osrf/sandia-hand/docs/attachments/SandiaHand(2f)FAQ(2f)PalmTroubleshooting/palm_led.jpg

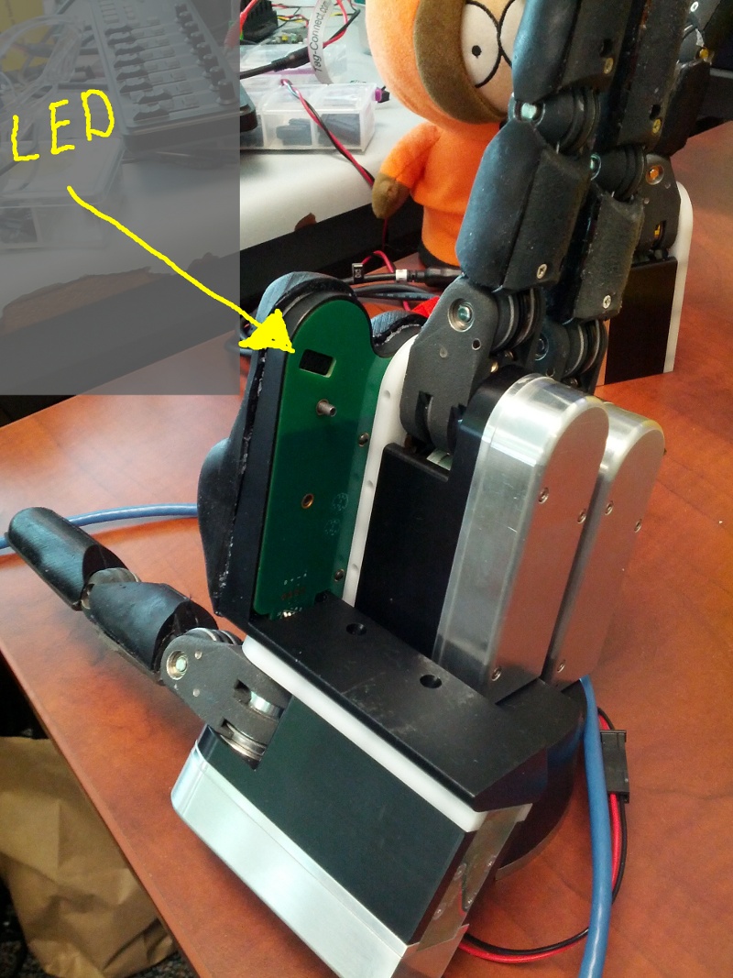
docs/attachments/SandiaHand(2f)FAQ(2f)PalmTroubleshooting/palm_led.jpg
