osrf/sandia-hand/docs/attachments/SandiaHand(2f)HardwareBringup(2f)Homing/SandiaHandsHome.jpg

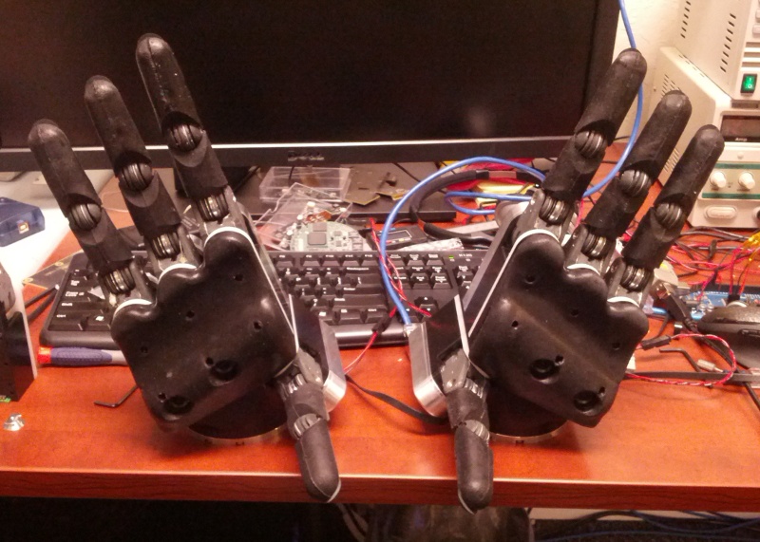
docs/attachments/SandiaHand(2f)HardwareBringup(2f)Homing/SandiaHandsHome.jpg
