osrf/sandia-hand/README.md

# Sandia Hand

Documentation is hosted from the `docs` directory of this repo via GitHub Pages and can be reached here:
[Sandia Hand Documentation and User's Manual](https://osrf.github.io/sandia-hand/)
