osrf/sandia-hand/docs/attachments/SandiaHand(2f)Overview(2f)Electrical/rpalm_tactile_array.png

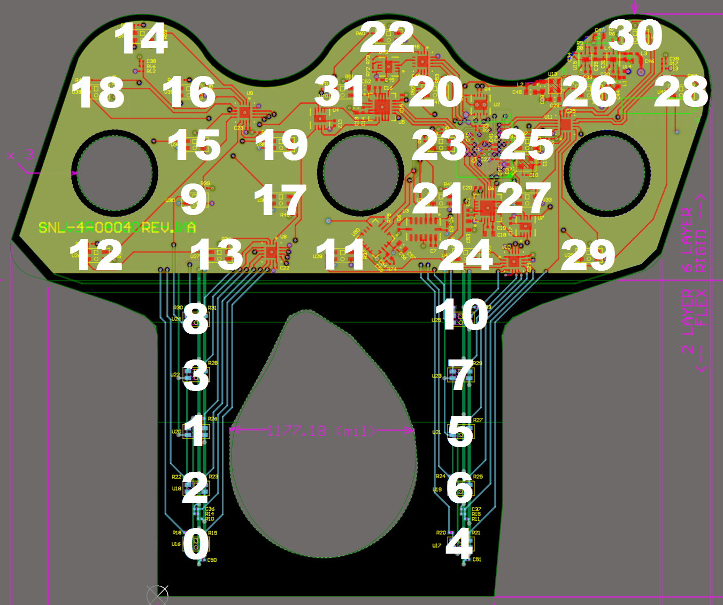
docs/attachments/SandiaHand(2f)Overview(2f)Electrical/rpalm_tactile_array.png
