osrf/sandia-hand/ros/sandia_hand_description/meshes/f1.stl

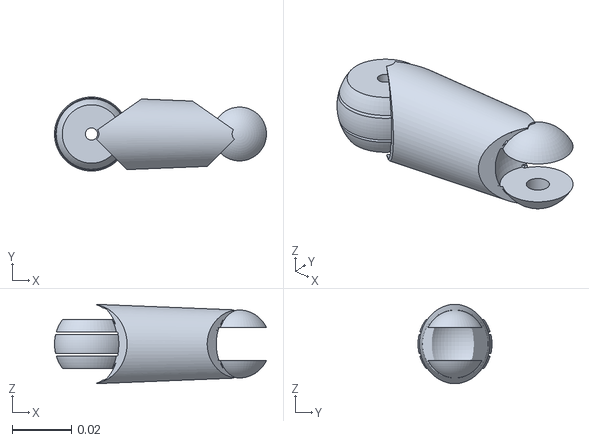
[picture p4: CAD file, 2012-12-11]
ros/sandia_hand_description/meshes/f1.stl
0.0716 x 0.025 x 0.0267
