osrf/sandia-hand/ros/sandia_hand_description/meshes/f0.stl

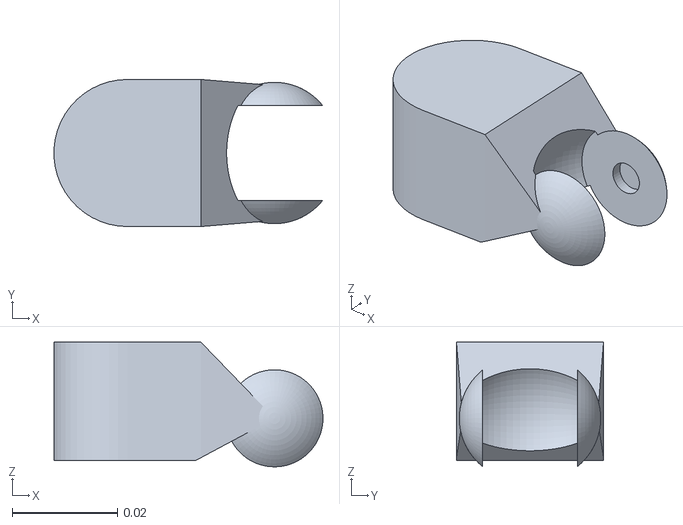
[picture p5: CAD file, 2012-12-11]
ros/sandia_hand_description/meshes/f0.stl
0.0512 x 0.028 x 0.0237
