osrf/sandia-hand/ros/sandia_hand_description/meshes/palm.stl

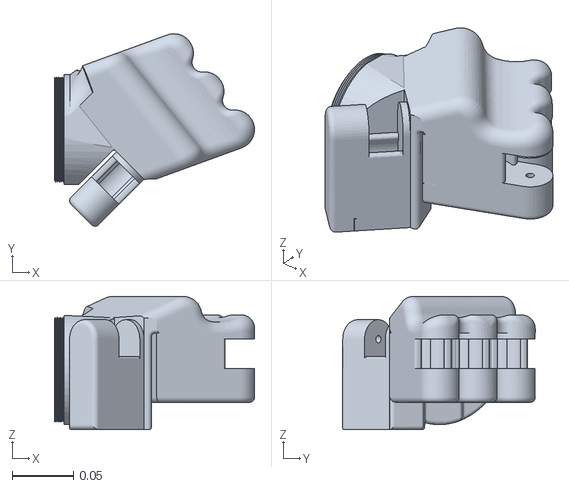
[picture p6: CAD file, 2012-12-11]
ros/sandia_hand_description/meshes/palm.stl
0.164 x 0.158 x 0.109
