osrf/sandia-hand/ros/sandia_hand_description/meshes/f2.stl

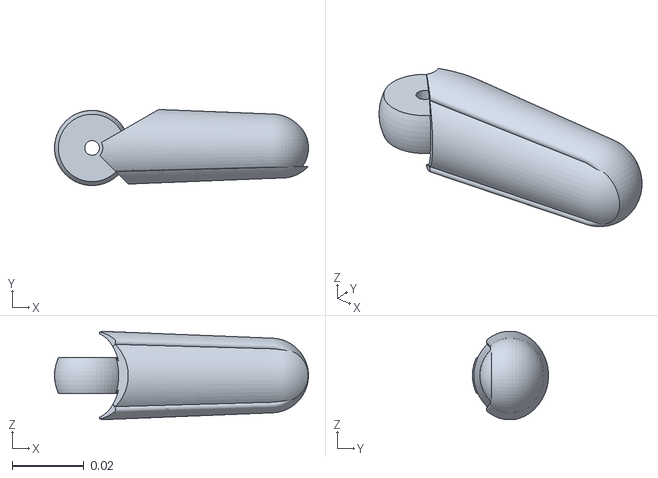
[picture p7: CAD file, 2012-12-11]
ros/sandia_hand_description/meshes/f2.stl
0.0709 x 0.0213 x 0.0247
