osrf/sandia-hand/docs/attachments/SandiaHand(2f)HardwareBringup(2f)Fuse/fuse_installation.png

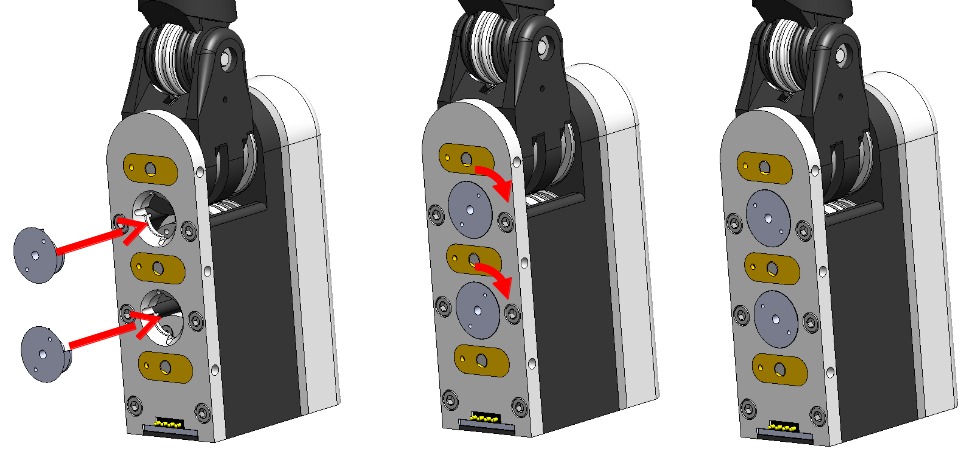
docs/attachments/SandiaHand(2f)HardwareBringup(2f)Fuse/fuse_installation.png
