osrf/sandia-hand/docs/attachments/SandiaHand(2f)HardwareBringup(2f)CableTensioning/tensioning.png

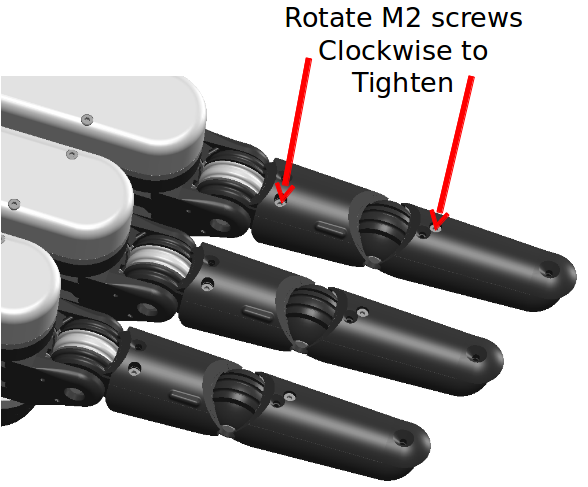
docs/attachments/SandiaHand(2f)HardwareBringup(2f)CableTensioning/tensioning.png
