osrf/sandia-hand/docs/attachments/SandiaHand(2f)HardwareBringup(2f)FingerAttachment/finger_attachment.png

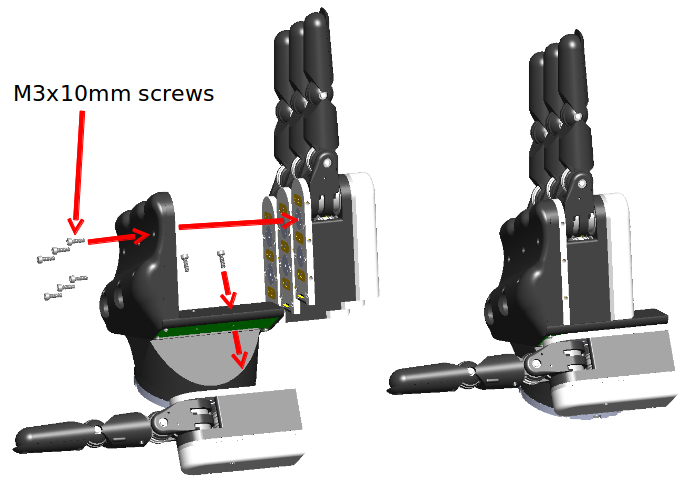
docs/attachments/SandiaHand(2f)HardwareBringup(2f)FingerAttachment/finger_attachment.png
