osrf/sandia-hand/ros/sandia_hand_description/urdf/sandia_hand.urdf.xacro

<?xml version="1.0"?>

<robot name="sandia_hand" xmlns:xacro="http://www.ros.org/wiki/xacro">

  <xacro:include filename="$(find sandia_hand_description)/urdf/sandia_hand.gazebo.xacro" />
  <xacro:include filename="$(find sandia_hand_description)/urdf/sandia_hand.transmission.xacro" />

  <xacro:property name="M_pi" value="3.1415926535897931" />
  <xacro:property name="damping_coefficient_j0" value="1.0" />
  <xacro:property name="damping_coefficient_j1" value="1.0" />
  <xacro:property name="damping_coefficient_j2" value="1.0" />
  <xacro:property name="velocity_limit" value="-1" />

  <xacro:macro name="finger" params="idx x y z r p yaw side reflect joint_type">
    <link name="${side}_f${idx}_base">
      <origin xyz="0 0 0" rpy="0 0 0"/>
      <inertial>
        <!-- total mass is 2.303 kg, palm is about 1.303 kg, distribute the rest into _base -->
        <mass value="0.250"/> <!-- (2.303 - 1.303) / 4 -->
        <origin xyz="0 0 0"/>
        <!-- model as sphere with radius of 1cm -->
        <inertia ixx="0.00001" ixy="0" ixz="0" iyy="0.00001" iyz="0" izz="0.00001"/>
      </inertial>
    </link>
    <link name="${side}_f${idx}_fixed_accel">
      <origin xyz="0 0 0" rpy="0 0 0"/>
      <inertial>
        <mass value="0.01"/>
        <origin xyz="0 0 0"/>
        <inertia ixx="0.000001" ixy="0" ixz="0" iyy="0.000001" iyz="0" izz="0.000001"/>
      </inertial>
    </link>
    <link name="${side}_f${idx}_0">
      <origin xyz="0 0 0" rpy="0 0 0"/>
      <inertial>
        <mass value="0.106"/> <!-- F1 -->
        <origin xyz="0 0 0"/>
        <!-- solid cylinder -->
        <inertia ixx="0.000011925" ixy="0" ixz="0" iyy="0.00011505" iyz="0" izz="0.00011505"/>
      </inertial>
      <collision>
        <origin xyz="0 0 0" rpy="0 0 0"/>
        <geometry>
          <mesh filename="package://sandia_hand_description/meshes/f0.stl"/>
        </geometry>
      </collision>
      <visual>
        <origin xyz="0 0 0" rpy="0 0 0"/>
        <geometry>
          <mesh filename="package://sandia_hand_description/meshes/f0.stl"/>
        </geometry>
        <material name="${side}_sandia_hand_skin_suntan">
          <color rgba="0.7 0.4 0.2 1.0"/>
        </material>
      </visual>
    </link>
    <link name="${side}_f${idx}_1">
      <origin xyz="0 0 0" rpy="0 0 0"/>
      <inertial>
        <mass value="0.033"/> <!-- F2 -->
        <origin xyz="0 0 0"/>
        <!-- solid cylinder -->
        <inertia ixx="0.00000165" ixy="0" ixz="0" iyy="0.00001316975" iyz="0" izz="0.00001316975"/>
      </inertial>
      <collision>
        <origin xyz="0 0 0" rpy="0 0 0"/>
        <geometry>
          <mesh filename="package://sandia_hand_description/meshes/f1.stl"/>
        </geometry>
      </collision>
      <visual>
        <origin xyz="0 0 0" rpy="0 0 0"/>
        <geometry>
          <mesh filename="package://sandia_hand_description/meshes/f1.stl"/>
        </geometry>
        <material name="${side}_sandia_hand_skin">
          <color rgba="0.835 0.655 0.345 1.0"/>
        </material>
      </visual>
    </link>
    <link name="${side}_f${idx}_1_accel">
      <origin xyz="0 0 0" rpy="0 0 0"/>
      <inertial>
        <mass value="0.01"/>
        <origin xyz="0 0 0"/>
        <inertia ixx="0.000001" ixy="0" ixz="0" iyy="0.000001" iyz="0" izz="0.000001"/>
      </inertial>
    </link>
    <link name="${side}_f${idx}_2">
      <origin xyz="0 0 0" rpy="0 0 0"/>
      <inertial>
        <mass value="0.033"/>  <!-- F3 -->
        <origin xyz="0 0 0"/>
        <!-- solid cylinder -->
        <inertia ixx="0.0000013365" ixy="0" ixz="0" iyy="0.000009603" iyz="0" izz="0.000009603"/>
      </inertial>
      <collision>
        <origin xyz="0 0 0" rpy="0 0 0"/>
        <geometry>
          <mesh filename="package://sandia_hand_description/meshes/f2.stl"/>
        </geometry>
      </collision>
      <visual>
        <origin xyz="0 0 0" rpy="0 0 0"/>
        <geometry>
          <mesh filename="package://sandia_hand_description/meshes/f2.stl"/>
        </geometry>
        <material name="${side}_sandia_hand_skin_suntan">
          <color rgba="0.8 0.6 0.3 1.0"/>
        </material>
      </visual>
    </link>
    <link name="${side}_f${idx}_2_accel">
      <origin xyz="0 0 0" rpy="0 0 0"/>
      <inertial>
        <mass value="0.01"/>
        <origin xyz="0 0 0"/>
        <inertia ixx="0.000001" ixy="0" ixz="0" iyy="0.000001" iyz="0" izz="0.000001"/>
      </inertial>
    </link>

    <joint name="${side}_f${idx}_base" type="fixed">
      <parent link="${side}_palm"/>
      <child link="${side}_f${idx}_base"/>
      <origin xyz="${x} ${y} ${z}" rpy="${r} ${p} ${yaw}"/>
    </joint>
    <joint name="${side}_f${idx}_j0" type="${joint_type}">
      <axis xyz="0 0 ${reflect}"/>
      <parent link="${side}_f${idx}_base"/>
      <child link="${side}_f${idx}_0"/>
      <limit lower="-${M_pi/2}" upper="${M_pi/2}" effort="11" velocity="${velocity_limit}"/>
      <safety_controller soft_lower_limit="${-1.57079-10.0}" soft_upper_limit="${1.57079+10.0}" k_position="1000.0" k_velocity="1000.0"/>
      <dynamics damping="${damping_coefficient_j0}"/>
      <origin xyz="0 0 0" rpy="0 0 0"/>
    </joint>
    <joint name="${side}_f${idx}_j1" type="${joint_type}">
      <axis xyz="0 0 1"/>
      <parent link="${side}_f${idx}_0"/>
      <child link="${side}_f${idx}_1"/>
      <limit lower="-${M_pi/2}" upper="${M_pi/2}" effort="28" velocity="${velocity_limit}"/>
      <safety_controller soft_lower_limit="${-1.57079-10.0}" soft_upper_limit="${1.57079+10.0}" k_position="1000.0" k_velocity="1000.0"/>
      <dynamics damping="${damping_coefficient_j1}"/>
      <origin xyz="0.028 0 0" rpy="${M_pi/2} 0 0"/>
    </joint>
    <joint name="${side}_f${idx}_j2" type="${joint_type}">
      <axis xyz="0 0 1"/>
      <parent link="${side}_f${idx}_1"/>
      <child link="${side}_f${idx}_2"/>
      <origin xyz="0.05 0 0" rpy="0 0 0"/>
      <safety_controller soft_lower_limit="${-1.57079-10.0}" soft_upper_limit="${1.57079+10.0}" k_position="1000.0" k_velocity="1000.0"/>
      <dynamics damping="${damping_coefficient_j2}"/>
      <limit lower="-${M_pi/2}" upper="${M_pi/2}" effort="28" velocity="${velocity_limit}"/>
    </joint>

    <joint name="${side}_f${idx}_fixed_accel" type="fixed">
      <parent link="${side}_f${idx}_base"/>
      <child link="${side}_f${idx}_fixed_accel"/>
      <origin xyz="-0.05 0 0" rpy="0 0 0"/>
    </joint>
    <joint name="${side}_f${idx}_1_accel" type="fixed">
      <parent link="${side}_f${idx}_1"/>
      <child link="${side}_f${idx}_1_accel"/>
      <origin xyz="0.03 0 0" rpy="-${M_pi/2} 0 0"/>
    </joint>
    <joint name="${side}_f${idx}_2_accel" type="fixed">
      <parent link="${side}_f${idx}_2"/>
      <child link="${side}_f${idx}_2_accel"/>
      <origin xyz="0.04 0 0" rpy="-${M_pi/2} 0 0"/>
    </joint>

    <xacro:finger_transmission side="${side}" idx="${idx}" x="${x}" y="${y}" z="${z}" r="${r}" p="${p}" yaw="${yaw}"/>
    <xacro:finger_gazebo side="${side}" idx="${idx}"/>
  </xacro:macro>

  <xacro:macro name="sandia_hand" params="side parent reflect joint_type thumb_angle *origin">
    <link name="${side}_palm">
      <origin xyz="0 0 0" rpy="0 0 0"/>
      <inertial>
        <mass value="1.303"/>
        <origin xyz="0 0 0"/>
        <!-- solid sphere with 5cm radius -->
        <inertia ixx="0.001303" ixy="0" ixz="0" iyy="0.001303" iyz="0" izz="0.001303"/>
      </inertial>
      <collision>
        <origin xyz="0 0 0" rpy="0 0 0"/>
        <geometry>
          <mesh filename="package://sandia_hand_description/meshes/palm.stl"/>
        </geometry>
      </collision>
      <visual>
        <origin xyz="0 0 0" rpy="0 0 0"/>
        <geometry>
          <mesh filename="package://sandia_hand_description/meshes/palm.stl"/>
        </geometry>
        <material name="${side}_sandia_hand_skin">
          <color rgba="0.835 0.655 0.345 1.0"/>
        </material>
      </visual>
    </link>

    <joint name="${side}_sandia_hand_joint" type="fixed">
      <parent link="${parent}"/>
      <child link="${side}_palm"/>
      <insert_block name="origin" />
    </joint>

    <xacro:finger side="${side}" idx="0" x="0.140" y="0.00000" z="0" r="0" p="0" yaw="${0.3*reflect}" reflect="${reflect}" joint_type="${joint_type}"/>
    <xacro:finger side="${side}" idx="1" x="0.115" y="${0.03122*reflect}" z="0" r="0" p="0" yaw="${0.3*reflect}" reflect="${reflect}" joint_type="${joint_type}"/>
    <xacro:finger side="${side}" idx="2" x="0.090" y="${0.06245*reflect}" z="0" r="0" p="0" yaw="${0.3*reflect}" reflect="${reflect}" joint_type="${joint_type}"/>
    <xacro:finger side="${side}" idx="3" x="0.03995" y="${-0.04383*reflect}" z="0.014" r="0" p="-${M_pi/2 + thumb_angle}" yaw="${-(2.3562+thumb_angle)*reflect}" reflect="${reflect}" joint_type="${joint_type}"/>

    <!-- not needed unless simulating the hand by itself
    <xacro:sandia_hand_gazebo_controller side="${side}" />
    -->
    <xacro:sandia_hand_gazebo side="${side}" />
    <xacro:sandia_hand_cameras_gazebo side="${side}" reflect="${reflect}" parent="${parent}" />
    <xacro:sandia_hand_tactile_sensors_gazebo side="${side}" parent="${parent}" />
    <xacro:sandia_hand_imu_sensor_gazebo parent="${parent}" />
  </xacro:macro>
</robot>
