osrf/sandia-hand/docs/attachments/SandiaHand(2f)Overview(2f)Electrical/cam.pdf

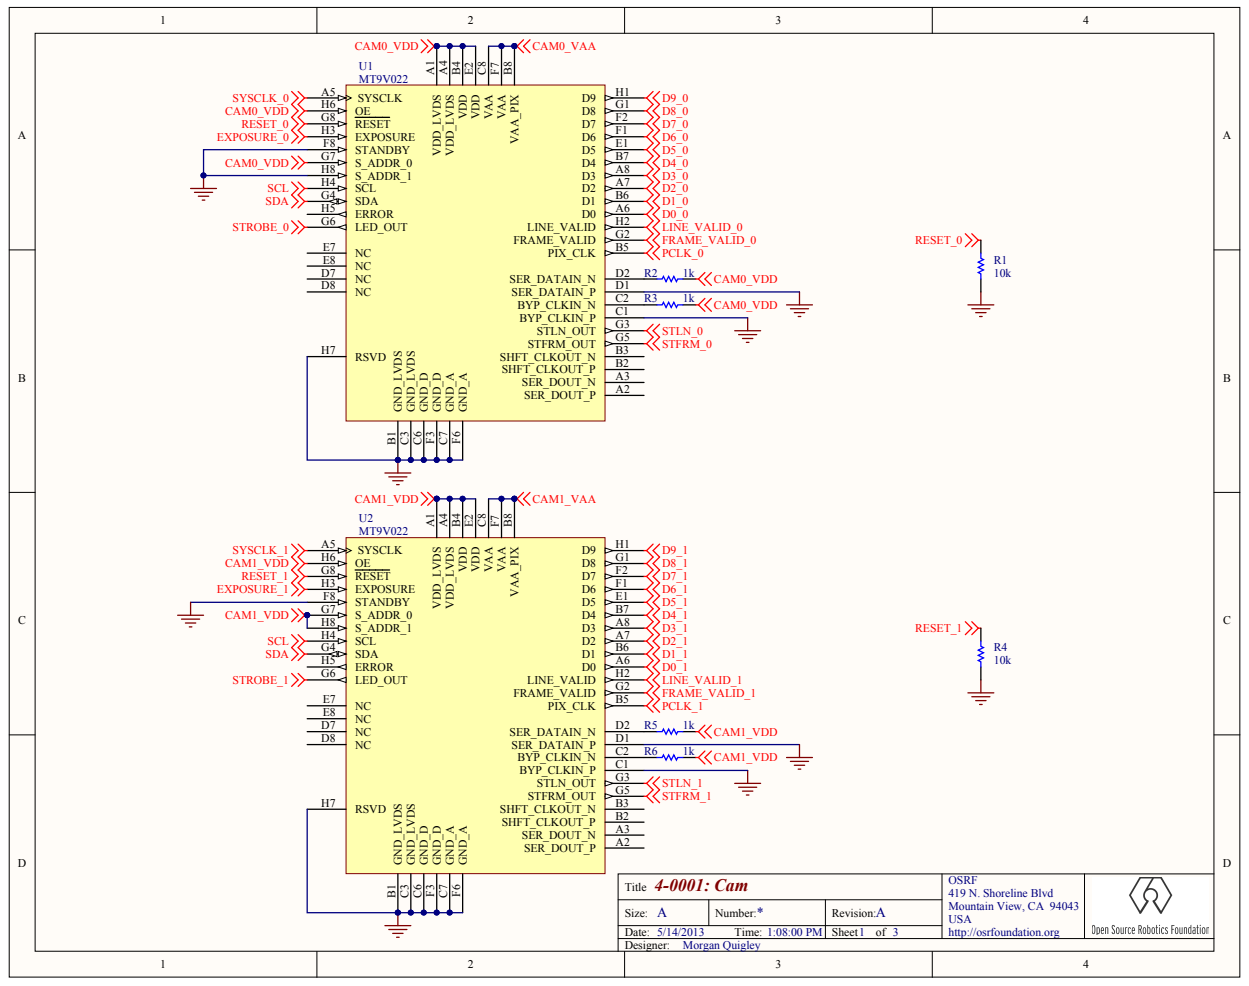
[picture p11: page 1]

4-0001: Cam Title | OSRF 419 N. Shoreline Blvd Mountain View, CA 94043 USA http://osrfoundation.org

Size: A | Number: * | Revision: A
Date: 5/14/2013 Time: 1:08:00 PM | | Sheet of 3

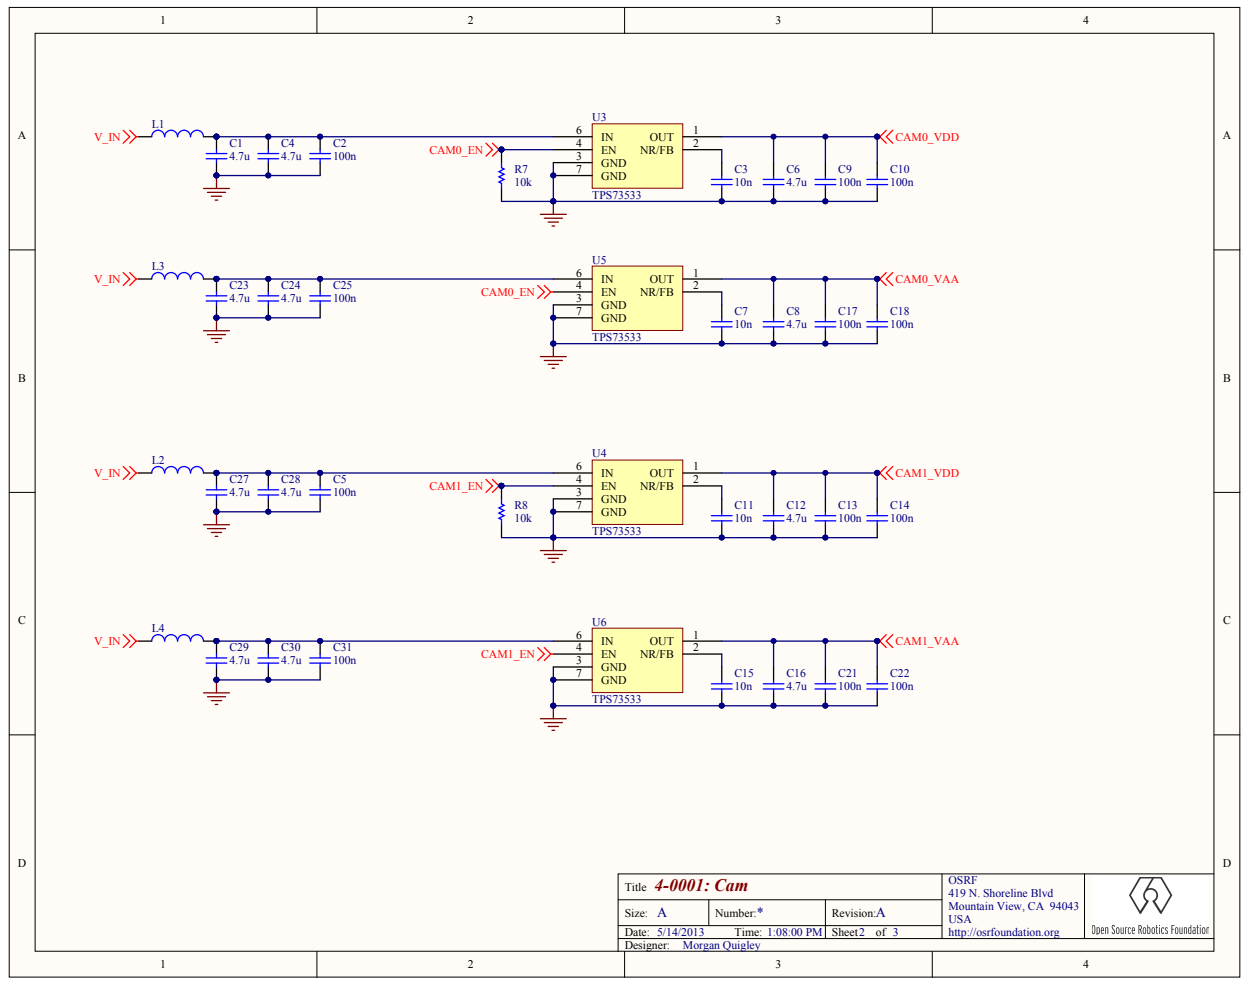
[picture p12: page 2]

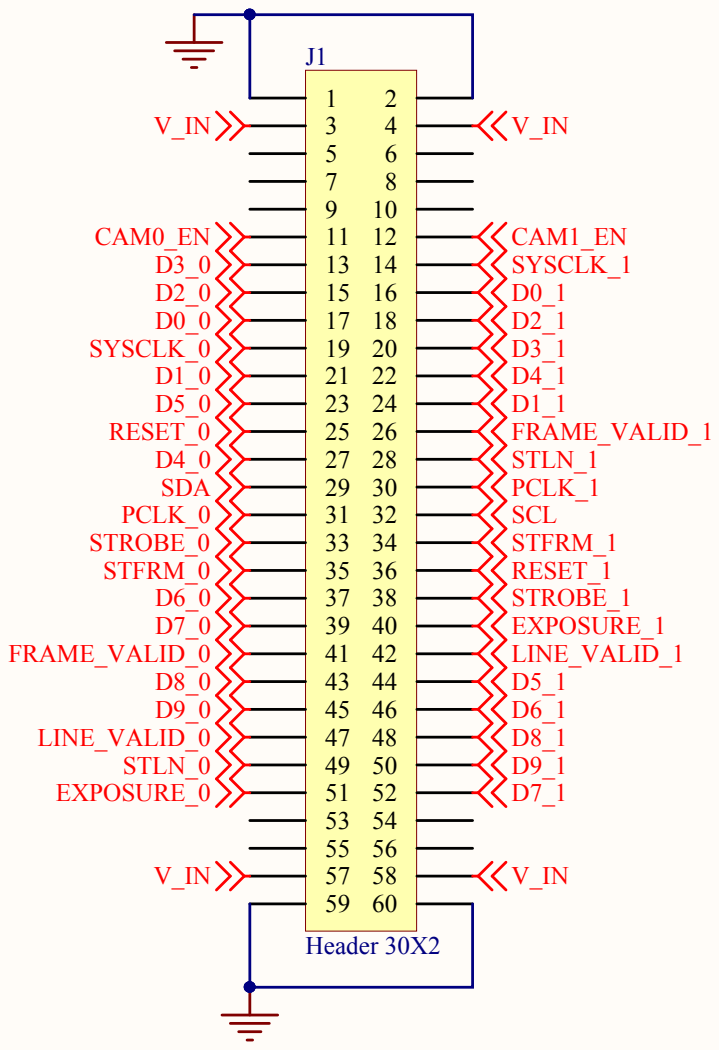
[picture p13: page 3]
