osrf/sandia-hand/docs/attachments/SandiaHand(2f)Overview(2f)Electrical/f2.pdf

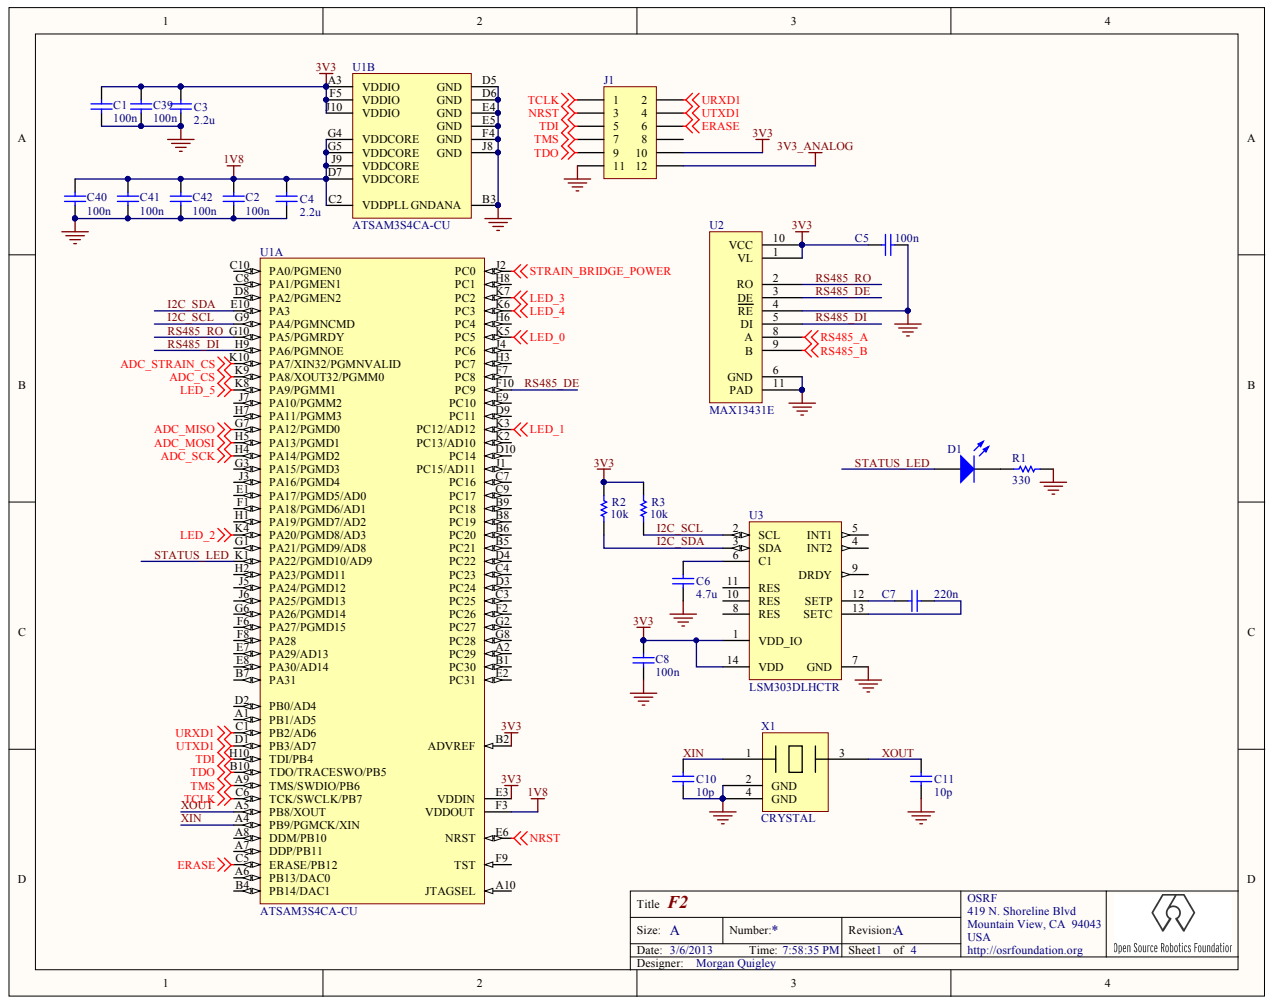
[picture p14: page 1]

F2 Title | OSRF 419 N. Shoreline Blvd Mountain View, CA 94043 USA http://osrfoundation.org

Size: A | Number: * | Revision: A
Date: 3/6/2013 Time: 7:58:35 PM | | Sheet of 4

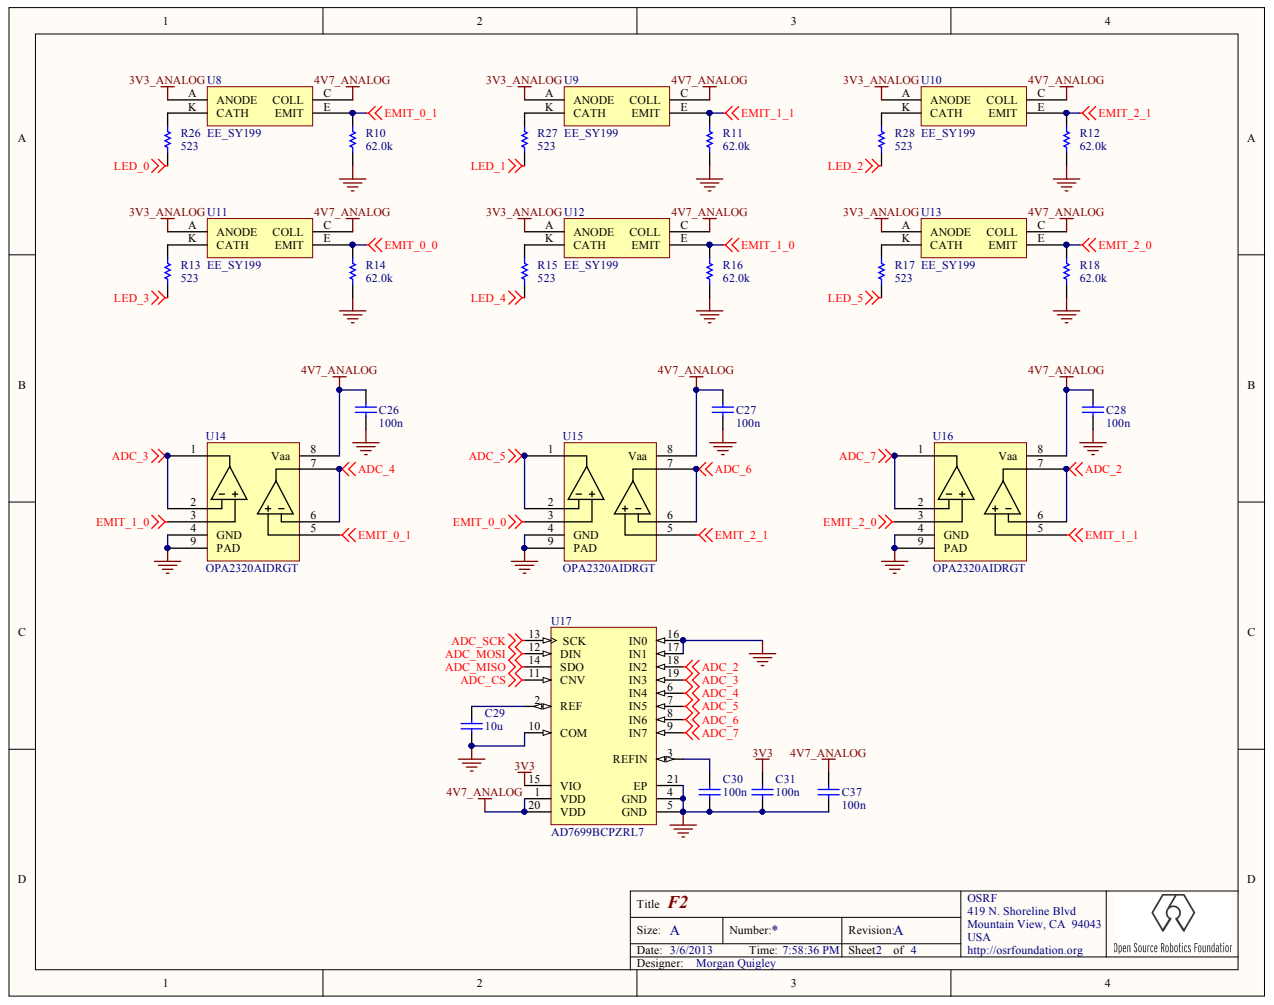
[picture p15: page 2]

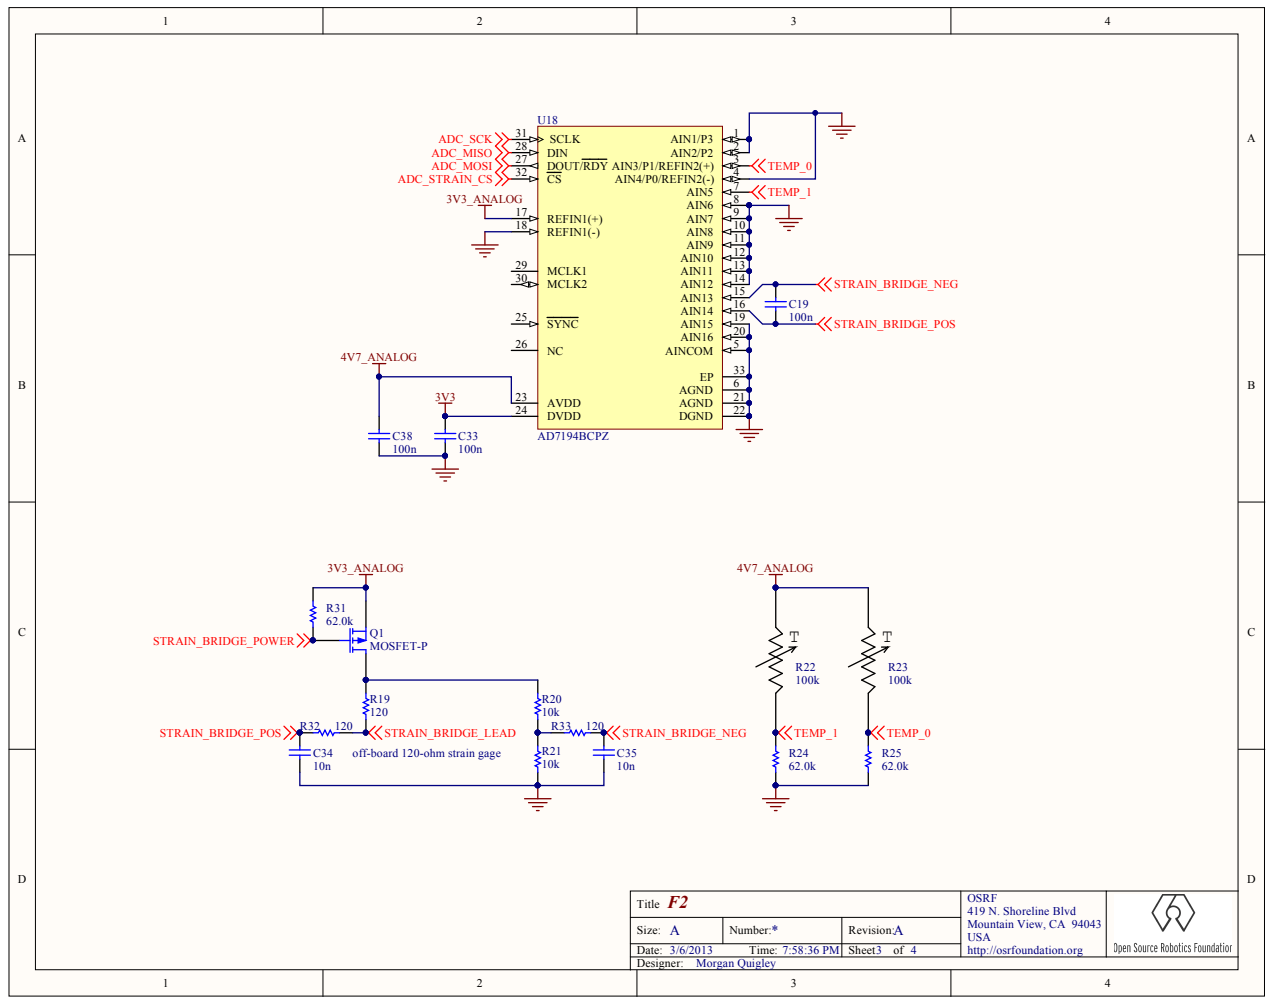
[picture p16: page 3]

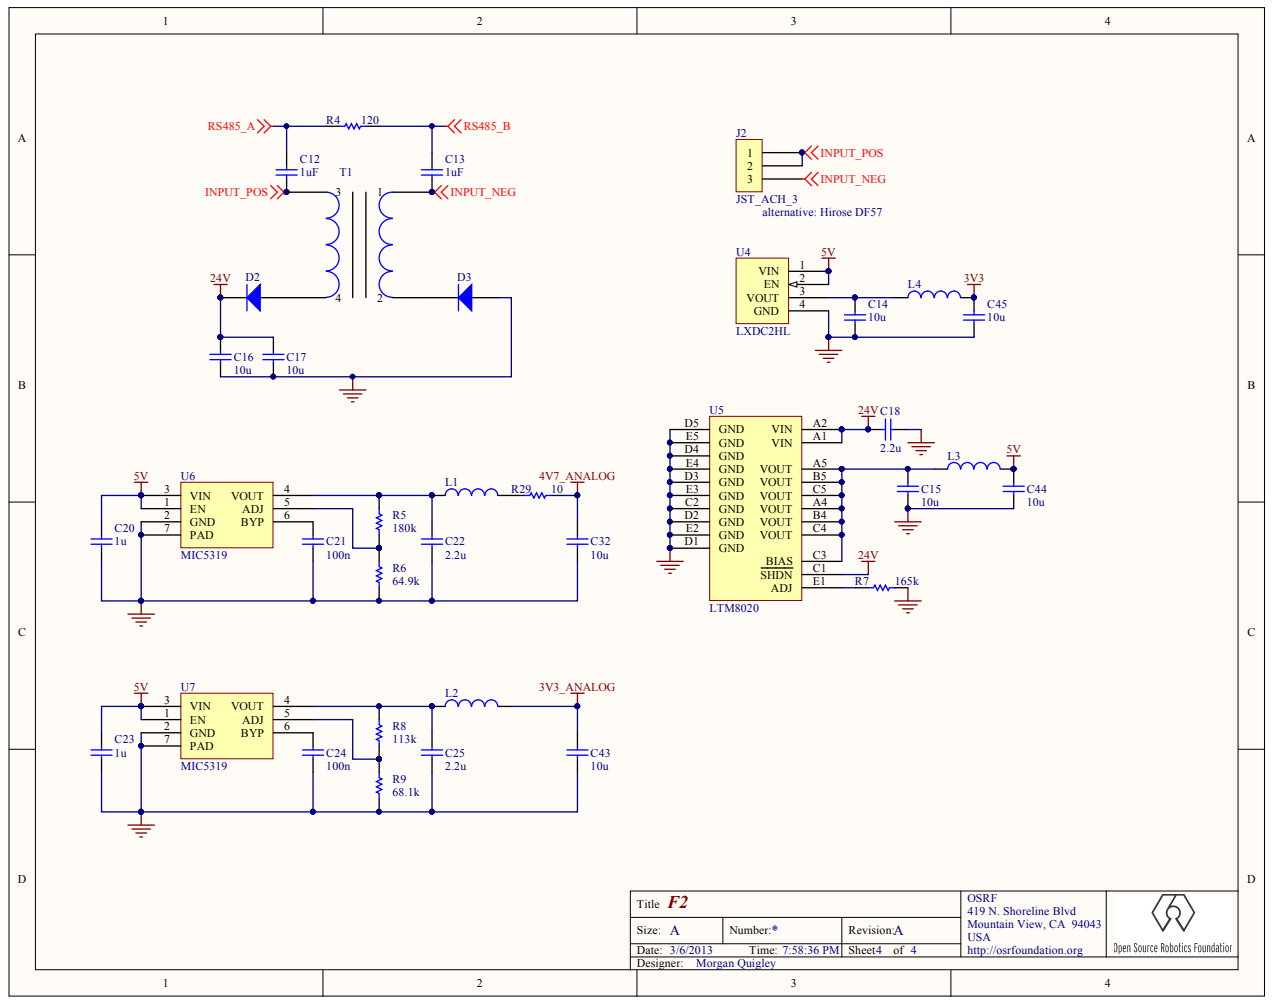
[picture p17: page 4]

PAD 7
