osrf/sandia-hand/docs/attachments/SandiaHand(2f)Overview(2f)Electrical/f3.pdf

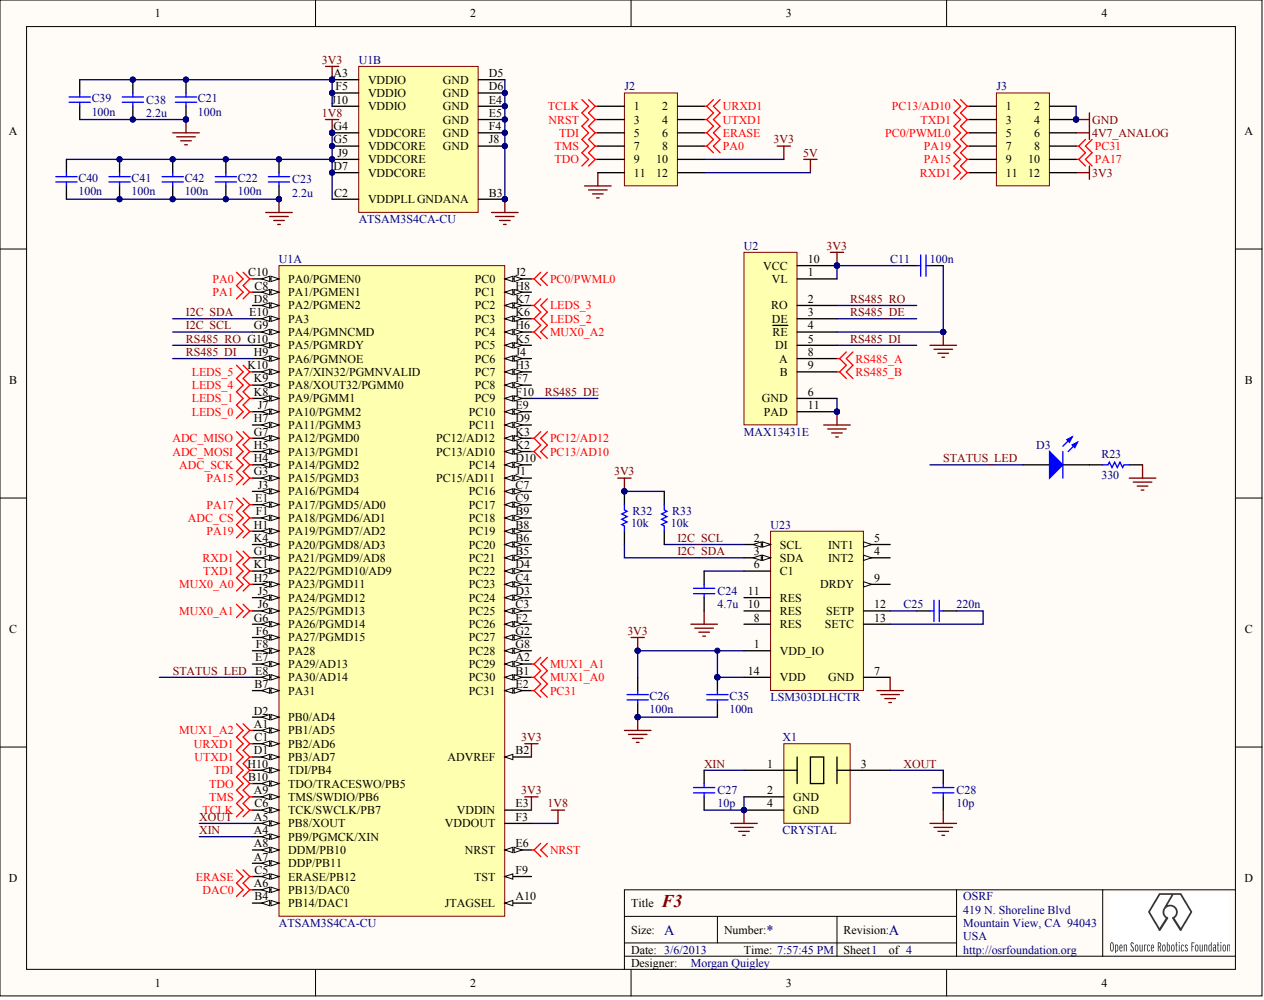
[picture p18: page 1]

F3 Title | OSRF 419 N. Shoreline Blvd Mountain View, CA 94043 USA http://osrfoundation.org

A Size: | * Number: | A Revision:
Date: 3/6/2013 Time: 7:57:45 PM | | Sheet of 4

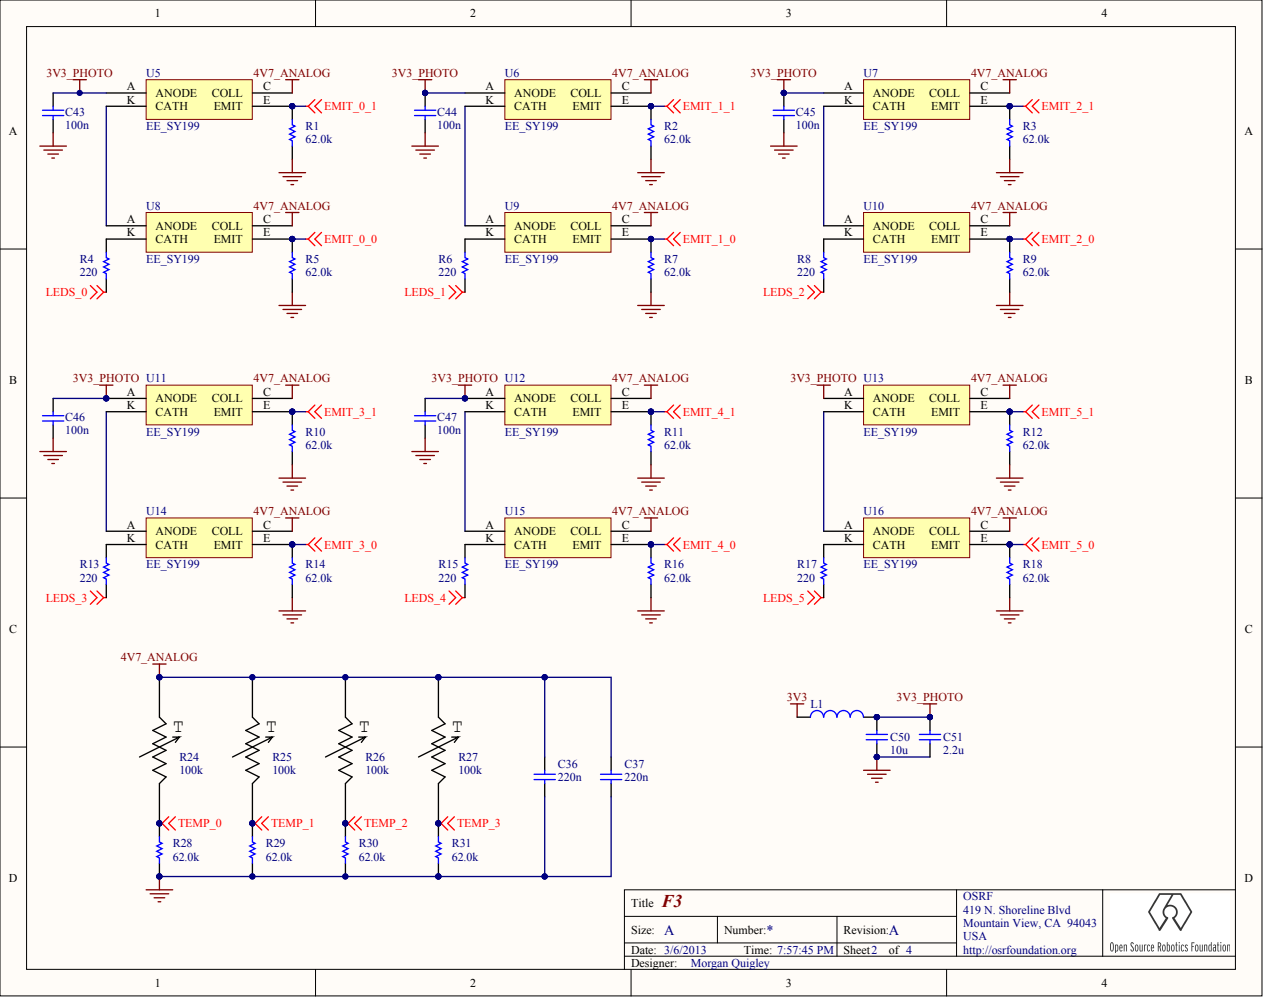
[picture p19: page 2]

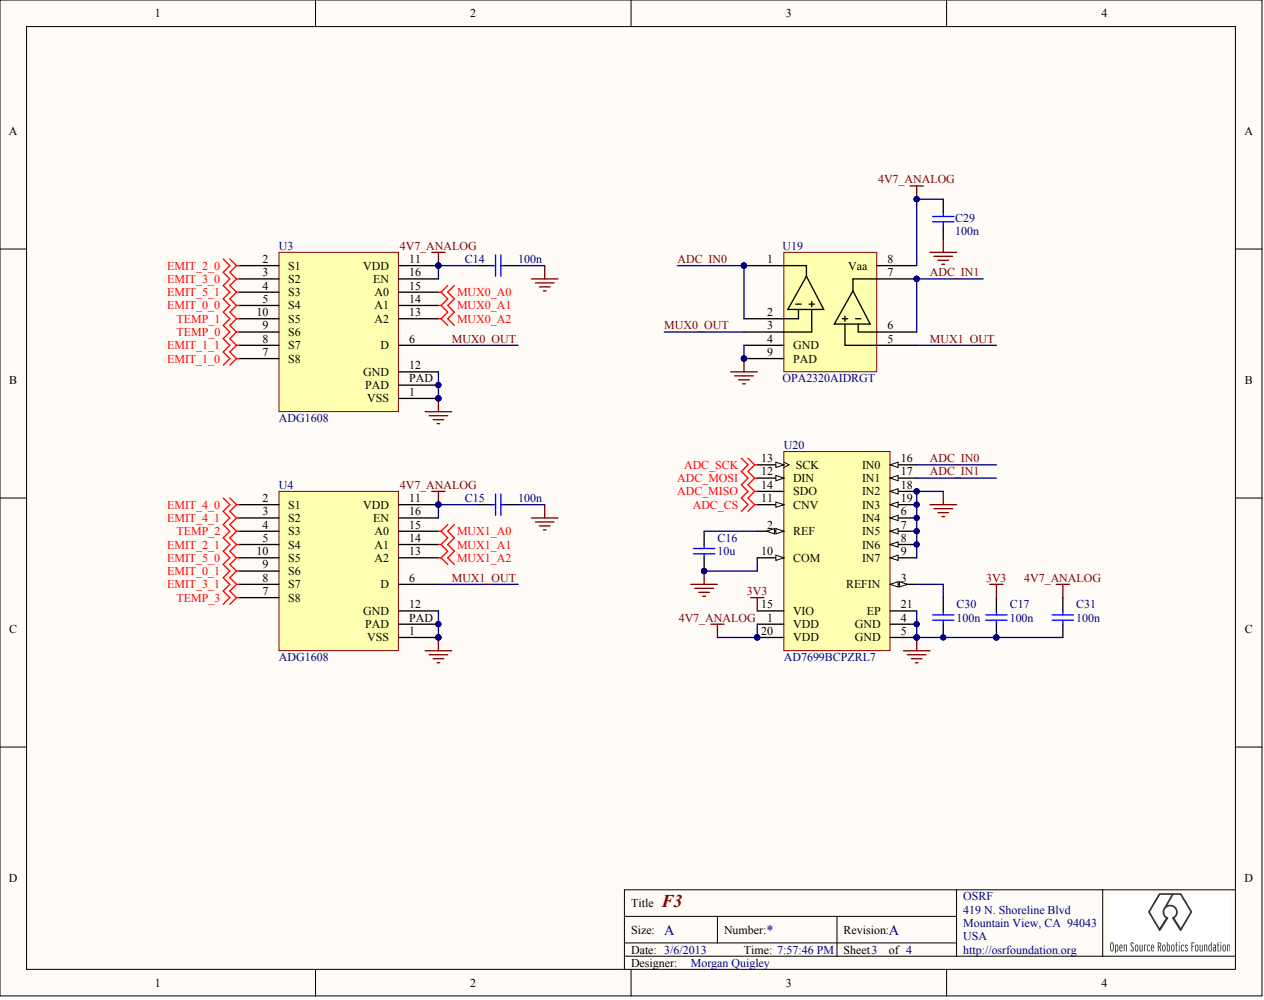
[picture p20: page 3]

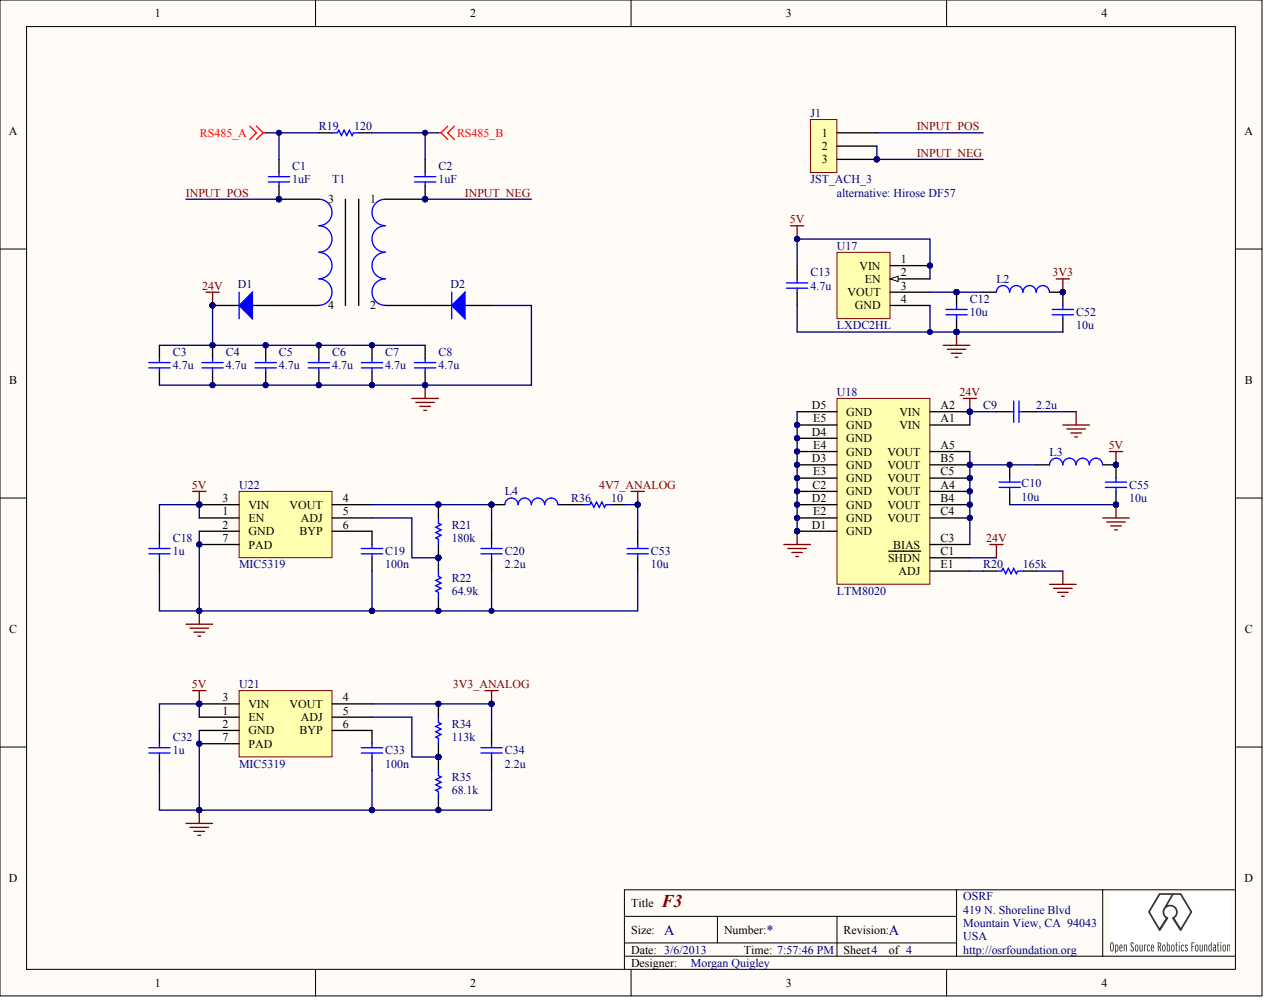
[picture p21: page 4]

4.7u | VOUT | 3

PAD 7
