osrf/sandia-hand/docs/attachments/SandiaHand(2f)Overview(2f)Electrical/fmcb.pdf

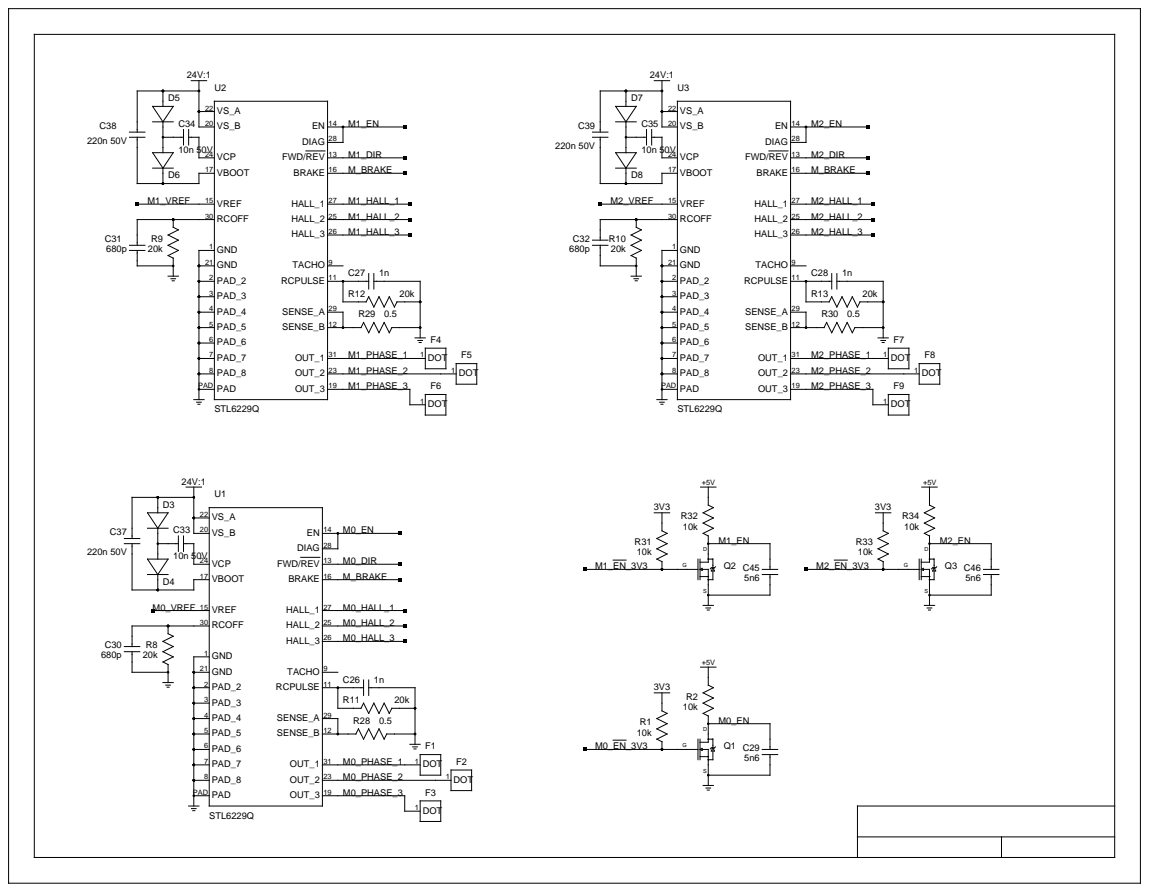
[picture p22: page 1]

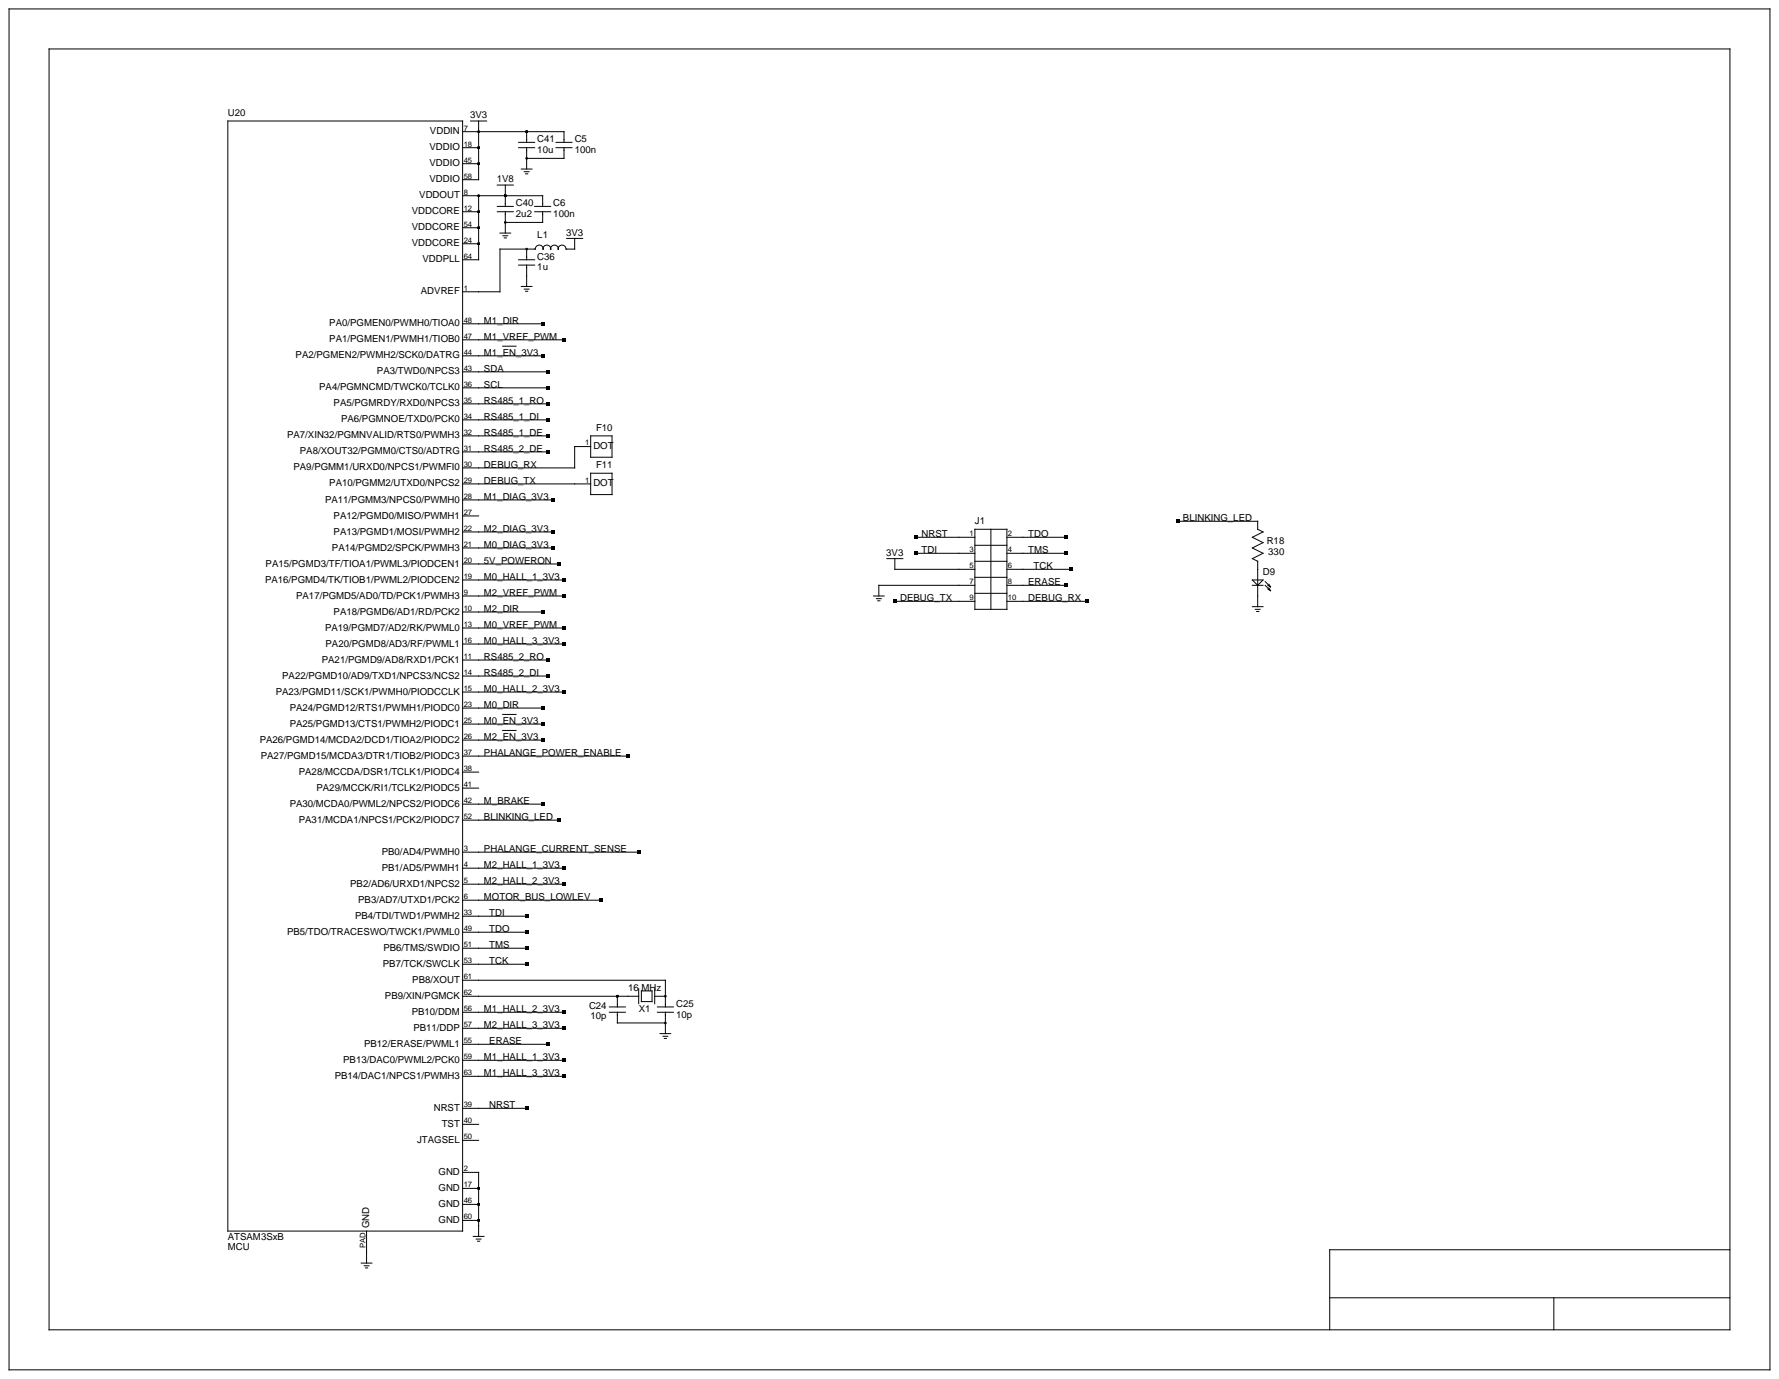
[picture p23: page 2]

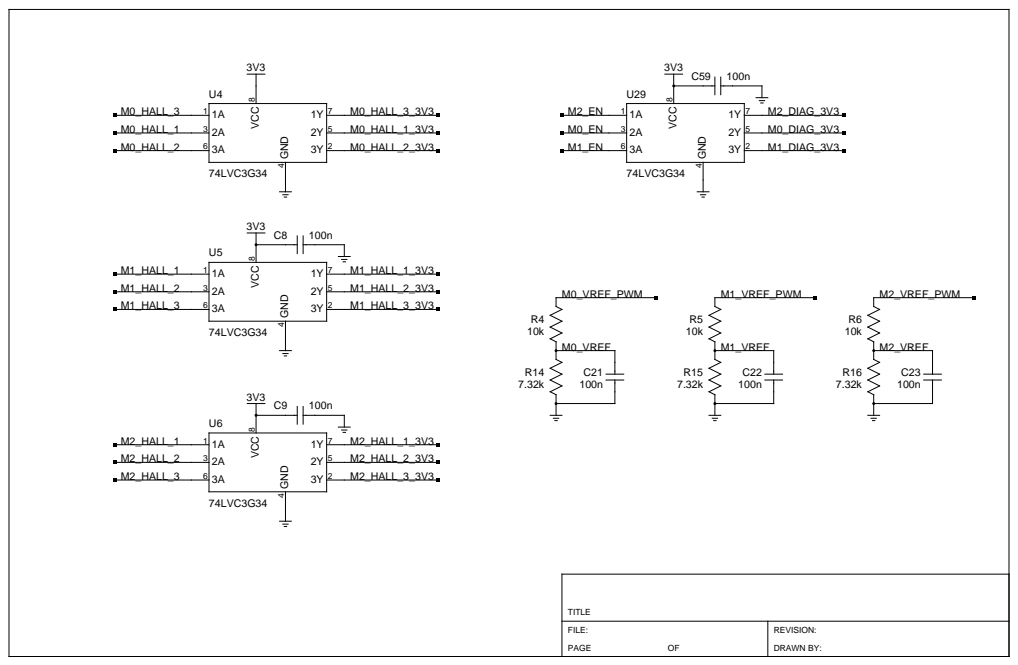
[picture p24: page 3]

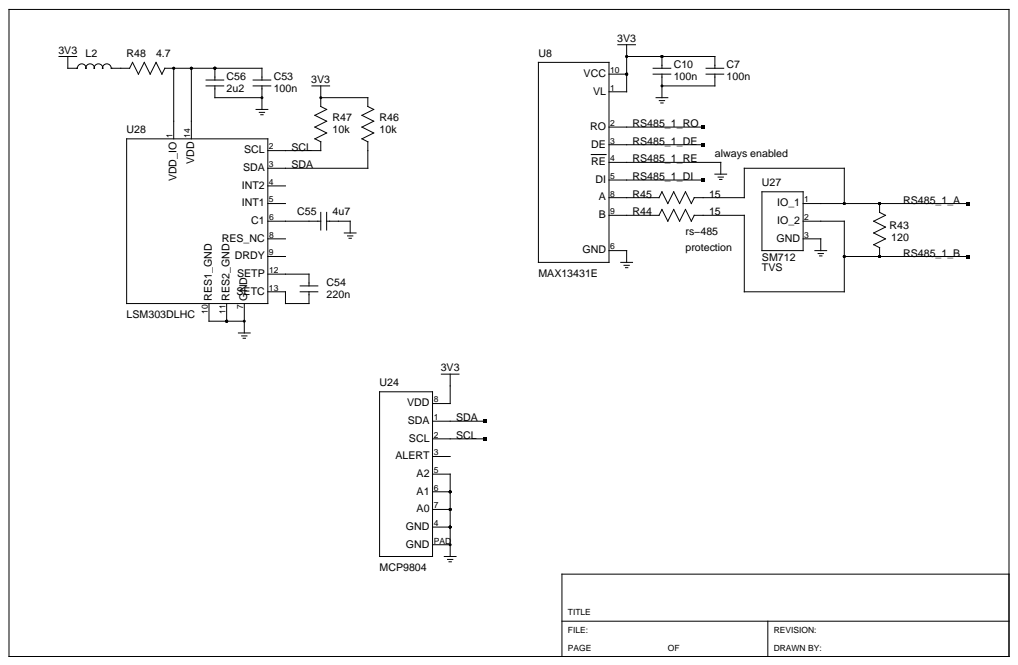
[picture p25: page 4]

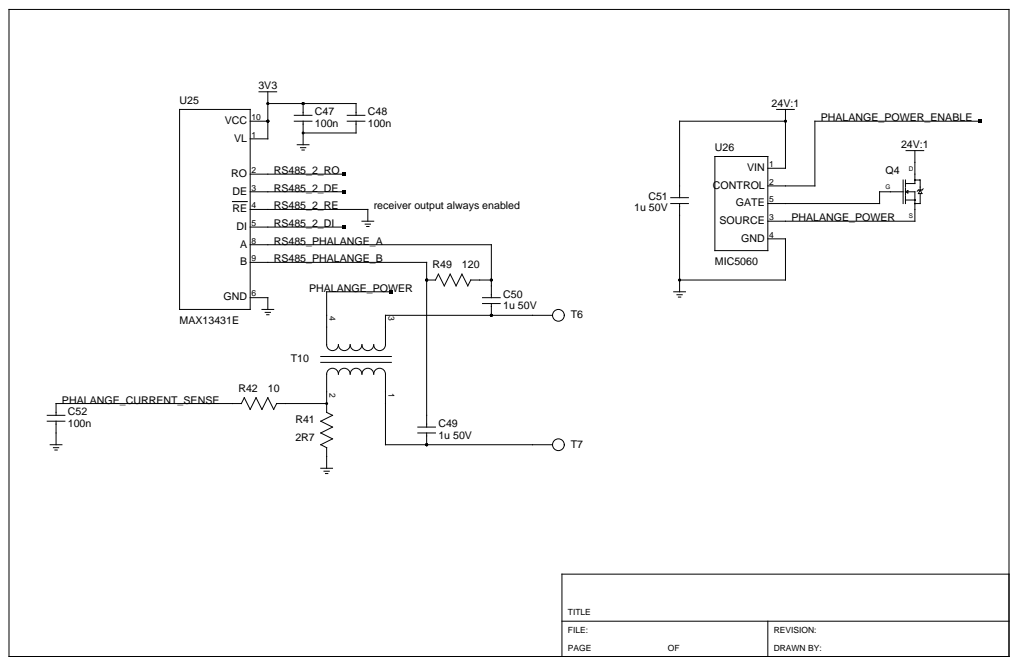
[picture p26: page 5]

receiver output always enabled

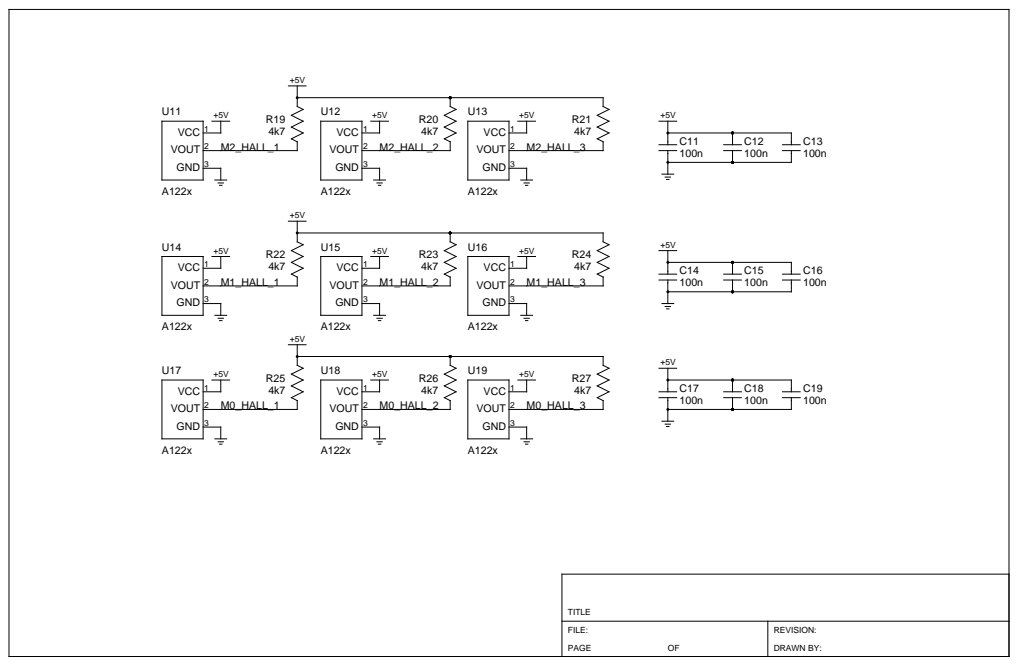
[picture p27: page 6]

3v3 always−on supply | 5v supply
pogo pins | D10

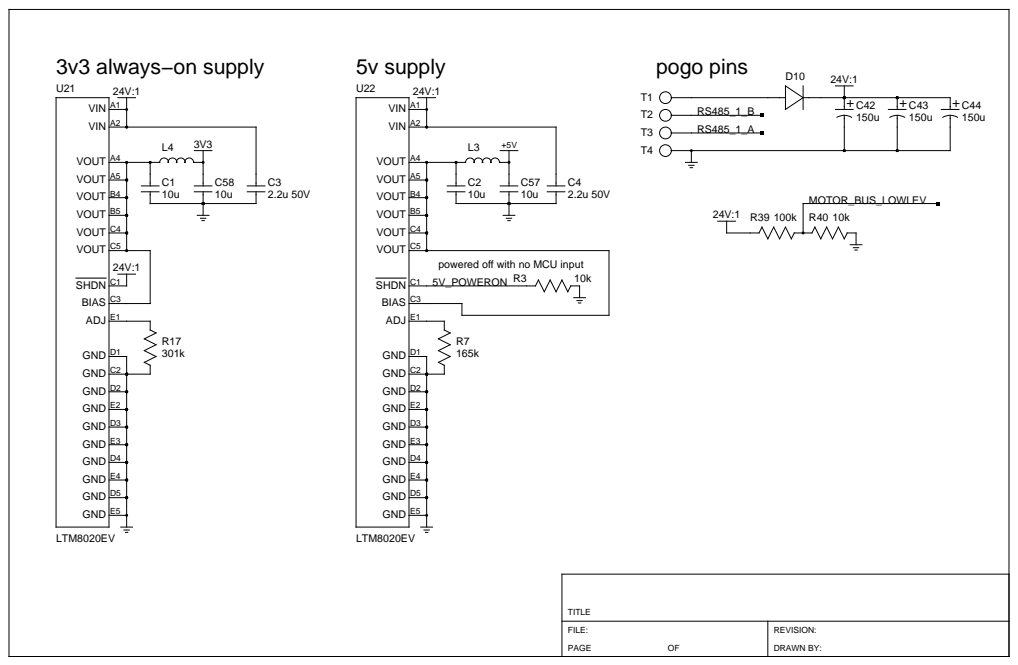
[picture p28: page 7]

powered off with no MCU input
5V_POWERON
