osrf/sandia-hand/docs/attachments/SandiaHand(2f)Overview(2f)Electrical/left_conn.pdf

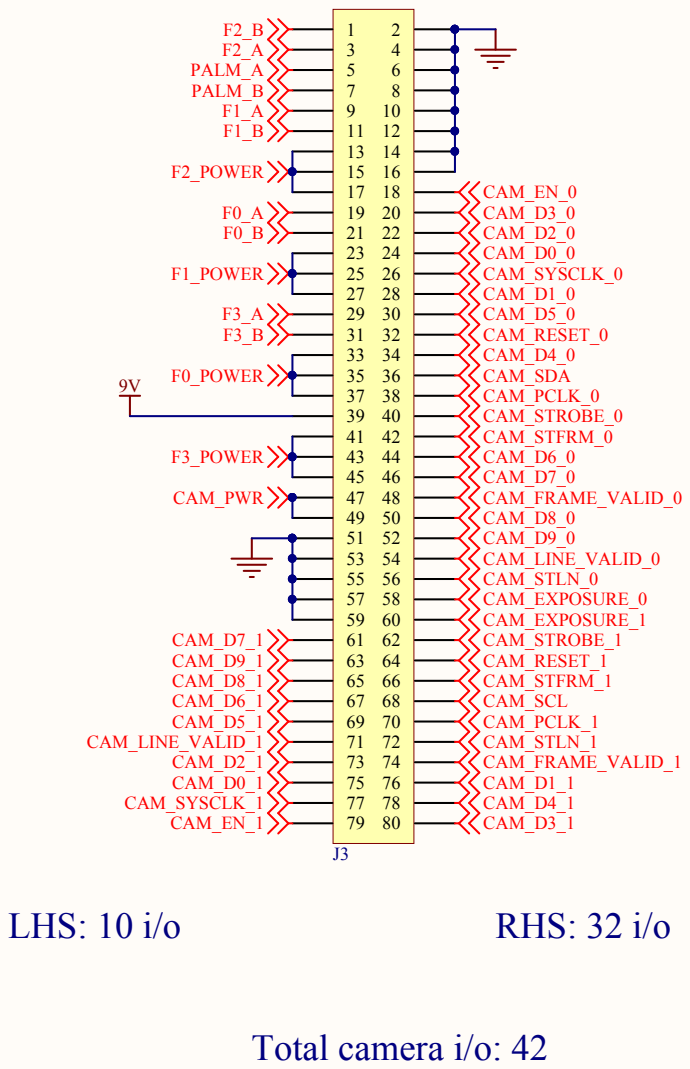
[picture p29: page 1]

Left Conn Title | OSRF 419 N. Shoreline Blvd Mountain View, CA 94043 USA http://osrfoundation.org

Size: A | Number: | Revision:
Date: 3/15/2013 Time: 3:57:52 PM | | Sheet of 4

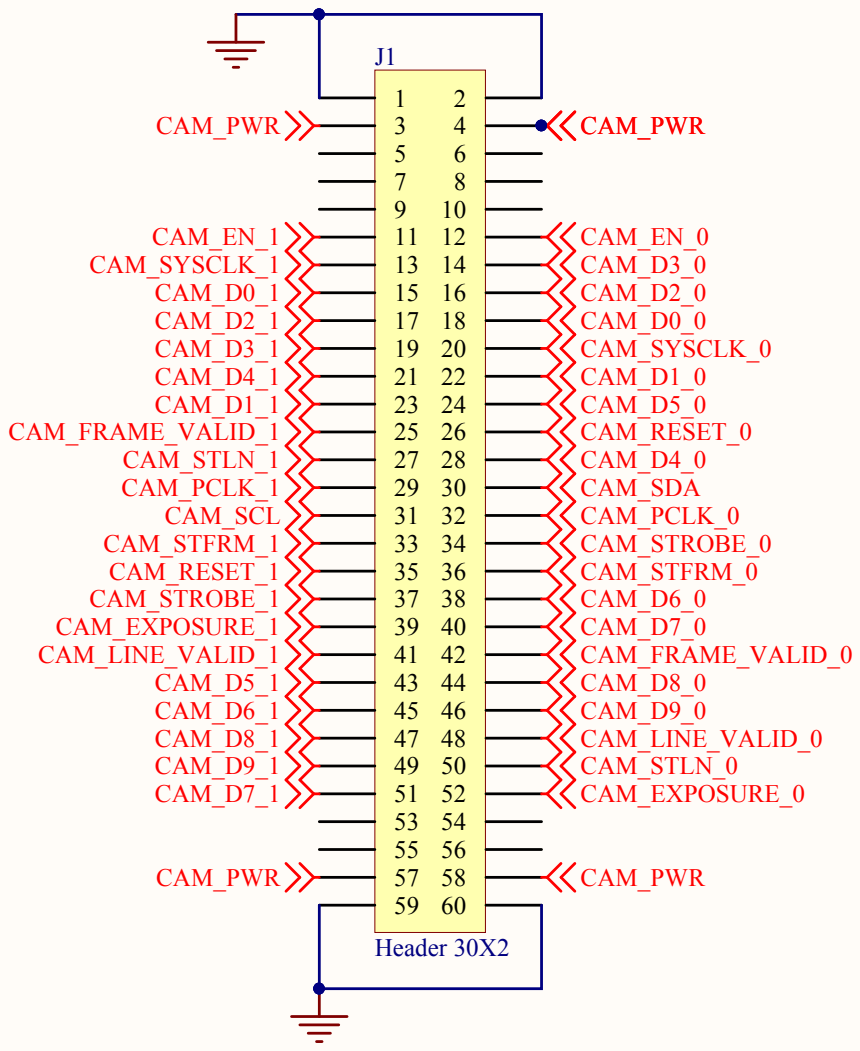
[picture p30: page 2]

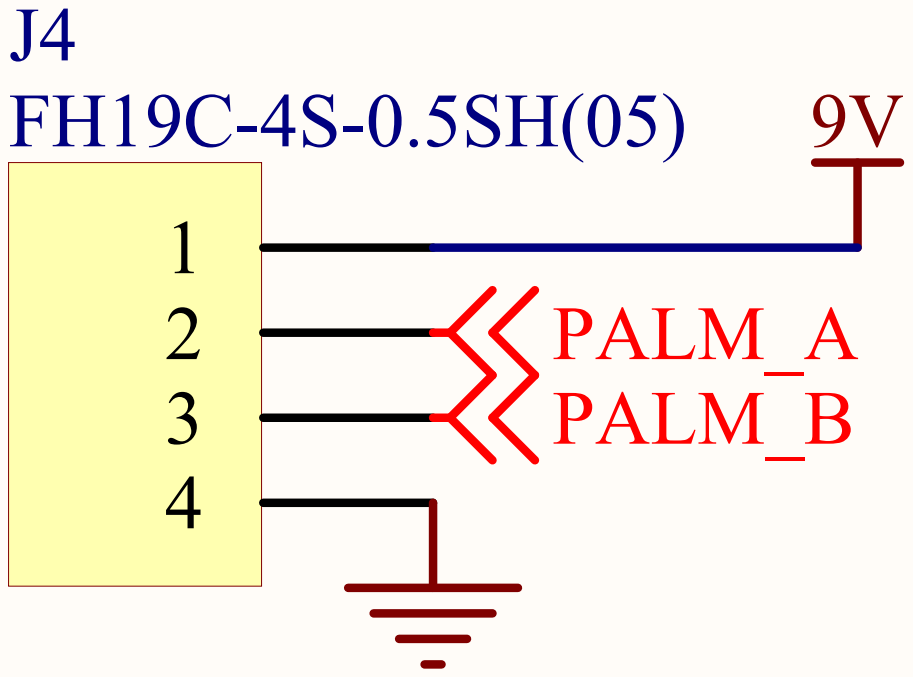
[picture p31: page 3]

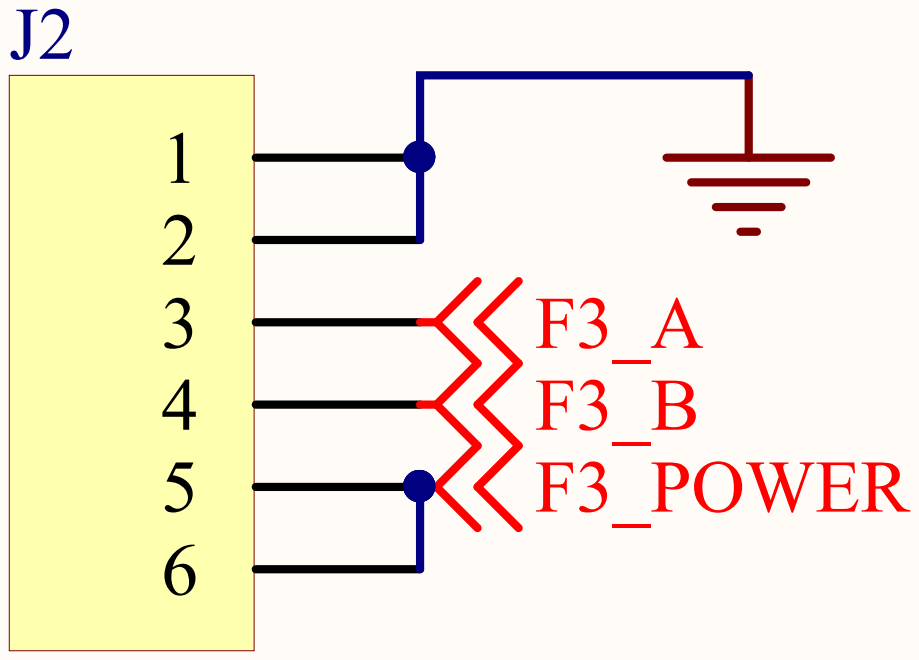
[picture p32: page 4]
