osrf/sandia-hand/docs/attachments/SandiaHand(2f)Overview(2f)Electrical/lpalm.pdf

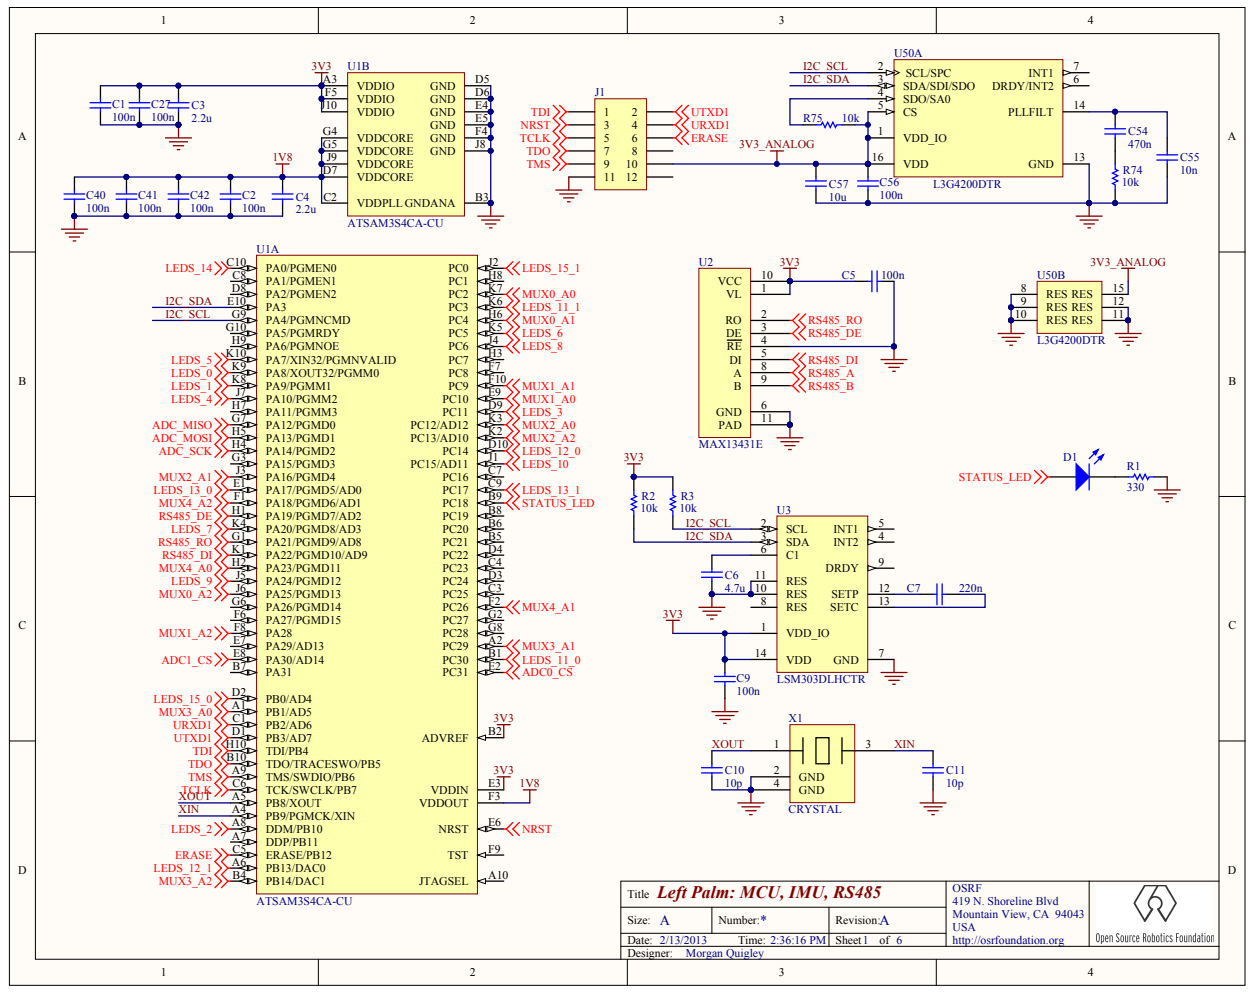
[picture p33: page 1]

Left Palm: MCU, IMU, RS485 Title | OSRF 419 N. Shoreline Blvd Mountain View, CA 94043 USA http://osrfoundation.org

Size: A | Number: * | Revision: A
Date: 2/13/2013 Time: 2:36:16 PM | | Sheet of 6

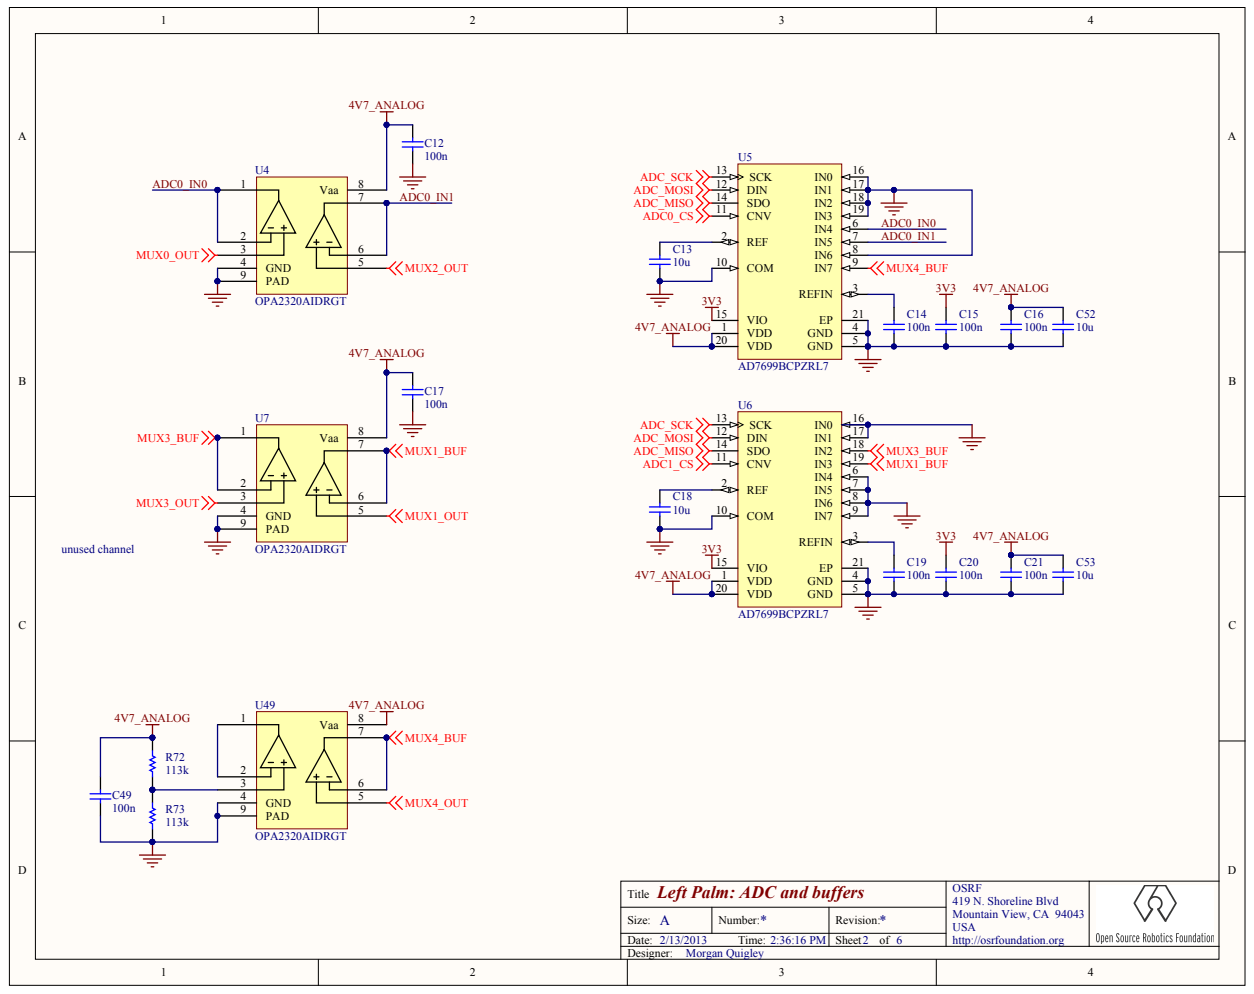
[picture p34: page 2]

Left Palm: ADC and buffers Title | OSRF 419 N. Shoreline Blvd

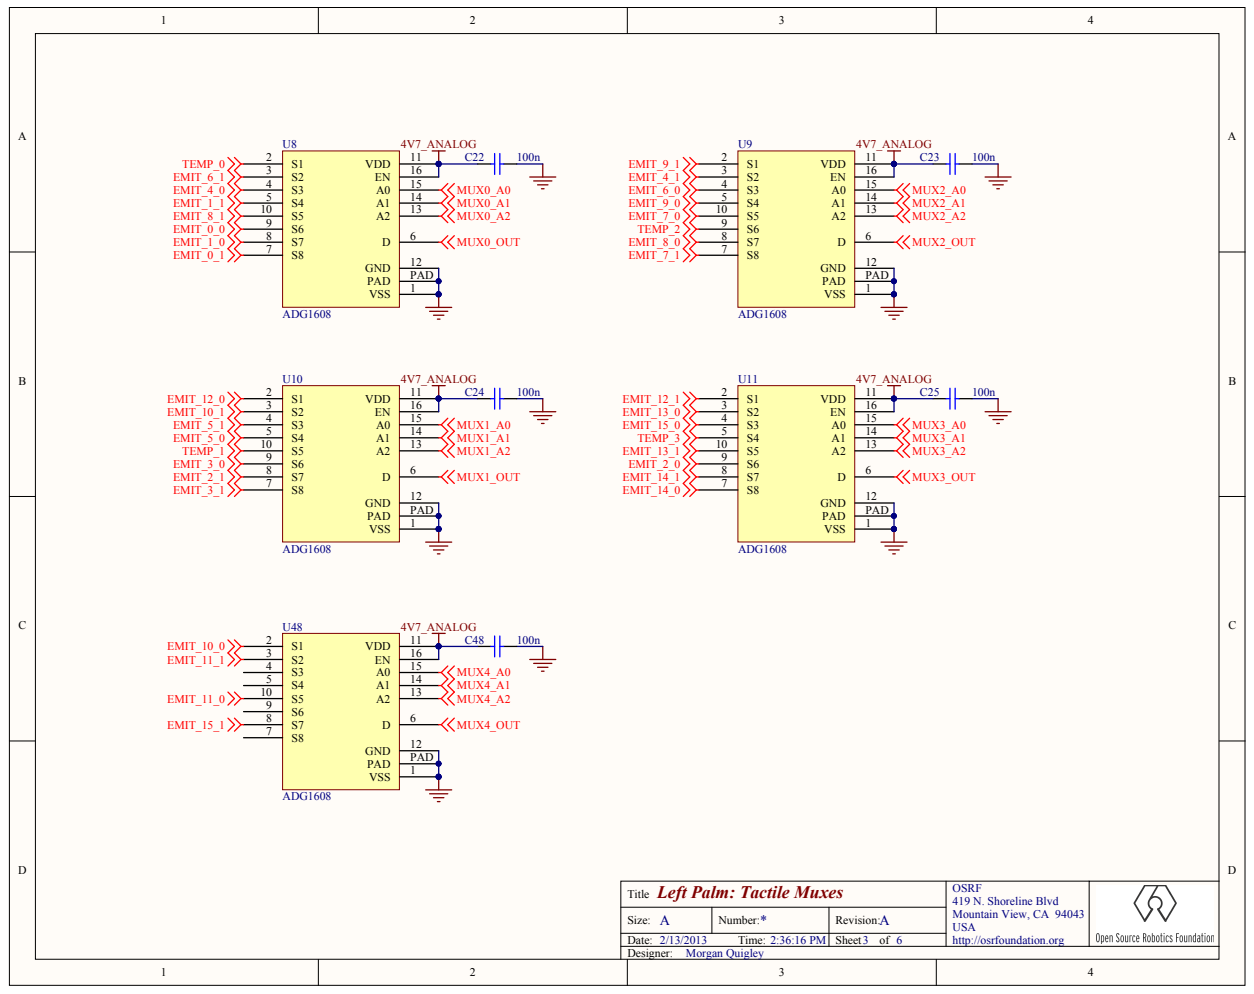
[picture p35: page 3]

Left Palm: Tactile Muxes
Title

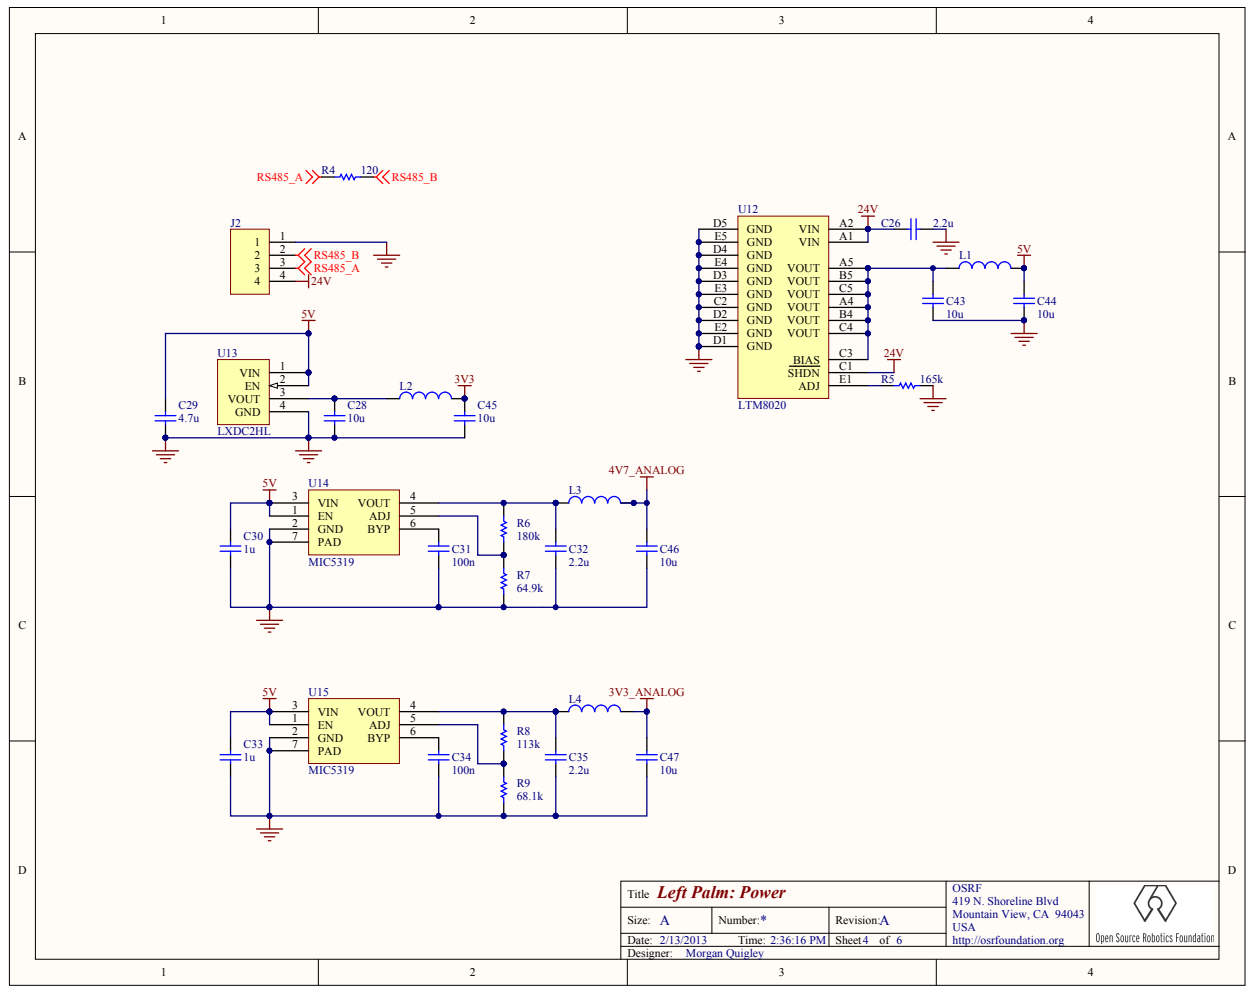
[picture p36: page 4]

PAD 7

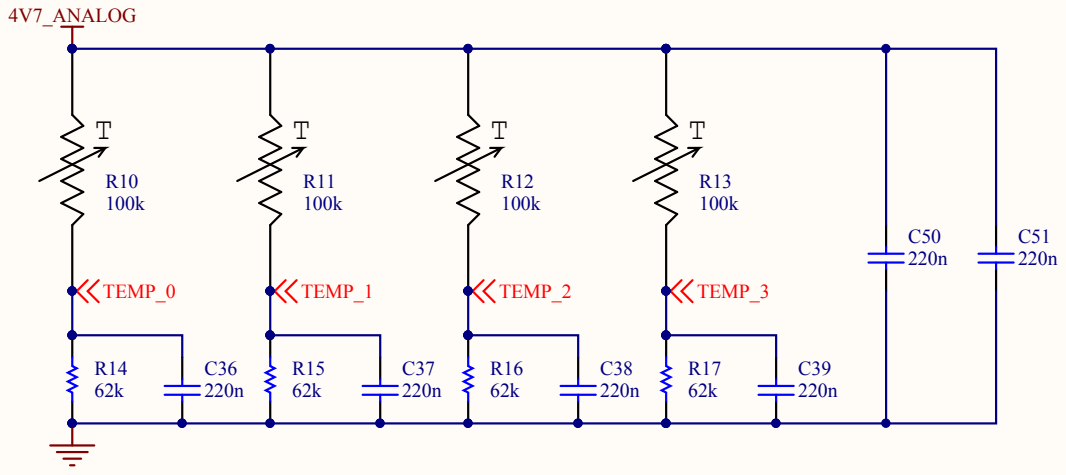
[picture p37: page 5]

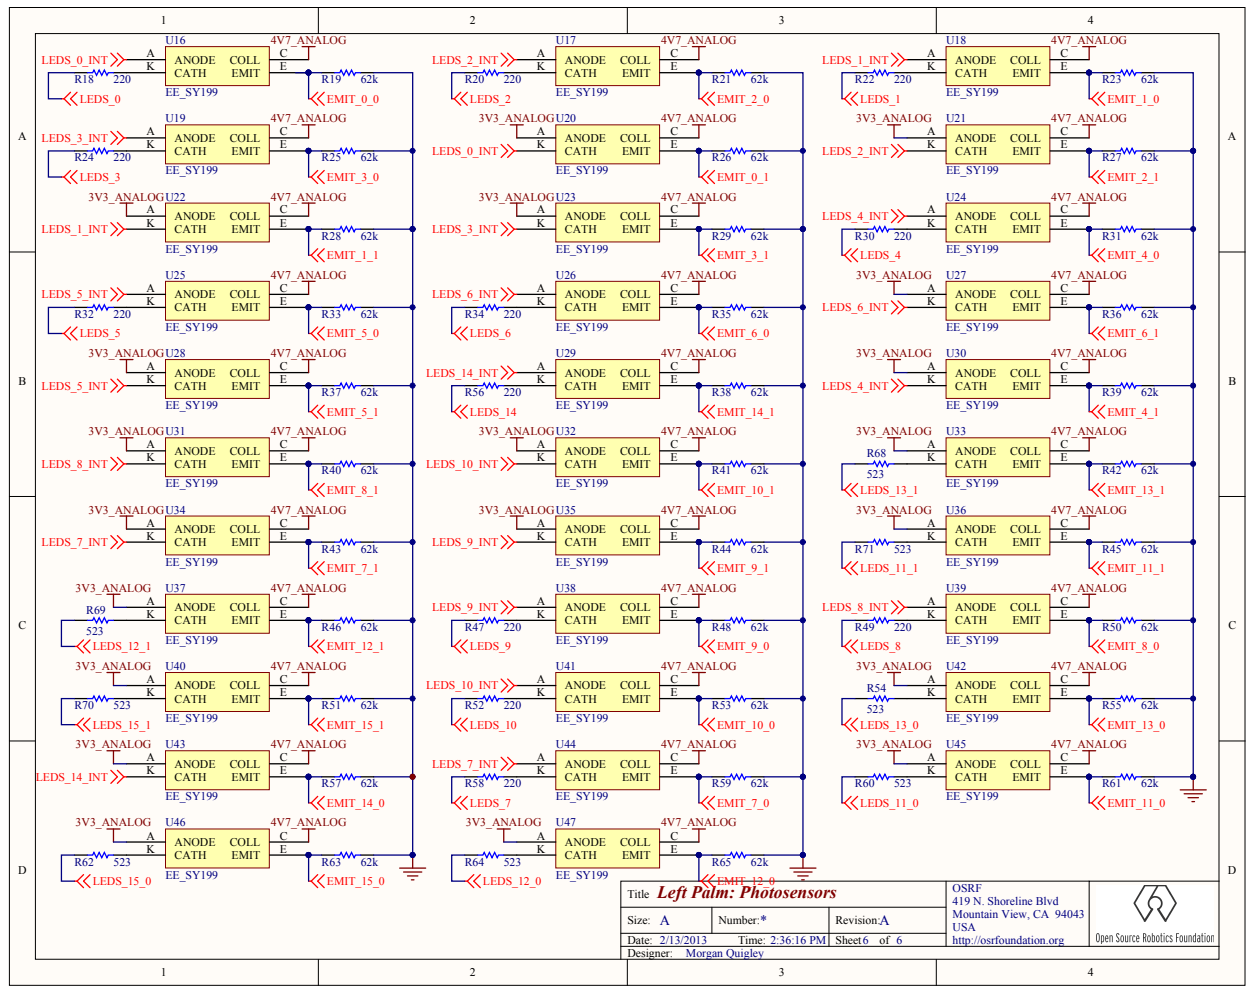
[picture p38: page 6]
