osrf/sandia-hand/docs/attachments/SandiaHand(2f)Overview(2f)Electrical/mobo.pdf

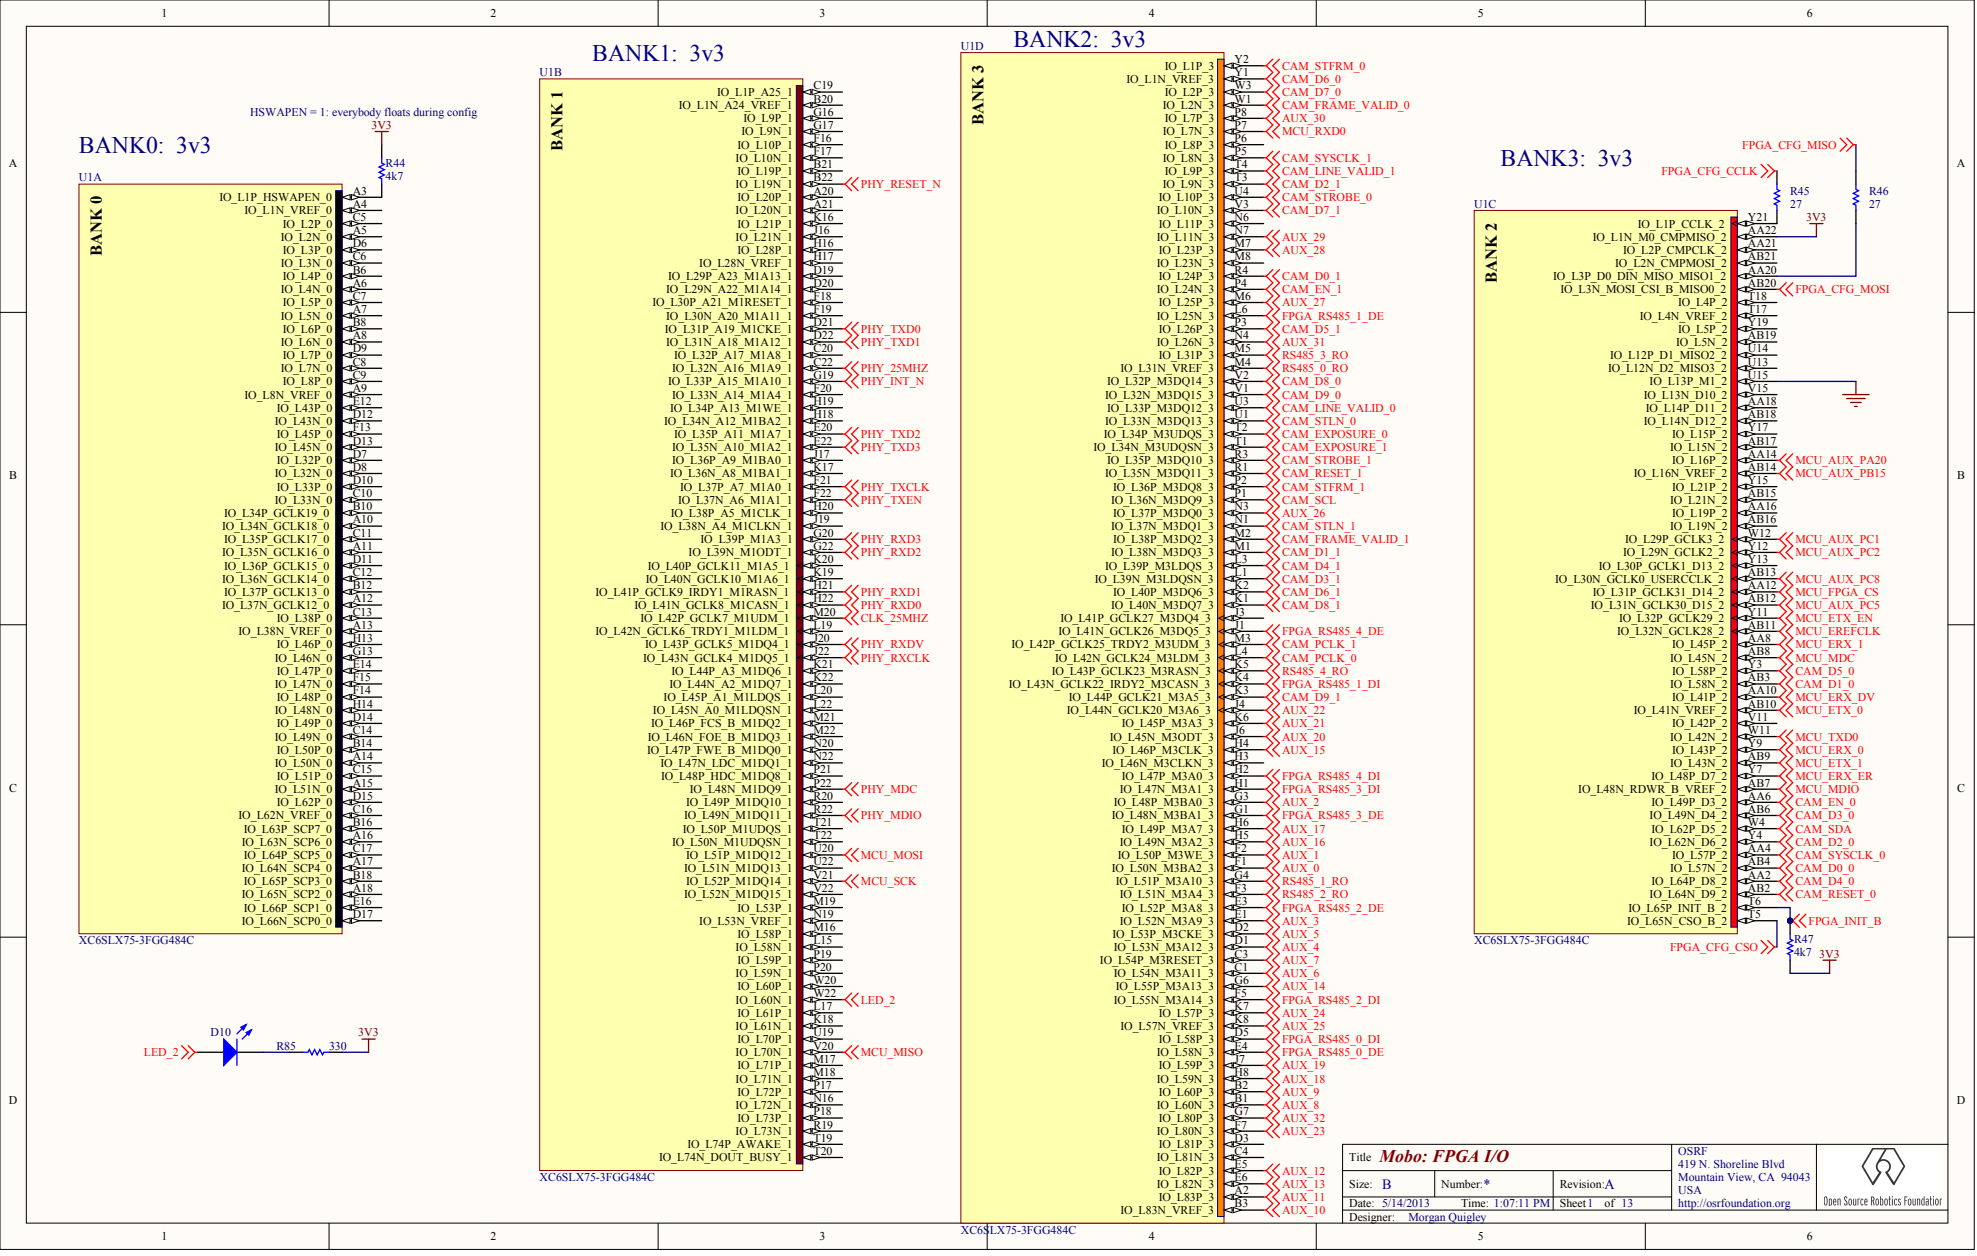
[picture p39: page 1]

HSWAPEN = 1: everybody floats during config

Mobo: FPGA I/O Title | OSRF 419 N. Shoreline Blvd Mountain View, CA 94043 USA http://osrfoundation.org

Size: B | Number: * | Revision: A
Date: 5/14/2013 Time: 1:07:11 PM | | Sheet of 13

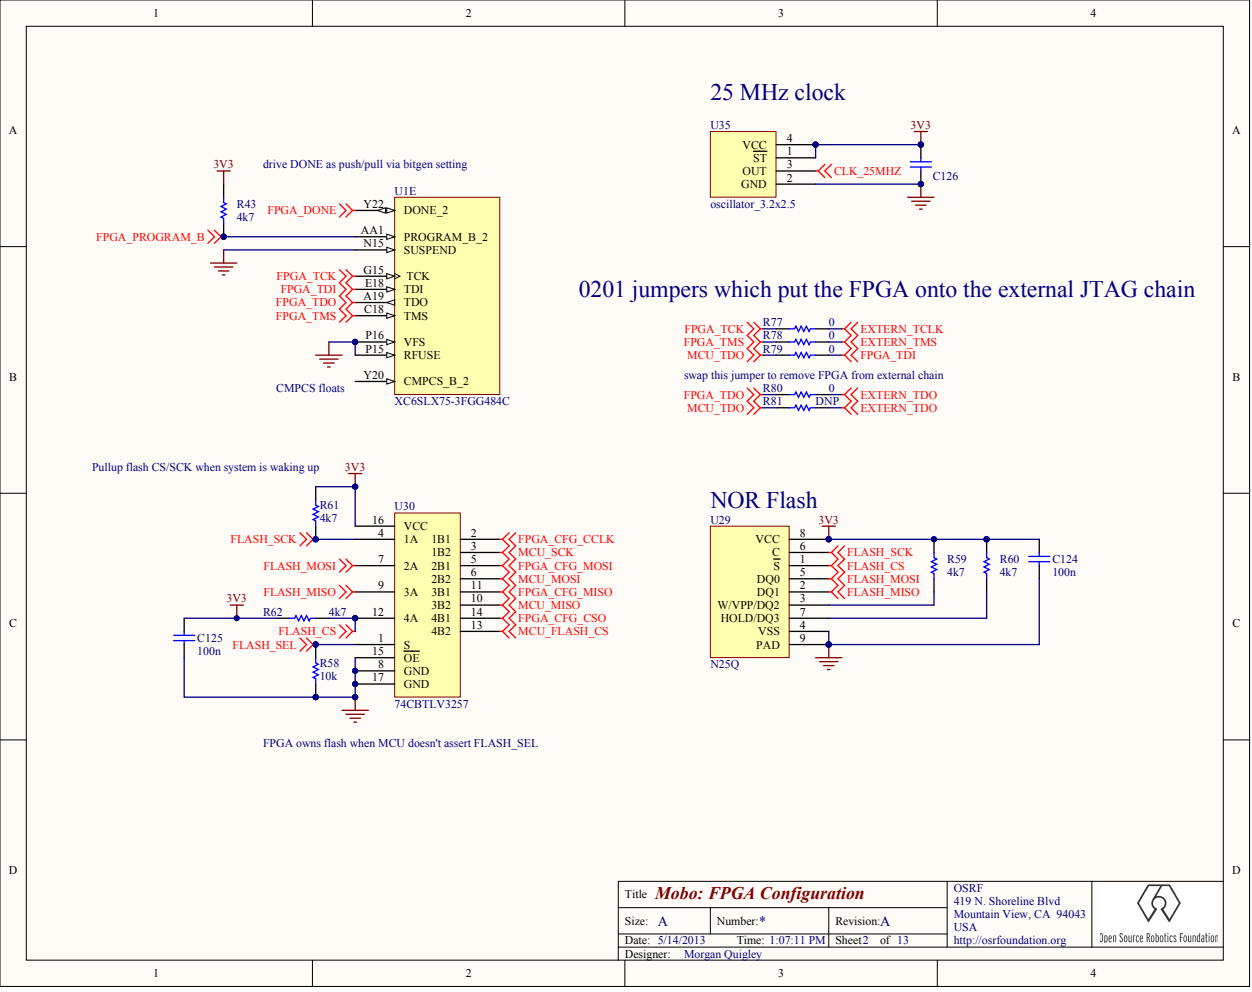
[picture p40: page 2]

drive DONE as push/pull via bitgen setting

0201 jumpers which put the FPGA onto the external JTAG chain

swap this jumper to remove FPGA from external chain

Pullup flash CS/SCK when system is waking up

FPGA owns flash when MCU doesn't assert FLASH_SEL

Mobo: FPGA Configuration Title | OSRF 419 N. Shoreline Blvd

5/14/2013 1:07:11 PM

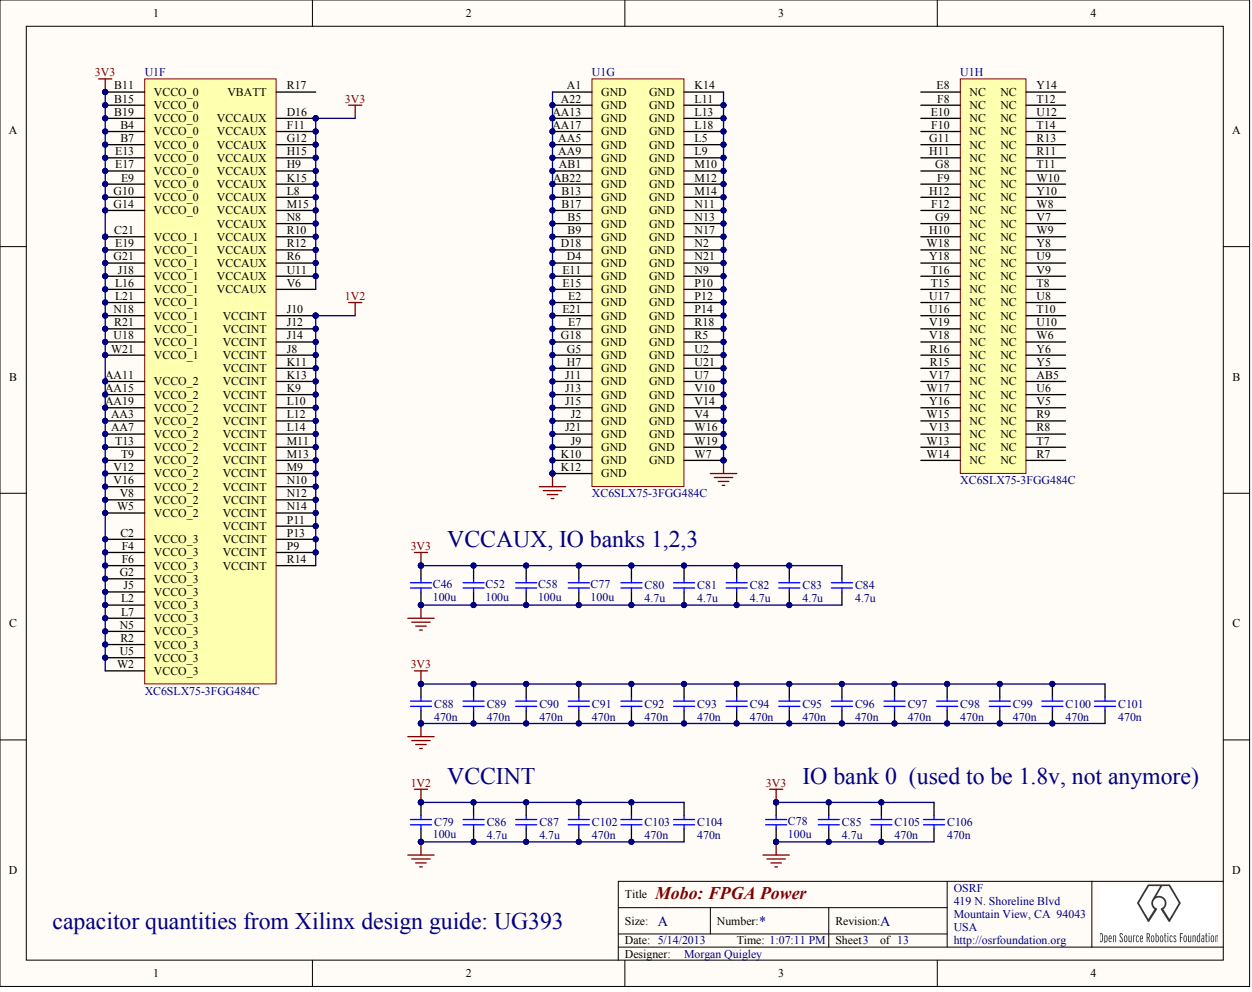
[picture p41: page 3]

Mobo: FPGA Power Title | OSRF 419 N. Shoreline Blvd

capacitor quantities from Xilinx design guide: UG393

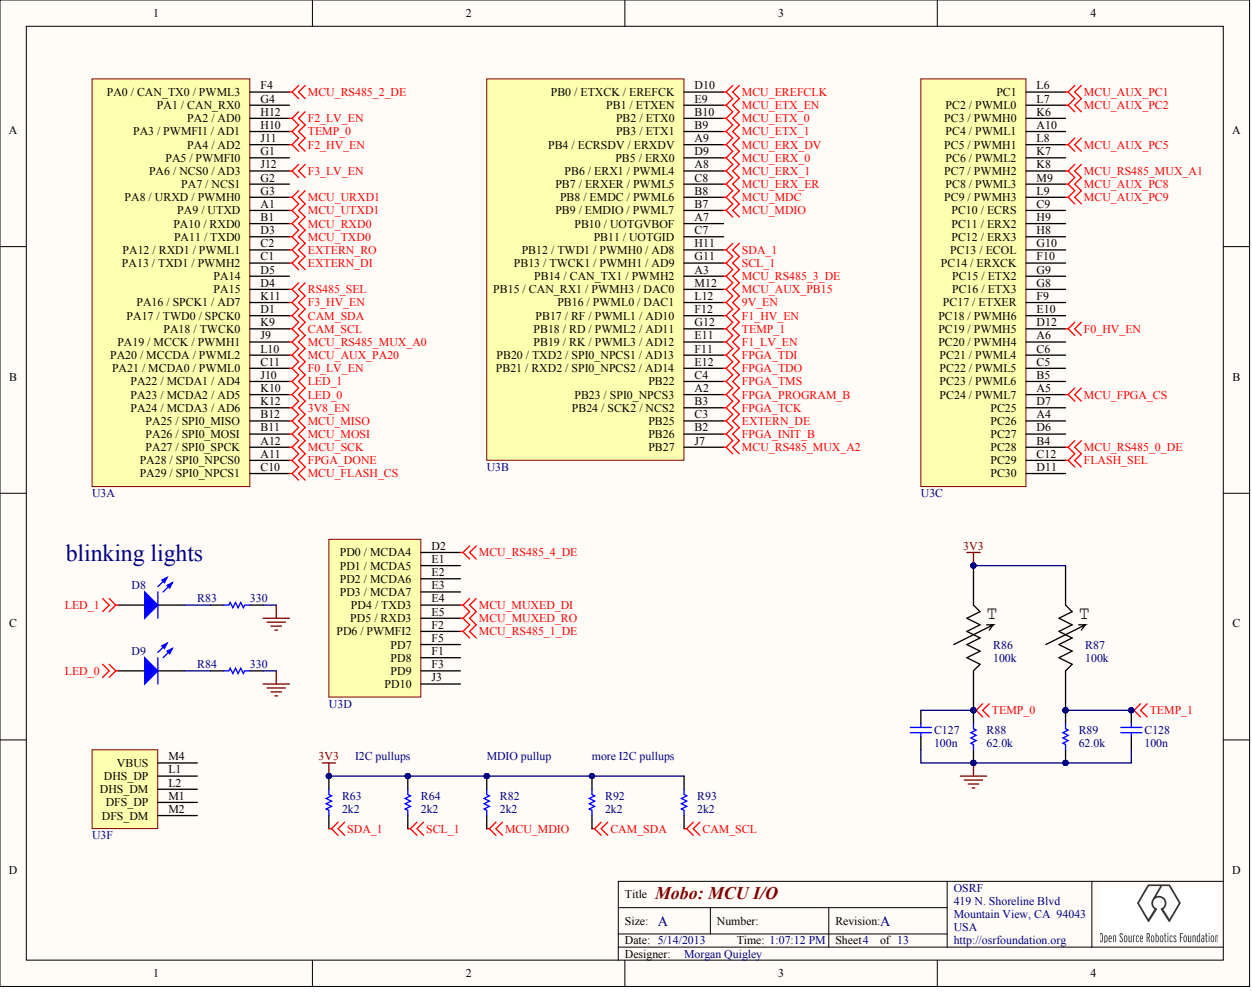
[picture p42: page 4]

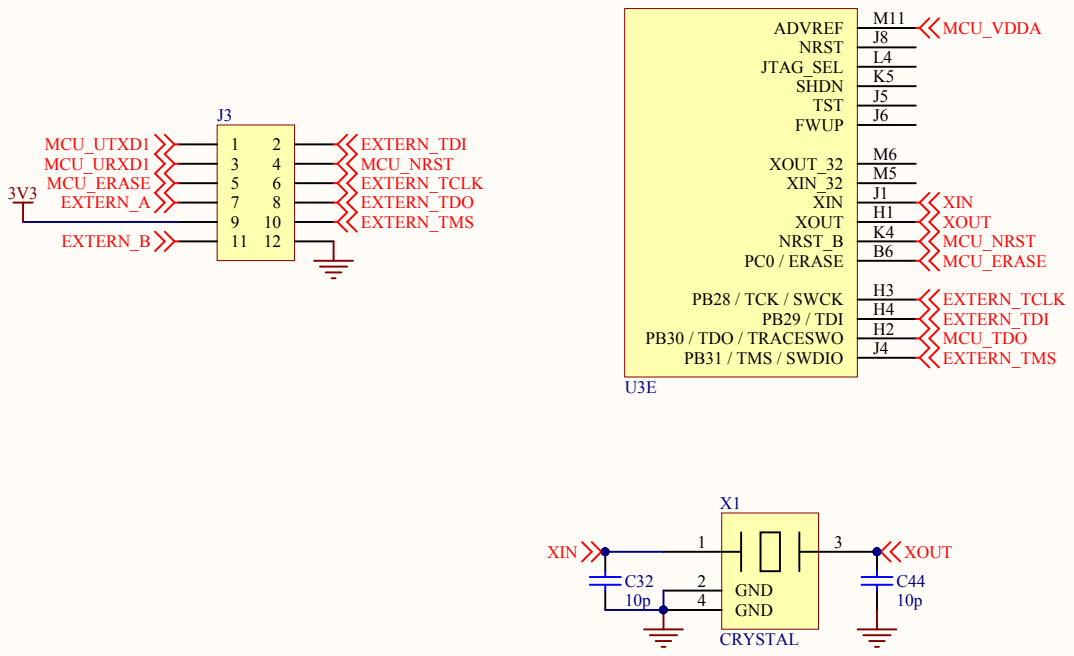
[picture p43: page 5]

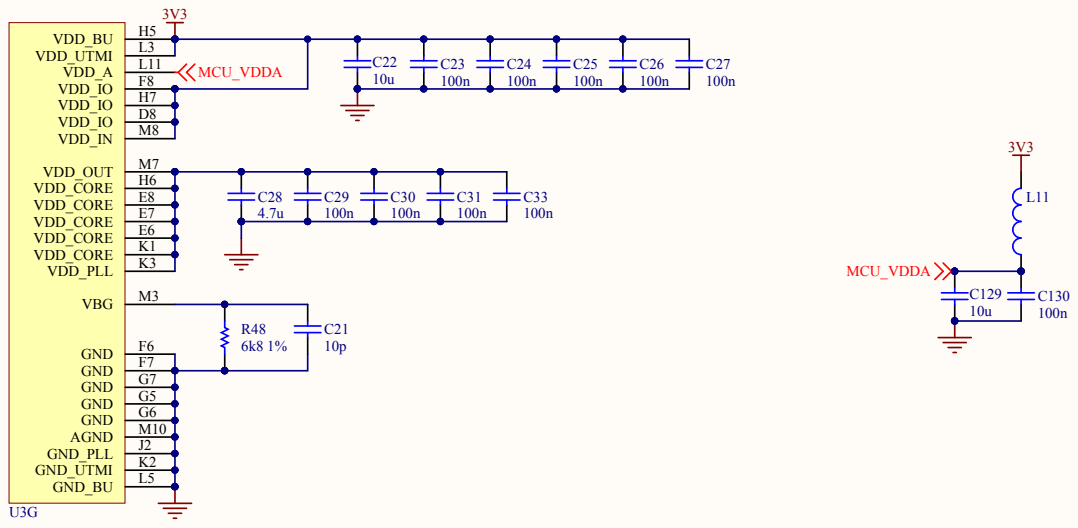
[picture p44: page 6]

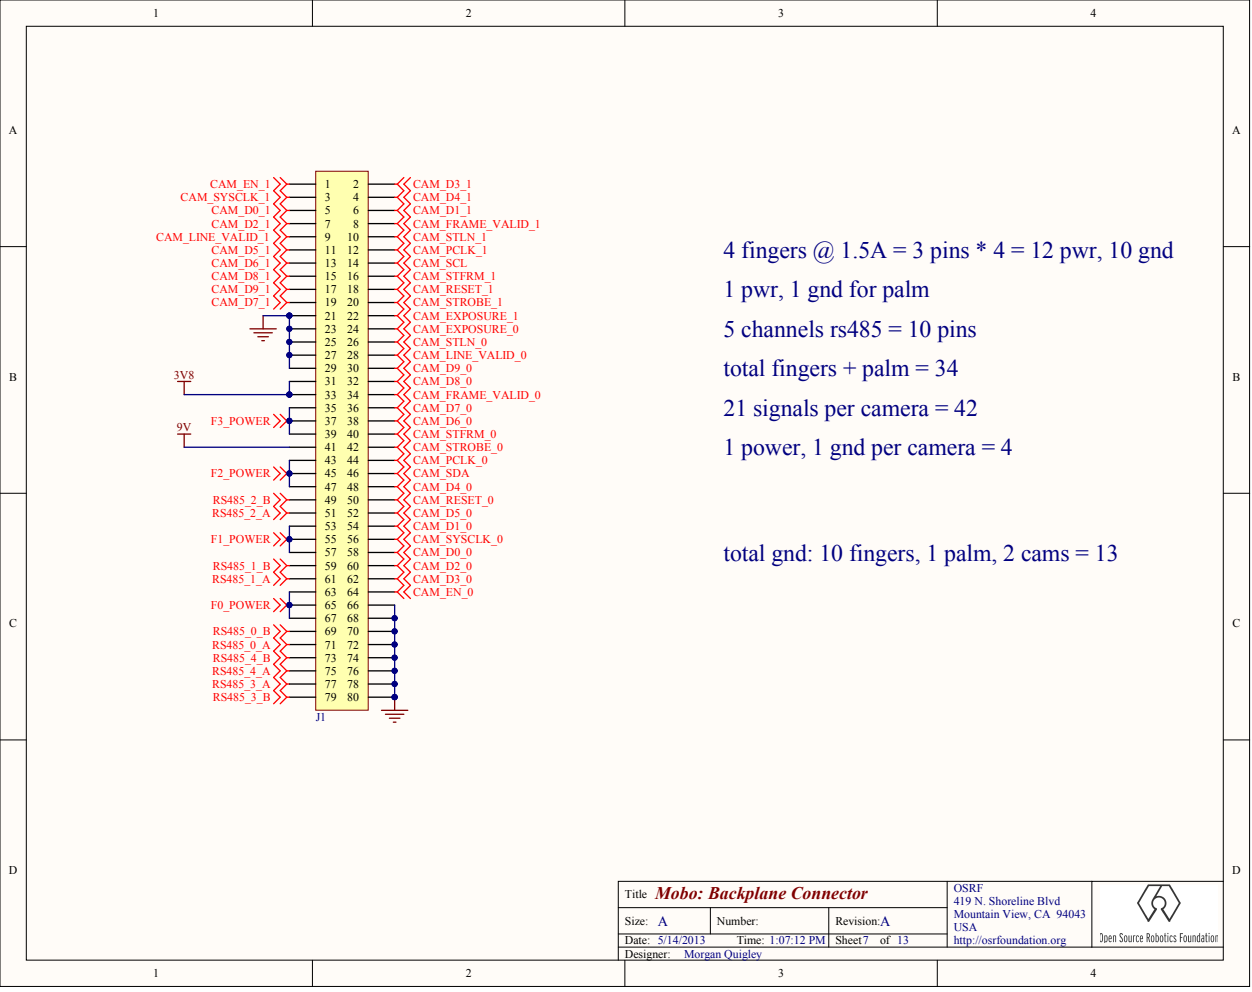
[picture p45: page 7]

4 fingers @ 1.5A = 3 pins * 4 = 12 pwr, 10 gnd
1 pwr, 1 gnd for palm
5 channels rs485 = 10 pins
total fingers + palm = 34
21 signals per camera = 42
1 power, 1 gnd per camera = 4

total gnd: 10 fingers, 1 palm, 2 cams = 13

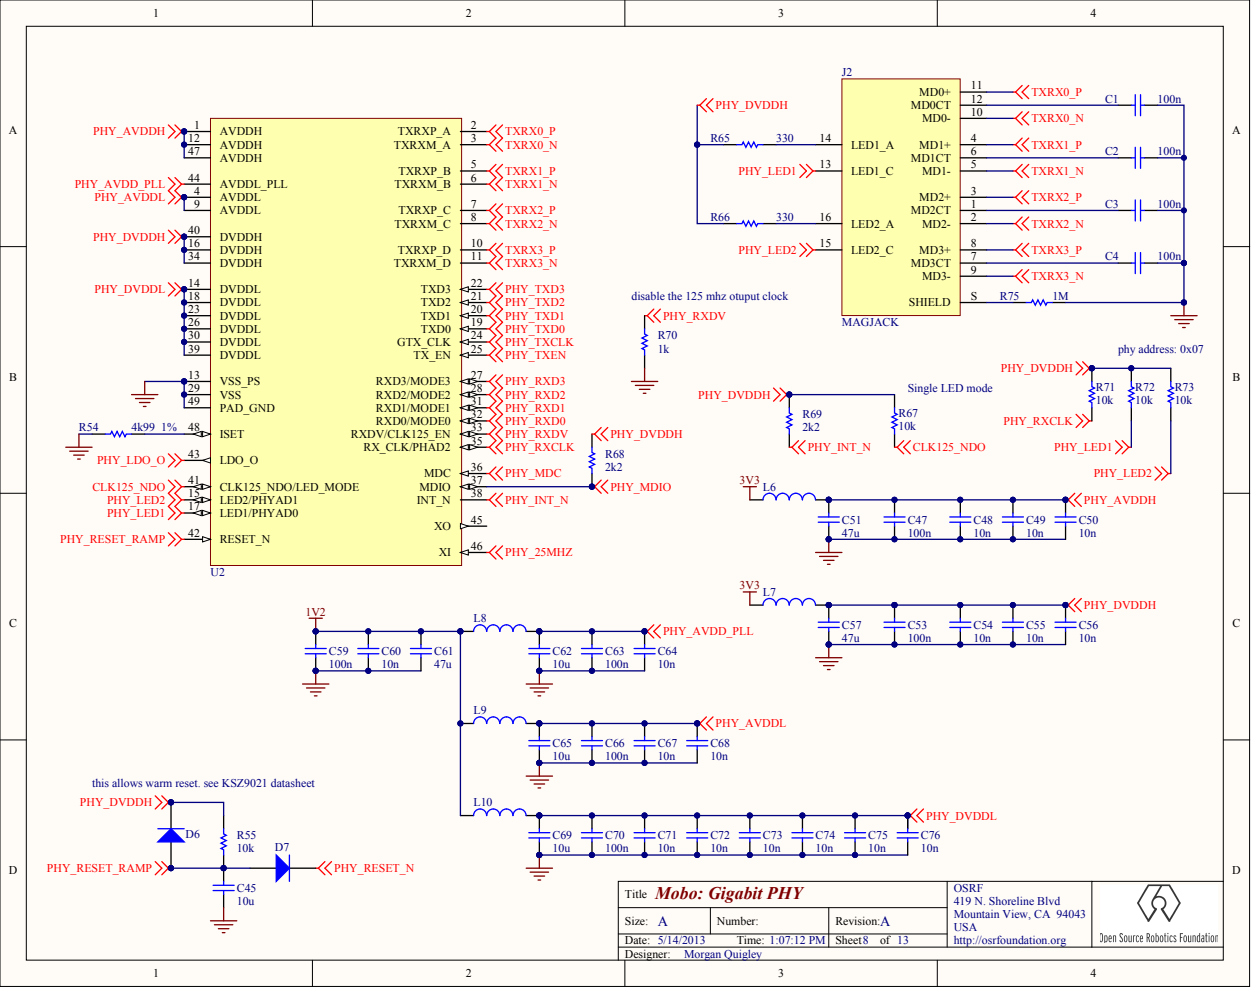
[picture p46: page 8]

this allows warm reset. see KSZ9021 datasheet
PHY_DVDDH

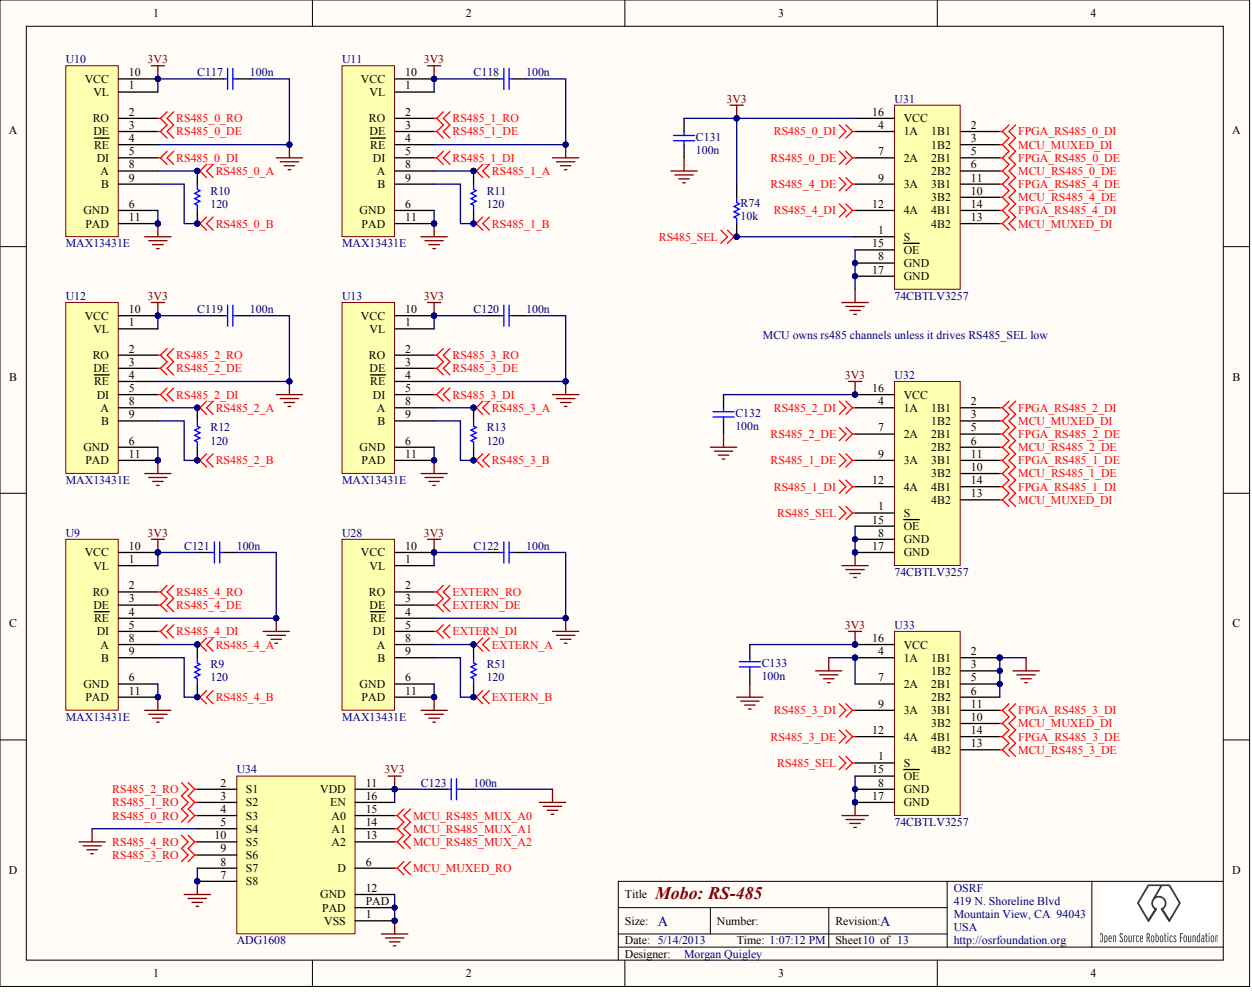
[picture p47: page 9]

MCU owns rs485 channels unless it drives RS485_SEL low

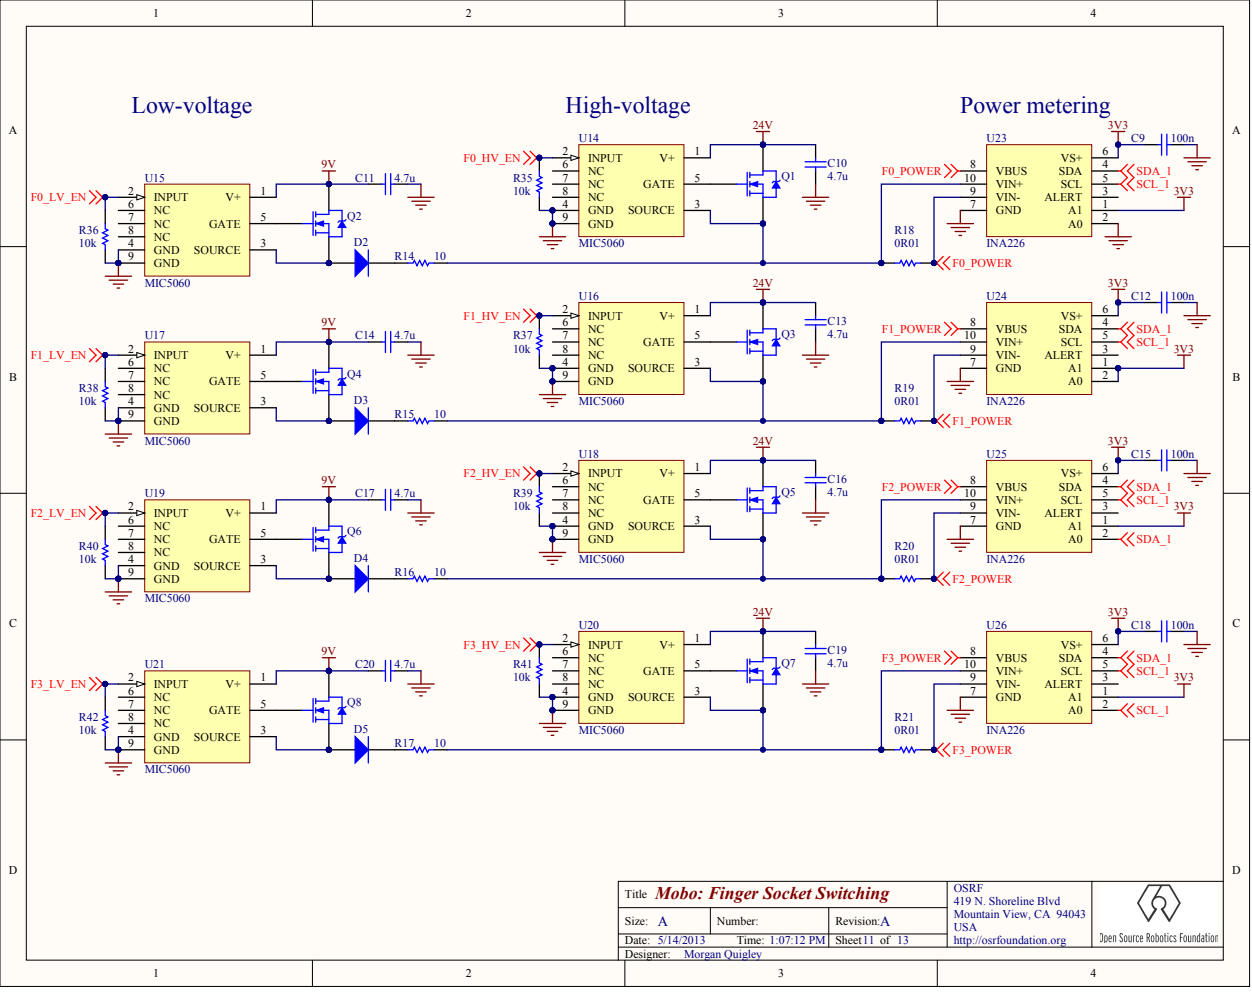
[picture p48: page 10]

Mobo: Finger Socket Switching
Title

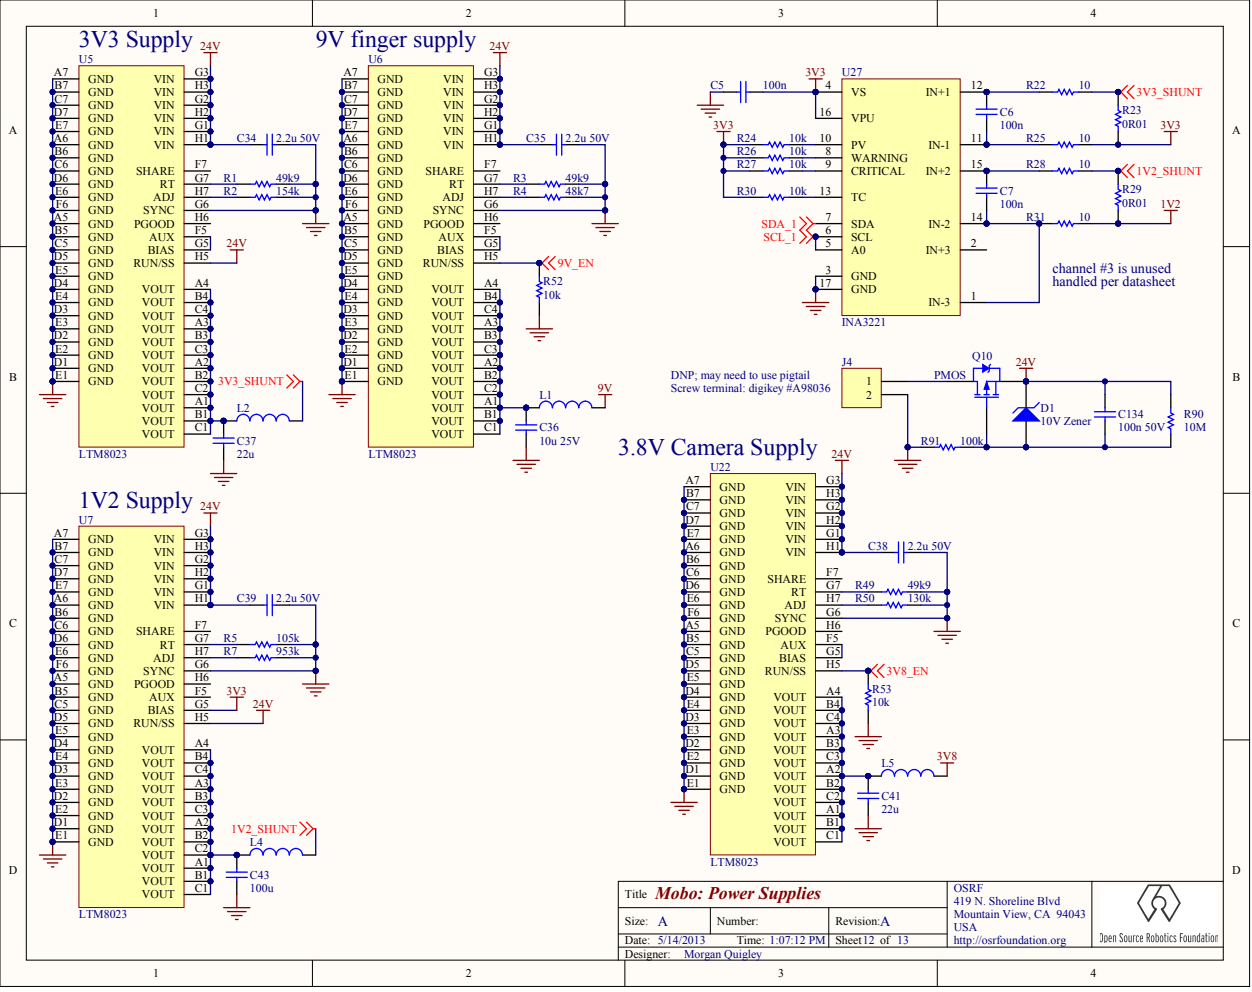
[picture p49: page 11]

DNP; may need to use pigtail
Screw terminal: digikey #A98036

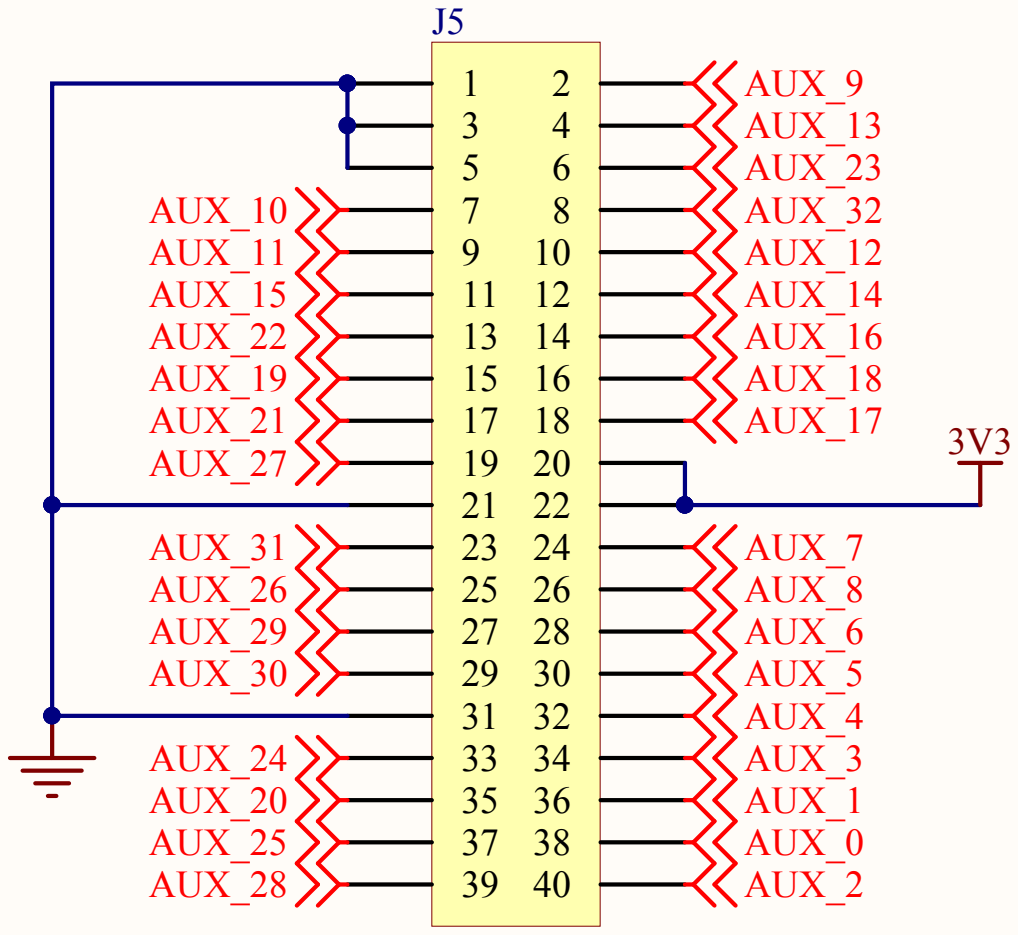
[picture p50: page 12]

Mobo: Auxilliary FPGA Connector
Title
