osrf/sandia-hand/docs/attachments/SandiaHand(2f)Overview(2f)Electrical/right_conn.pdf

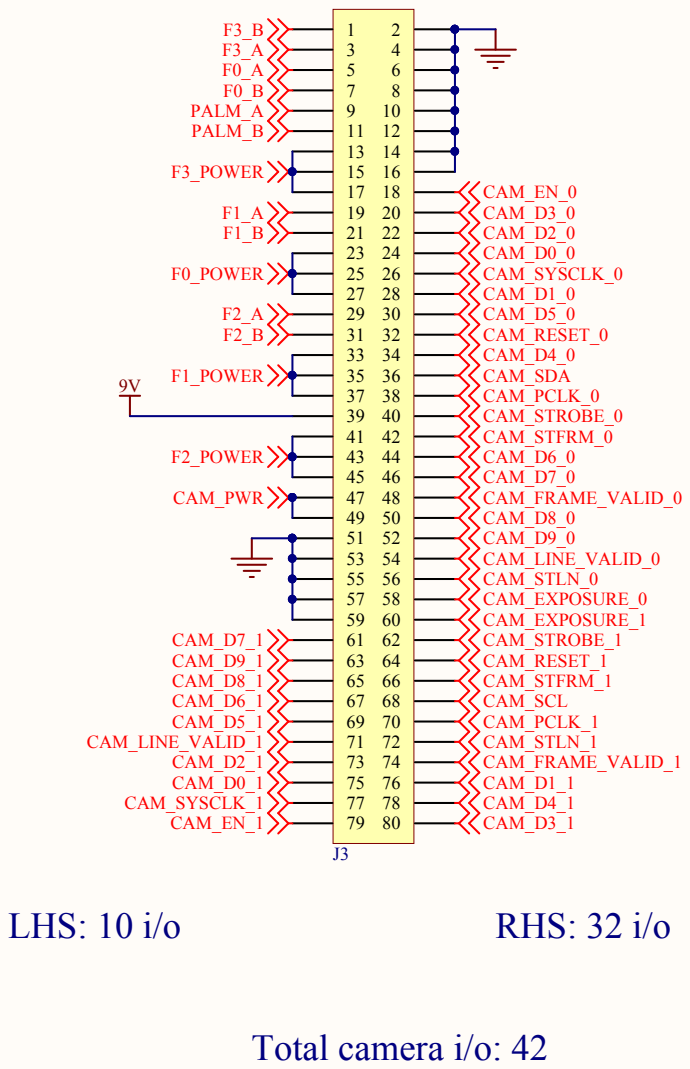
[picture p51: page 1]

Conn Title | OSRF 419 N. Shoreline Blvd Mountain View, CA 94043 USA http://osrfoundation.org

Size: A | Number: | Revision:
Date: 2/25/2013 Time: 4:44:53 PM | | Sheet of 4



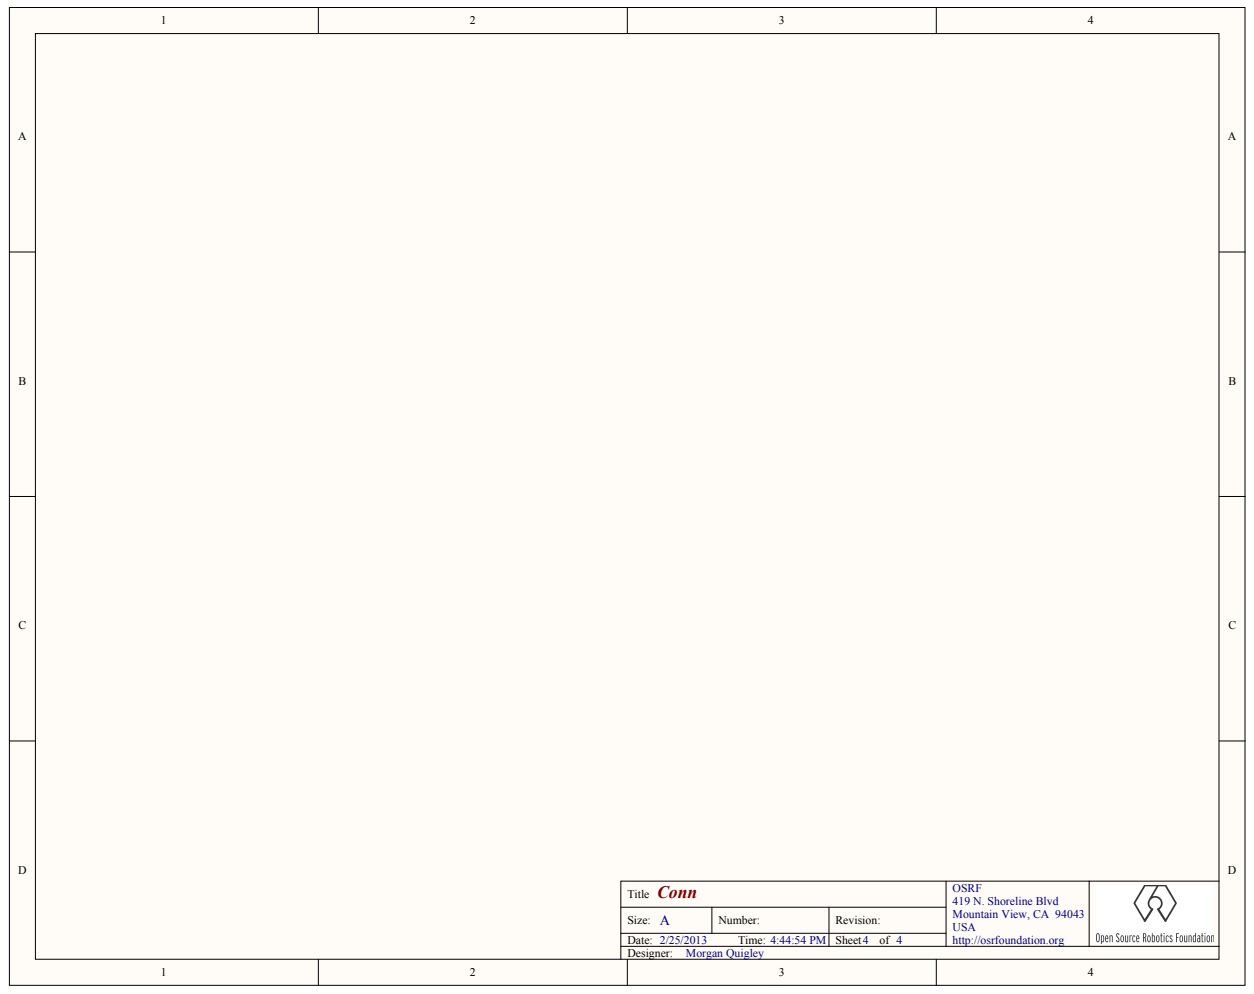
[picture p52: page 4]

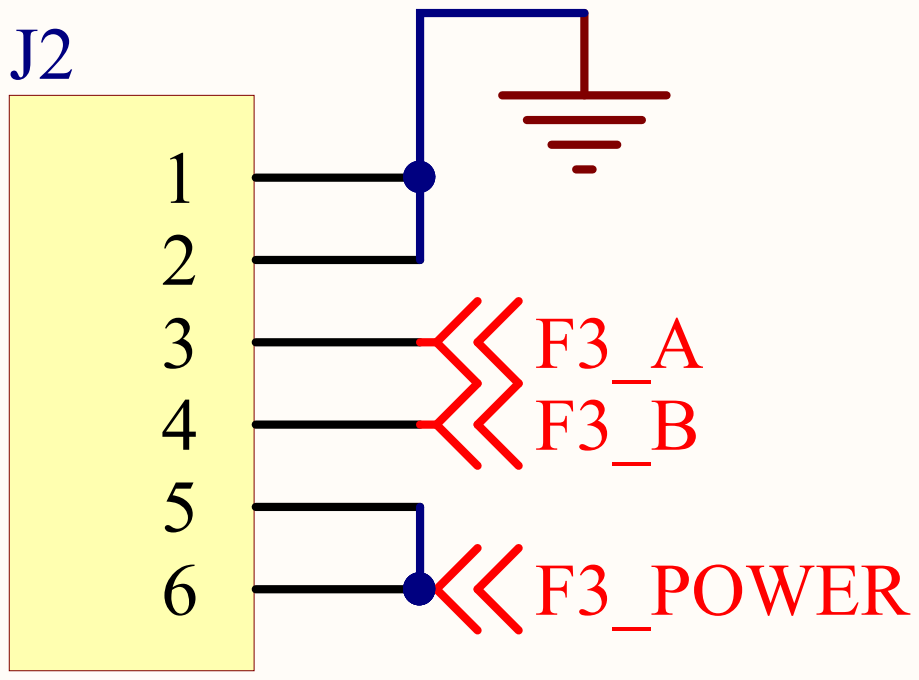
[picture p53: page 5]
