osrf/sandia-hand/docs/attachments/SandiaHand(2f)Overview(2f)Electrical/rpalm.pdf

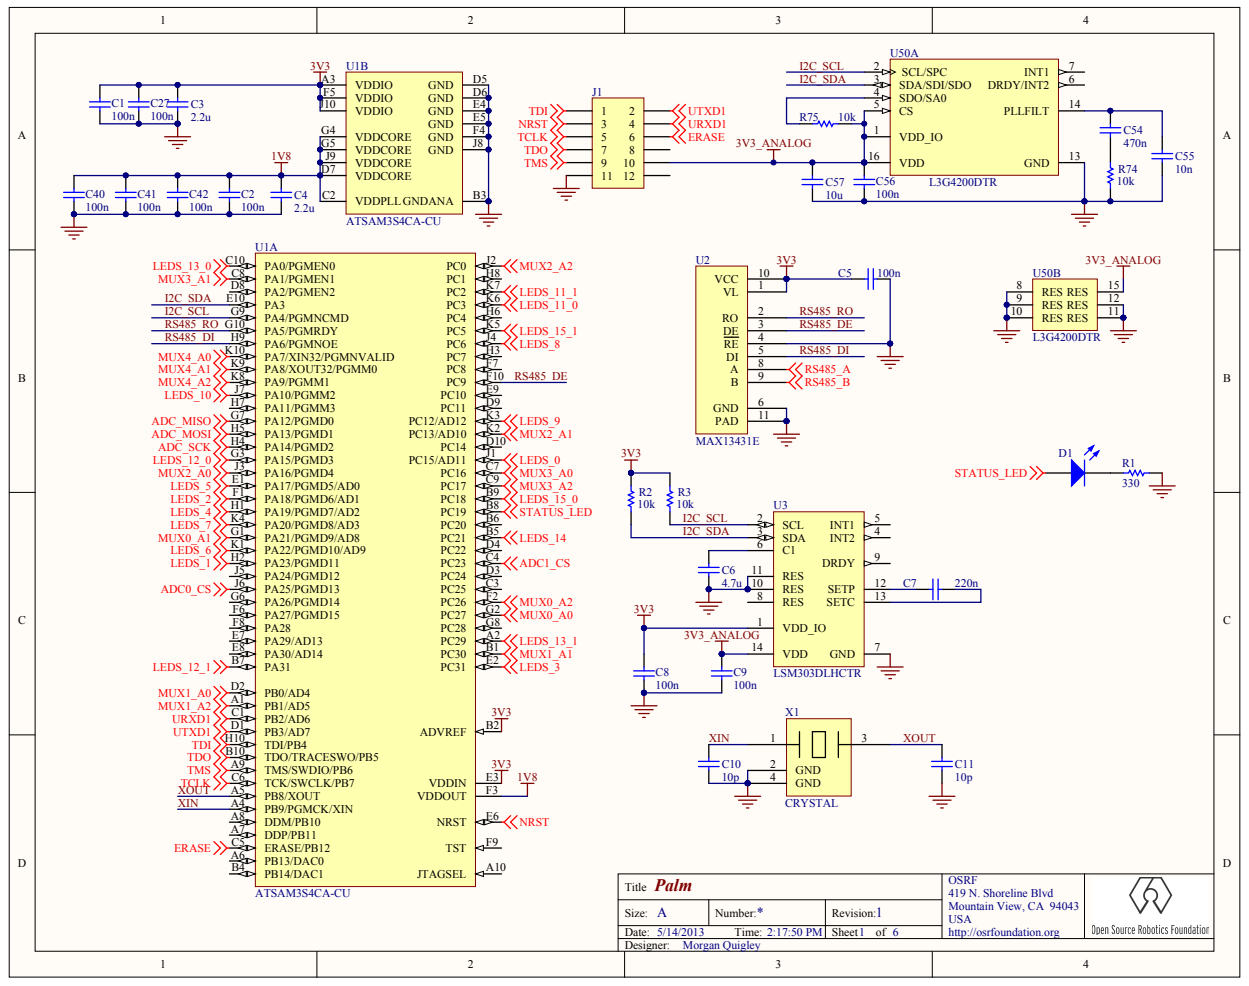
[picture p54: page 1]

Palm Title | OSRF 419 N. Shoreline Blvd Mountain View, CA 94043 USA http://osrfoundation.org

Size: A | Number: | Revision:
Date: 5/14/2013 Time: 2:17:50 PM | | Sheet of 6

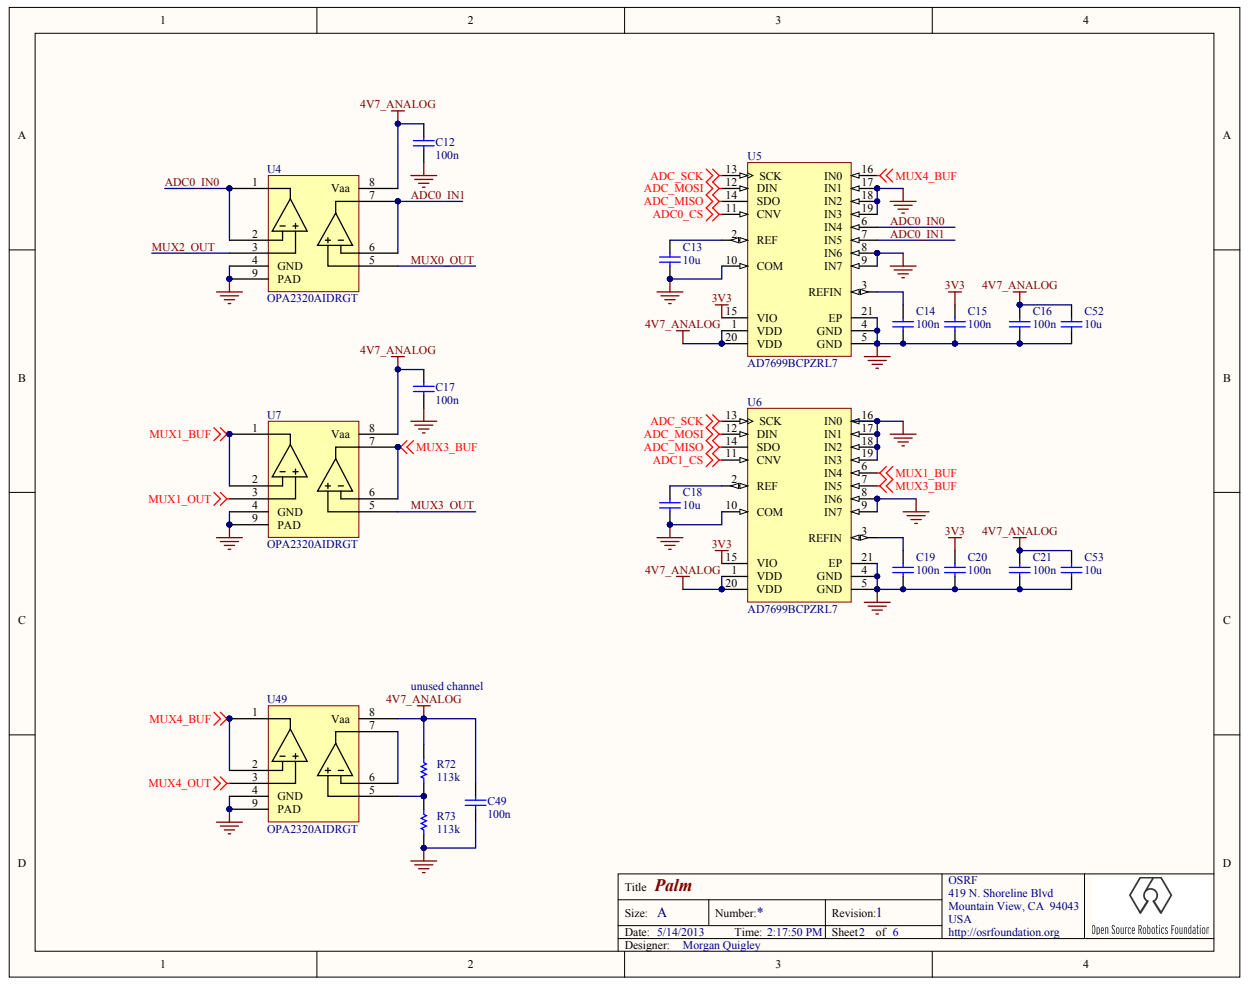
[picture p55: page 2]

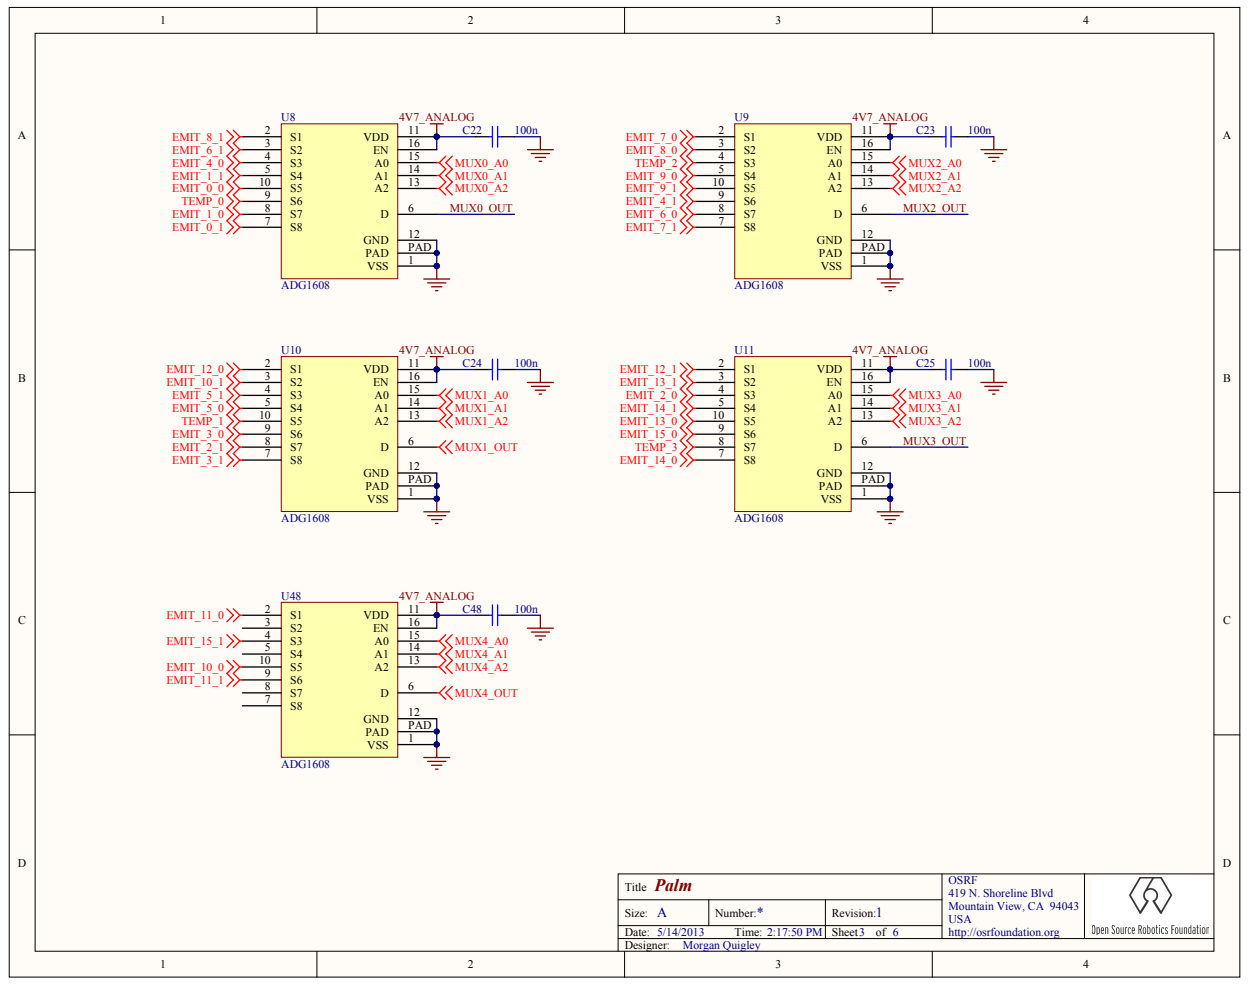
[picture p56: page 3]

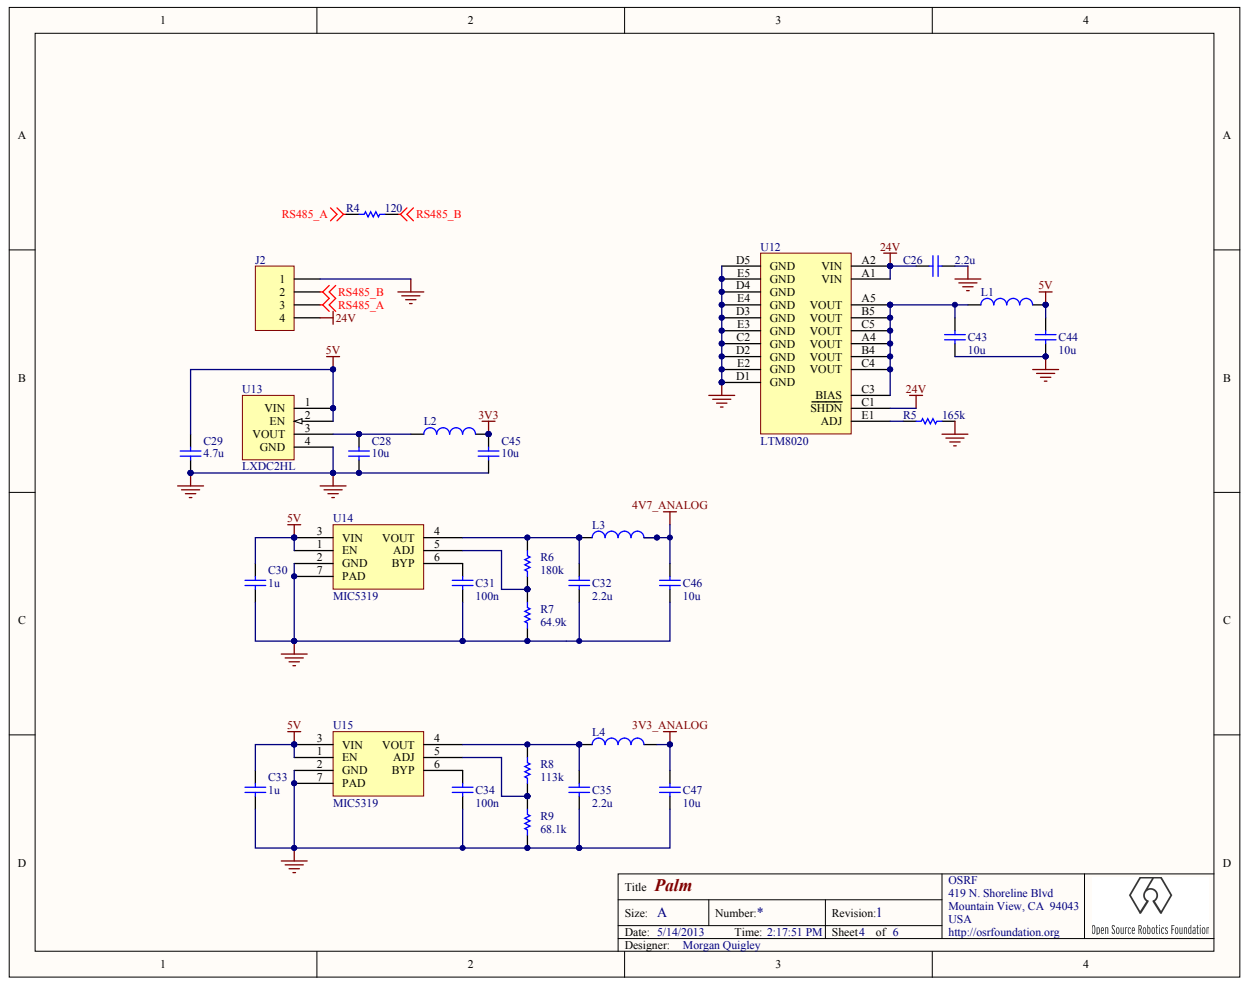
[picture p57: page 4]

PAD 7

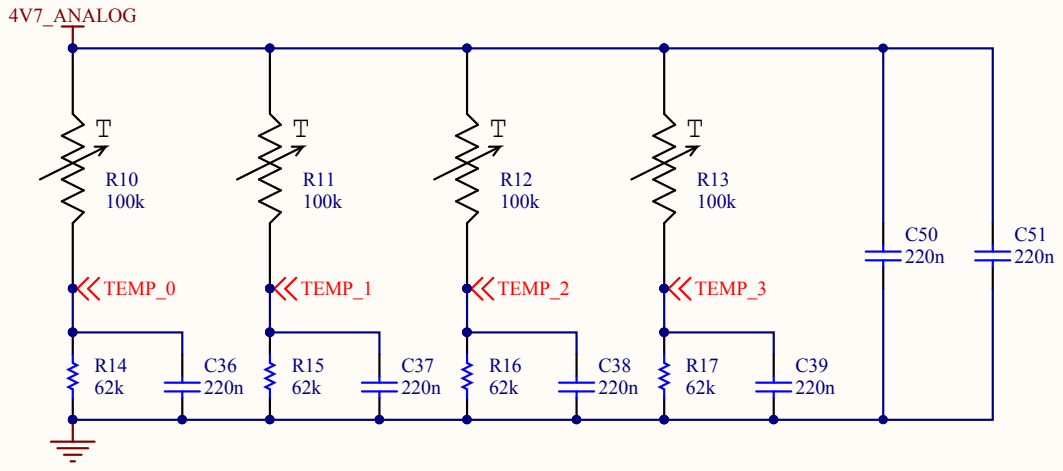
[picture p58: page 5]

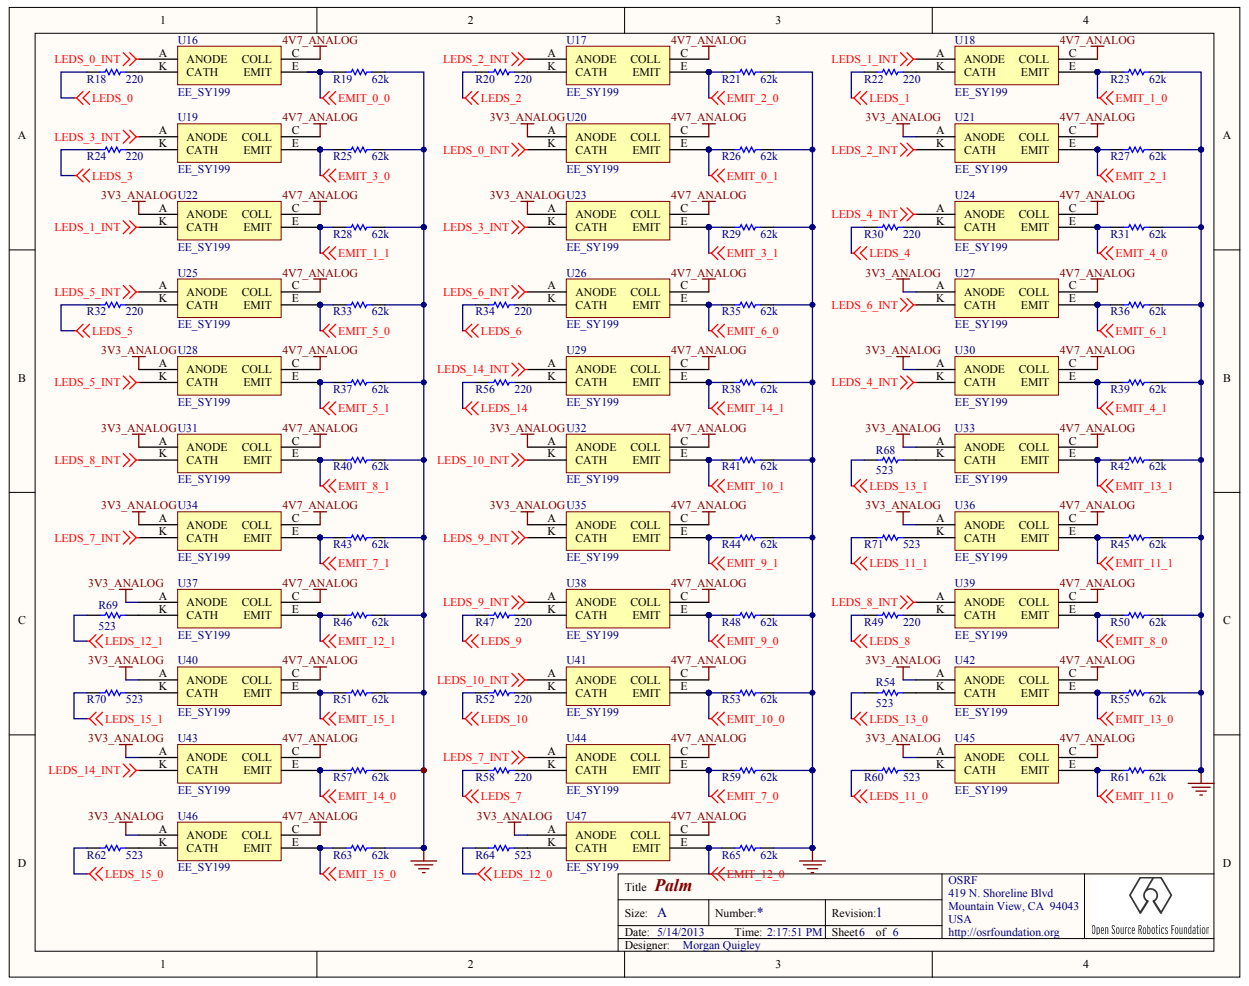
[picture p59: page 6]
