osrf/sandia-hand/(list of files, drawings)

Other design files:
docs/attachments/SandiaHand(2f)Overview(2f)Electrical/f2.PcbDoc
docs/attachments/SandiaHand(2f)Overview(2f)Electrical/f3.PcbDoc
docs/attachments/SandiaHand(2f)Overview(2f)Electrical/finger_pogo.PcbDoc
docs/attachments/SandiaHand(2f)Overview(2f)Electrical/left_conn.PcbDoc
docs/attachments/SandiaHand(2f)Overview(2f)Electrical/right_conn.PcbDoc
