osrf/sandia-hand/(commit log)

2012-12-12 update package name references in urdf
    [sandia_hand.urdf.xacro]
2012-12-15 First pass at simple collision shapes for sandia hand
    [sandia_hand.urdf.xacro]
2012-12-15 Converted pose to origin for urdf
    [sandia_hand.urdf.xacro]
2012-12-15 Fix shape syntax in urdf
    [sandia_hand.urdf.xacro]
2012-12-18 Isolate simple collision shape changes to separate file
    [sandia_hand_simple_shapes.urdf.xacro]
2012-12-18 Put cylinder elements on a single line
    [sandia_hand_simple_shapes.urdf.xacro]
2012-12-19 add minimalist eigengrasp controller and slightly tweaked WG nanokontrol driver
2012-12-20 Use simple shapes by default, reflect for left and right hands
    [sandia_hand_both.urdf.xacro, sandia_hand_left.urdf.xacro, sandia_hand_right.urdf.xacro, sandia_hand_simple_shapes.urdf.xacro]
2012-12-20 haxx trying to get gazebo urdf generation from xacro so we don't have to include both xacro and raw urdf in repo
2012-12-20 chain ros package build into main cmake build. set up install targets.
2012-12-20 Bracket error in xacro
    [sandia_hand_simple_shapes.urdf.xacro]
2012-12-20 simple bash script to auto-generate the gazebo robots. renamed the robots so they are more descriptive, since they are just hands on boxes.
    [sandia_hand_both_on_box.urdf.xacro, sandia_hand_left_on_box.urdf.xacro, sandia_hand_right_on_box.urdf.xacro]
2012-12-22 add a few printouts so we can figure out why the install location is going awry during debian package generation
2012-12-22 a new strategy for chaining rosbuild projects inside a parent cmake build
2012-12-24 ready to try this first crack at bootloader on HW
    [jtagkey.cfg, mobo_openocd.cfg]
2012-12-24 fix vector table in bootloader assembly. set bootloader entry point to be using thumb. now it blinks the bootloader LED sequence.
2012-12-27 mild restructuring of openocd configs in an attempt to allow openocd to program both mcu and fpga on mobo
    [jtagkey.cfg]
2012-12-28 spi txrx between ARM and mcu appears to work, at least a 4 mhz
    [jtagkey.cfg]
2012-12-29 firmware to switch finger socket power gates on and off
2013-01-03 mega commit. ARM ethernet RX works coming through the fpga.
2013-01-03 bug fix, ethernet DMA descriptor was pointing to itself instead of the actual tx buffer
2013-01-04 put PHY hardware and software reset back in the ARM MCU init sequence
    [mobo_mcu.c]
2013-01-05 bringing up device driver library skeleton, talking to newfound ethernet udp stack on mobo
2013-01-05 tie UDP stack into finger power switches. fix C syntax in power.c
2013-01-06 bringing up finger comms on mobo.
2013-01-06 for now, broadcast to all fingers. clean up rs485 precharge timing.
2013-01-07 add finger joint pos command to packet definitions, libsandia-hand, cli, and firmware
2013-01-08 finger socket powering and basic motion commands work now
2013-01-09 camera register read works.
2013-01-19 create functor for image RX in hand driver library. use it with cli to save pgm image
2013-01-22 Add group names to collisions in sandia_hand_simple_shapes to prevent a million warnings when loading gazebo
    [sandia_hand_simple_shapes.urdf.xacro]
2013-01-23 a simple eigengrasp based controller just for demonstration/strawman purposes.
    [sandia_hand_simple_shapes.urdf.xacro]
2013-01-23 clean up sandia_hand_driver filenames and chain them into the build. clean up cmake ros package build chaining stuff a bit. hopefully sandia_hand_driver will install into reasonable places now.
2013-01-23 start of hacking on camera streaming via ROS. too tired to finish it tonight.
2013-01-24 both cameras stream through ros, hooray
2013-01-25 getting closer to a complete finger comms rx path back through fpga UDP...
2013-01-25 finger comms skeleton
2013-01-25 working towards finger comms via udp
2013-01-25 Check the dependencies of the current ROS package before trying to build and give the user a warning if there are dependency problems.
2013-01-26 finger comms haxx
2013-01-29 rx comms hackery, currently broken
2013-02-19 move grasp control to axes unused by direct joint control; change default scene for enabling grasp
2013-02-21 looking at inertia updates.
    [sandia_hand_simple_shapes.urdf.xacro]
2013-02-21 first cut at realistic inertia
    [sandia_hand_simple_shapes.urdf.xacro]
2013-02-22 increase finger inertia until we can teleop to grab the drill.
    [sandia_hand.gazebo.xacro, sandia_hand_simple_shapes.urdf.xacro]
2013-02-23 add beginnings of firmware to poll the finger socket and logic rail current sensing ICs
2013-02-23 hacking on current sensing
2013-02-23 consolidate firmware changes. move stuff from current.c to power.c and get rid of current.h and .c
2013-02-24 moving towards auto-blasting the finger-socket current measurements to the host.
2013-02-25 moving towards udp status packet blasting. logic rail current/voltage monitor appears to be working. next step is to just populate the status-packet data structure and blast it out; timing/scheduling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
2013-02-26 firmware to stream the motherboard's current sensors. data appears to now be making it all the way into the driver library. need to expose a hook to CLI and ROS drivers now.
2013-02-26 selectable frequency updates for mobo status stream and finger polling (almost there...)
2013-02-27 chasing down heisenbug that happens when UDP packet arrives in the middle of an i2c transfer. need to put an interrupt on the i2c logic so it doesn't underflow.
2013-02-27 move mobo i2c to interrupt driven to avoid scheduling conflicts with ethernet
2013-02-28 gradually moving towards bidirectional finger comms via udp
2013-03-01 more comms hacking. data is starting to flow.
2013-03-01 tune damping and gains
    [sandia_hand_simple_shapes.urdf.xacro]
2013-03-01 testing soft surface contact
    [sandia_hand.gazebo.xacro]
2013-03-01 add urdf cfmDamping option. load xacro macros for gazebo elements for hand.
    [sandia_hand.gazebo.xacro, sandia_hand.urdf.xacro, sandia_hand_simple_shapes.urdf.xacro]
2013-03-01 for simple shapes model, add urdf cfmDamping option. load xacro macros for gazebo elements for hand.
    [sandia_hand.urdf.xacro, sandia_hand_simple_shapes.urdf.xacro]
2013-03-02 motor module pings work. moving now towards phalange sensor streams, which will require various mods to finger motor module firmware.
2013-03-02 create a loose_finger testbench for more easily hacking on finger firmware
2013-03-03 working on inter-finger communications scheduling
2013-03-04 update per pull request comment
    [sandia_hand.gazebo.xacro]
2013-03-05 finger streaming
2013-03-06 lots of driver library work. tunneling out to the phalanges is coming along. bootloading the proximal phalange is working.
2013-03-07 sam3s bootloader fixes. now the cmake madness actually generates thumb code instead of ARM code, on the assembly sources. add some target-generation logic to create programming and gdb targets for ea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
    [jtagkey.cfg, sam3s.cfg]
2013-03-08 bootloading fmcb through the handframe appears to work fine now. bringing over the standard finger firmware from prior repo now. lots of cleanup to do there.
2013-03-12 skeleton of power supply firmware
2013-03-13 add lowvolt switching packet and firmware, which gets used by the palm bootloader hard reset cycle
    [main.c]
2013-03-13 Start adding cameras to hands, currently only works for left hand
    [sandia_hand.gazebo.xacro, sandia_hand_simple_shapes.urdf.xacro]
2013-03-15 bootloader init scripts need to run finger sockets at full power. then working towards bootloading the main palm MCU and FPGA.
2013-03-15 blinking led works on psu
2013-03-18 write an attempt at a INA226 interface for avr. not tested yet, which means it doesn't work yet.
    [main.c]
2013-03-18 add reflect tag to cameras xacro
    [sandia_hand.gazebo.xacro, sandia_hand_simple_shapes.urdf.xacro]
2013-03-18 Split stereo_offset between left and right cameras
    [sandia_hand.gazebo.xacro]
2013-03-18 Reflect stereo camera location and angle
    [sandia_hand.gazebo.xacro]
2013-03-18 Fix camera naming conflicts and reflections
    [sandia_hand.gazebo.xacro]
2013-03-18 switch to using the olimex jtag widgets to save money
    [olimex-arm-usb-tiny-h.cfg]
2013-03-18 Change baseline parameter in plugin
    [sandia_hand.gazebo.xacro]
2013-03-18 a few more tweaks to sandia hand cameras, but point clouds not yet working
    [sandia_hand.gazebo.xacro]
2013-03-18 working towards motherboard fpga remote flash loading
    [olimex-arm-usb-tiny-h.cfg]
2013-03-19 programming the fpga boot flash. might be working. needs further investigation.
    [olimex-arm-usb-tiny-h.cfg]
2013-03-19 For ros topic, sandia_hands/* instead of sandia_hand/*
    [sandia_hand.gazebo.xacro]
2013-03-19 finger stand gui works now for fmcb programming
2013-03-20 fpga recovery via golden image on mobo flash appears to be working. write garbage to the application image space, and after a 10-second timeout,the ARM notices it and recovers fpga application image 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
2013-03-21 reduce jtag frequency to work with longer programming cable setups. turn off LEDs after configuration is complete.
    [olimex-arm-usb-tiny-h.cfg]
2013-03-21 try to fix camera topics for drcsim, without changing drcsim
    [sandia_hand.gazebo.xacro, sandia_hand_both_on_box.urdf.xacro, sandia_hand_simple_shapes.urdf.xacro]
2013-03-21 reduce frame rate to 30 hz, so that stereo_image_proc can keep up with it, and maybe reduce temperature of the cameras a bit.
2013-03-22 stereo frames. need to convert this to a launch file.
2013-03-23 bootloader now jumps to application image after 5 seconds. now need to add reset function to application.
    [main.c]
2013-03-23 bootloader bug fixes for mobo
    [main.c]
2013-03-25 moving towards publishing all finger data in ros
2013-03-25 moving towards finger streaming in ros
2013-03-26 moving towards finger motion...
2013-03-26 moving towards moving fingers with streaming data
2013-03-27 finger 0 moves. neat.
2013-03-28 psu firmware. getting there. temperature control on fan seems fine. next up is some hysteresis and a lockout time on the dc output
2013-04-01 towards full hand control in a single ethernet frame
2013-04-02 four fingers move via ROS messages, hooray. streaming finger data back to ROS seems ok as well.
2013-04-03 software power control of overall hand current draw. does this by first clamping down pwm values to reduce draw, then doing bangbang as needed on motor enable lines.
2013-04-03 create a finger homing GUI so that the fingers can be forward-driven to their home positions. start to hook the GUI into the hand's ros node.
2013-04-04 moving towards manual finger homing GUI.
2013-04-04 homing gui appears to work
2013-04-05 palm streaming seems to work fine now at about 30 hz
2013-04-08 Xacro-parameterize more of the sandia hand properties
    [sandia_hand.gazebo.xacro]
2013-04-08 Add gaussian noise to sandia hand cameras
    [sandia_hand.gazebo.xacro]
2013-04-08 Fix build: xacro properties cannot be defined inside a xacro macro
    [sandia_hand.gazebo.xacro]
2013-04-08 Add a new xacro parameter to sandia_hand_description, so that the revolute joints in fingers can be optionally set as fixed to simplify the dynamic model, while still supporting hand cameras
    [sandia_hand_both_on_box.urdf.xacro, sandia_hand_left_on_box.urdf.xacro, sandia_hand_simple_shapes.urdf.xacro, sandia_hand_stumps_on_box.urdf.xacro]
2013-04-09 Add another parameter to specify thumb angle, used to move thumbs out of camera frame when joint_type='fixed'
    [sandia_hand_both_on_box.urdf.xacro, sandia_hand_left_on_box.urdf.xacro, sandia_hand_right_on_box.urdf.xacro, sandia_hand_simple_shapes.urdf.xacro, sandia_hand_stumps_on_box.urdf.xacro]
2013-04-12 change accelerometers to report in 12-bit signed format. create skeleton of state estimator node.
2013-04-12 testing damping reduction
    [sandia_hand_simple_shapes.urdf.xacro]
2013-04-12 make the fingers harder, prevent going through objects.
    [sandia_hand.gazebo.xacro]
2013-04-13 hall sensor streaming and running through forward kinematics is getting there. fixed a few bugs in comms schedulers on mobo, and imu orientation on f3.
2013-04-13 improve half-duplex (finger comms) bus scheduling. add a few more checks for bogus finger control packets. improve terminal print stream when programming flash via bootloaders.
2013-04-15 relative finger joint commands, to simplify / robustify the auto finger homing routine
2013-04-16 Revert stump changes to sandia-hands until we're ready to do it for drcsim
    [sandia_hand_both_on_box.urdf.xacro, sandia_hand_left_on_box.urdf.xacro, sandia_hand_right_on_box.urdf.xacro, sandia_hand_simple_shapes.urdf.xacro, sandia_hand_stumps_on_box.urdf.xacro]
2013-04-16 increase maxVel to reduce interpenetration.
    [sandia_hand.gazebo.xacro]
2013-04-16 fix moi for F1 (izz and ixx were backwards). increase velocity limit from 1 to 100.
    [sandia_hand_simple_shapes.urdf.xacro]
2013-04-16 fix merge from revert_stump
    [sandia_hand_simple_shapes.urdf.xacro]
2013-04-17 auto home of proximal and distal-most DOF seems to be ok. middle DOF is causing problems now.
    [main.c]
2013-04-18 implementation of inertial encoding now tries estimating middle finger joints against both measurement singularities, and voting, instead of just trying one or the other and giving up. seems to work 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
2013-04-18 finger accelerometer streaming and auto homing progress.
2013-04-20 working towards a verification/validation test stand for a single finger.
2013-04-22 fix compiler warning in loose finger node. move UI updating in maintenance GUI to the pyqt UI thread. make it red light / green light instead of text lables.
2013-04-22 Branch to use stumps with drcsim, requires simultaneous release
    [sandia_hand_both_on_box.urdf.xacro, sandia_hand_left_on_box.urdf.xacro, sandia_hand_right_on_box.urdf.xacro, sandia_hand_simple_shapes.urdf.xacro, sandia_hand_stumps_on_box.urdf.xacro]
2013-04-23 Test adding contact sensors to palm and fingers
    [sandia_hand.gazebo.xacro, sandia_hand_simple_shapes.urdf.xacro]
2013-04-24 extract parameter values from fingers. working towards having inertial calibration parameters stored on the fingers but applied on the host.
2013-04-25 much hacking on internal driver stuff. working towards streaming calibration parameters out of the fingers and through the driver node to the finger calibration nodes.
    [Finger.cfg]
2013-04-25 Remove sensor and use plugin
    [sandia_hand.gazebo.xacro, sandia_hand_simple_shapes.urdf.xacro]
2013-04-26 Fix palm collision names
    [sandia_hand.gazebo.xacro, sandia_hand_simple_shapes.urdf.xacro]
2013-04-27 tuning sim contact parameters.
    [sandia_hand.gazebo.xacro, sandia_hand_simple_shapes.urdf.xacro]
2013-04-28 Add imu sensor xacro
    [sandia_hand.gazebo.xacro, sandia_hand_simple_shapes.urdf.xacro]
2013-04-29 adaptive damping set at -5 nms/rad for finger joints in simulation.
    [sandia_hand_simple_shapes.urdf.xacro]
2013-04-29 add get_parameters service for each finger, which is used by finger_state_estimater nodes to pull calibration parameters out of each finger.
2013-04-30 FlatBlack for sim visual.
    [sandia_hand.gazebo.xacro]
2013-04-30 Remove debug code
    [sandia_hand.gazebo.xacro]
2013-04-30 Remove line
    [sandia_hand_simple_shapes.urdf.xacro]
2013-04-30 add printfs for distal phalange
2013-05-01 Update contact plugin name
    [sandia_hand.gazebo.xacro]
2013-05-01 reduce default damping to 0.1 Nms/rad, adaptive
    [sandia_hand_simple_shapes.urdf.xacro]
2013-05-01 increase damping to 2.5 for stability
    [sandia_hand_simple_shapes.urdf.xacro]
2013-05-01 reduce damping to 2 Nms / rad.
    [sandia_hand.gazebo.xacro, sandia_hand_simple_shapes.urdf.xacro]
2013-05-02 reducing damping to 1.0 Nms/rad.
    [sandia_hand_simple_shapes.urdf.xacro]
2013-05-02 improve manufacturing GUI during field testing and start creating a fixture for motor modules
2013-05-03 tweak firmware to hardcode support for latest motor modules for now... fix that later to load firmware based on MCU ID table. add beginnings of an automated program and test procedure to maintenance 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
2013-05-08 modify sam3s bootloader to have a slot for hardware version. propagate tweak through all bootloaders. add motor module single-click test to manufacturing GUI
2013-05-09 minimalist 2dof finger tilt/roll dynamixel widget to spin the finger around to gather calibration data.
2013-05-13 Set default camera update rate to 30 Hz
    [sandia_hand.gazebo.xacro]
2013-05-15 working towards a loose palm test fixture and standalone driver
    [palm_cli.cpp]
2013-05-16 stream palm imu every cycle.
2013-05-17 loose palm driver node for manufacturing test stand
2013-05-24 uppped friction coef. to 1.1, zeroed min depth and added max contacts for _base and _palm links.
    [sandia_hand.gazebo.xacro]
2013-05-24 adjust max contacts for _palm
    [sandia_hand.gazebo.xacro]
2013-05-24 fix palm board firmware so that it works for both left and right palms, switching by looking at magic bytes in the bootloader flash area. add test code for finger cycling test during manufacturing. a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
    [main.c]
2013-05-28 retarget pull request #29 for sandia_hand_5.1
    [sandia_hand.gazebo.xacro]
2013-05-29 Fix reflection bug in one of sandia-hand collision/visual shapes
    [sandia_hand_simple_shapes.urdf.xacro]
2013-06-18 add defines for left and right hands. need to be smart now about switching between them
2013-06-19 tie down lots of loose ends to allow easier configuration of hand IP addresses, port allocations, etc. etc. etc.
    [main.c]
2013-07-01 implement a firmware-based circuit breaker that turns off the phalange bus if it's over current for 5ms
2013-07-03 tweaks to the camera init firmware: set the registers multiple times to make sure they go through. tweak phalange circuit breaker constants. default in the ROS driver now is to NOT power the phalange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
2013-07-10 tweak cylindrical grasp so the thumb doesn't crash into the middle finger when it fully closes. make the dual-hand keyboard teleop somewhat more useful.
2013-07-12 remove side-dependent behavior of simple_grasp, since we'll have the first joints of the left hand be mirrored from the right hand, just as in the simulator. this fix can occur in the 'real' hand ROS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
2013-07-16 change firmware/driver behavior to match what the DRC simulator does: the same joint angles produce the same, but mirrored, grasp, when sent to the left vs right hand. More specifically, the first (a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
2013-08-17 add code to poll parameters from the fingers. use this code to poll the current hall encoder offset when setting new offsets, so that you can do cumulative, incremental homing.
2013-08-20 add dummy urdf file for gazebo model directory data structure
    [dummy.urdf]
2013-09-13 Add xacro: to xacro include tags and fix xml namespace
    [sandia_hand.urdf.xacro, sandia_hand_both_on_box.urdf.xacro, sandia_hand_left_on_box.urdf.xacro, sandia_hand_right_on_box.urdf.xacro, sandia_hand_simple_shapes.urdf.xacro, sandia_hand_stumps_on_box.urdf.xacro]
2013-10-24 issue #16, update gazebo xacro so camera topic matches hardware (e.g. /sandia_hands/l_hand/camera/left/image_raw --> /sandia_hands/l_hand/left/image_raw).
    [sandia_hand.gazebo.xacro]
2013-12-06 add frame_id definition to camera images. add some small teleop demo programs.
2014-01-17 fix issue #19 : now you can specify private parameters left/cal_file and right/cal_file to override the arbitrary default camera calibration that ships with the package.
2014-01-17 fix issue #19 : you can now set private parameters left/frame_id and right/frame_id which will propagate into the camerainfo and image message frame_ids. Previously, both left and right images were g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
2014-02-12 address drcsim issue #400 (https://bitbucket.org/osrf/drcsim/issue/400/accurate-models-for-atlas-irobot-and) by copying inertia from sandia_hand_simple_shapes.urdf.xacro into sandia_hand.urdf.xacro.
    [sandia_hand.urdf.xacro]
2015-01-20 Removed collision and visual groups
    [sandia_hand.gazebo.xacro, sandia_hand_simple_shapes.urdf.xacro]
2015-01-20 Removed collision groups
    [sandia_hand_simple_shapes.urdf.xacro]
2015-01-20 revert visual group name
    [sandia_hand.gazebo.xacro]
2015-04-10 update firmware paths to point to where the ros driver include files moved. also update firmware build instructions for ubuntu 14.04
2022-03-17 import wiki documentation
    [f2.PcbDoc, f3.PcbDoc, finger_pogo.PcbDoc, left_conn.PcbDoc, right_conn.PcbDoc]
2022-03-17 rename doc -> docs for GitHub Pages
    [f2.PcbDoc, f3.PcbDoc, finger_pogo.PcbDoc, left_conn.PcbDoc, right_conn.PcbDoc]
